neo12242/RykerConnect/Hardware/REV05C-12V/PRD.md

# 12V cost reduction

User authorization: "keep trying to get closer to $100 without losing any function."

1. Problem: five REV05-12V carriers quote at $126.65 before shipping/tax; feeder fees dominate.
2. Success: move toward $100, preferably below, preserving all user-facing functions and protection.
3. Scope: qualify equivalent lower-fee components; calculate savings against the actual order; prepare a clearly identified quote/review BOM.
4. Out of scope: removing RTC, battery backup, sensors, sockets, protection, or factory assembly; orders/payments.
5. Constraints: keep original manufacturing package intact; do not present an unvalidated alternate as production-ready.
6. Approach: Basic passive replacements first; Basic crystal subject to manufacturer footprint/keepout; protection substitutions only after electrical checks.
7. Implementation: compare primary datasheets/catalog; record quantities/prices/fee classes; produce candidate BOM and cost breakdown. Native design changes and manufacturing release require completed electrical/layout validation.
8. Risks: Basic/Preferred classification can change; quote attrition and loading exemptions affect savings; price estimates are not checkout quotes.
9. Open questions: final cart total and shipping/tax remain unknown. No function removal is authorized.

Implemented: six Basic substitutions and validated crystal copper clearance. Estimated five-board total $105.30 before shipping/tax.
