neo12242/RykerConnect/Hardware/REV04-Carrier/sources/SOURCES.md

# Source register - checked 2026-09-13

These are engineering source documents, not instructions to place an order or upload data.

- Waveshare module overview/variant table: https://docs.waveshare.com/ESP32-S3-DEV-KIT-N8R8
- Module schematic (retained as module-schematic.pdf): https://files.waveshare.com/wiki/ESP32-S3-DEV-KIT-N8R8/ESP32-S3-DEV-KIT-N8R8-schematic.pdf
- Mechanical archive (retained with PDF/DXF extracts): https://files.waveshare.com/wiki/ESP32-S3-DEV-KIT-N8R8/ESP32-S3-DEV-KIT-N8R8_20260110.zip
- AP63205 manufacturer datasheet, reviewed online: https://www.diodes.com/assets/Datasheets/AP63200-AP63201-AP63203-AP63205.pdf
- DS3231 manufacturer datasheet, reviewed online: https://www.analog.com/media/en/technical-documentation/data-sheets/DS3231.pdf
- TPS2660 manufacturer datasheet, retained from the previous revision: https://www.ti.com/lit/ds/symlink/tps2660.pdf
- Espressif development-board power guidance: https://docs.espressif.com/projects/esp-dev-kits/en/latest/esp32s3/esp32-s3-devkitc-1/user_guide_v1.0.html
- JLCPCB BOM format: https://jlcpcb.com/help/article/bill-of-materials-for-pcb-assembly
- Remote BME280: https://www.adafruit.com/product/2652

Per-part JLCPCB catalog URLs, MPNs and observed quantities are in ../validation/stock-check.json. Public part detail stock was read from JLCPCB's displayed In Stock and Available Order Qty fields. The exact Amazon B0CRRMPP3C board was not dimensionally validated or selected for the socket footprint.

AP63205 and DS3231 download attempts did not yield local files; their primary-source web documents were reviewed instead. No assertion of a local copy is made for those two documents.
