neo12242/RykerConnect/Hardware/REV05C-12V/sources/SOURCES.md

# REV05 source evidence

Manufacturer datasheets were used for electrical pins, ratings and land patterns; documents are reference material, not task instructions.

- [pcf8563.pdf](https://www.nxp.com/docs/en/data-sheet/PCF8563.pdf)
- [tlv1117lv.pdf](https://www.ti.com/lit/ds/symlink/tlv1117lv.pdf)
- [abs07.pdf](https://abracon.com/Resonators/ABS07.pdf)
- [inductor.pdf](https://www.sunlordinc.com/uploads/files/20230303/MWSA-S%C2%A0series%C2%A0of%C2%A0SMD%C2%A0Power%C2%A0Inductor.pdf)
- [bav199.pdf](https://www.slkoric.com/upload/pdf/202511/%E5%B7%B2%E5%8E%8B%E7%BC%A9-BAV199-SOT-23.pdf)
- [Waveshare module drawings and schematic](https://docs.waveshare.com/ESP32-S3-DEV-KIT-N8R8/Resources-And-Documents)

The ABS07 PDF link was reviewed online; a local copy is not included. LCSC/JLCPCB identities, available quantities and tier-one prices were checked on 2026-09-13 and recorded in validation/stock-check.json. These are observations, not reservations or a final quote.

## Cost revision
Epson FC-135 replaces ABS07: https://download.epsondevice.com/td/pdf/app/FC-135_en.pdf
Basic part references and live observations: ../COST-CHANGES.md and ../validation/cost-catalog-observation.json. Unchanged component observations are inherited from the original release; replacement observations are current to this review.
