neo12242/RykerConnect/Hardware/REV02-Corrected/sources/molex.png

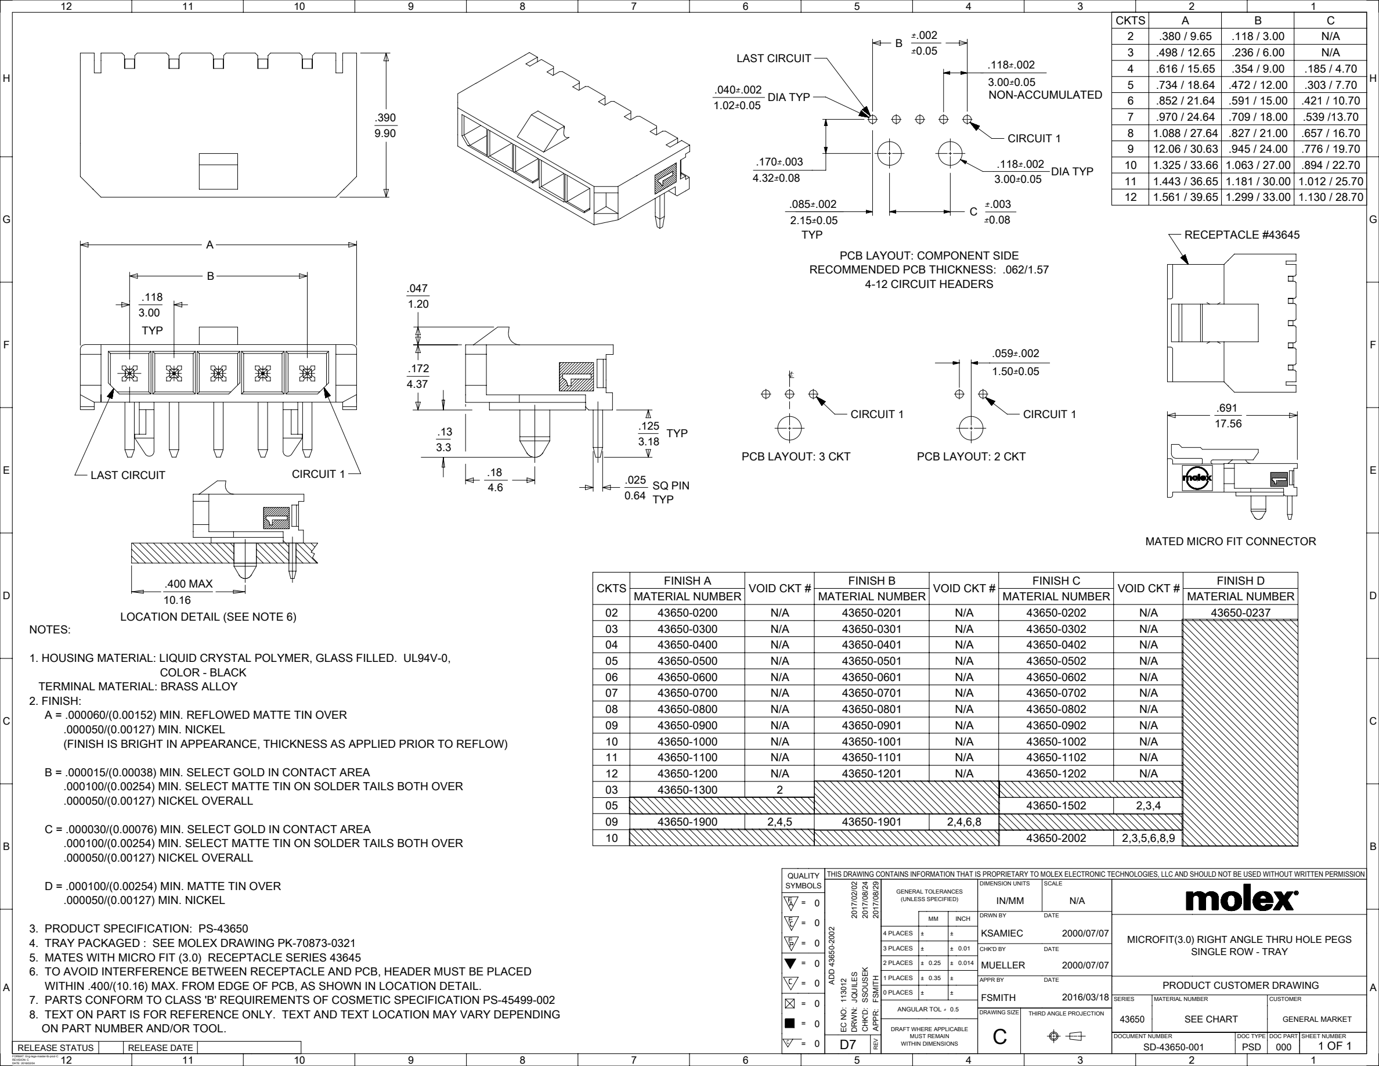
Hardware/REV02-Corrected/sources/molex.png
