neo12242/RykerConnect/Hardware/REV03-Protected/sources/lm7480-reference.png

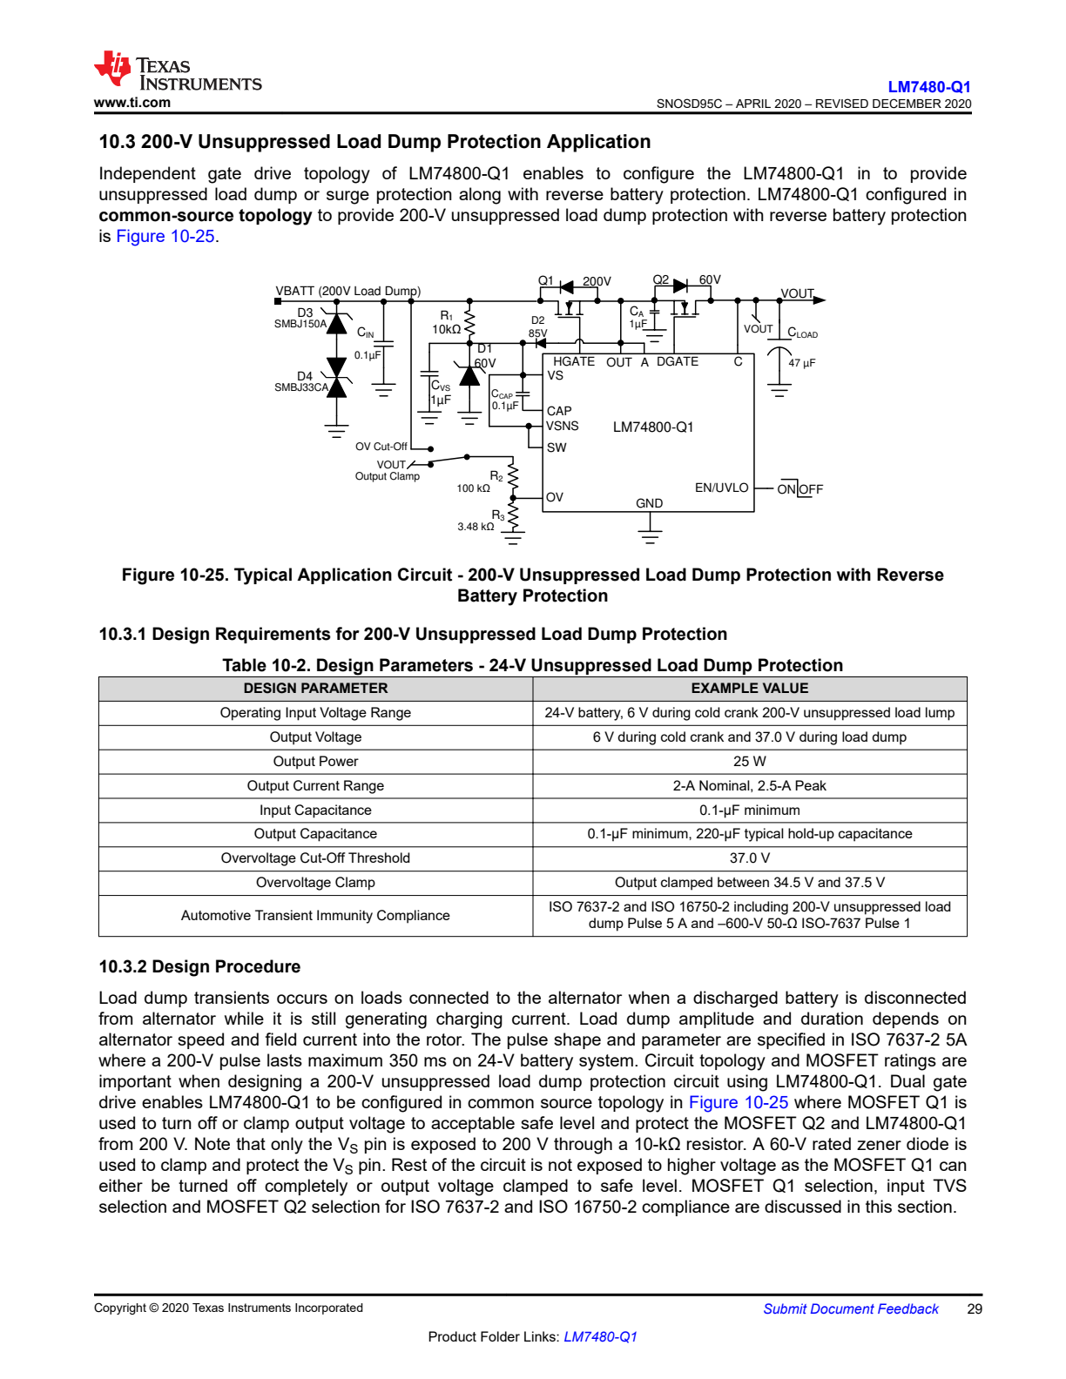
Hardware/REV03-Protected/sources/lm7480-reference.png
