neo12242/RykerConnect/Hardware/REV03-Protected/sources/tps-4.png

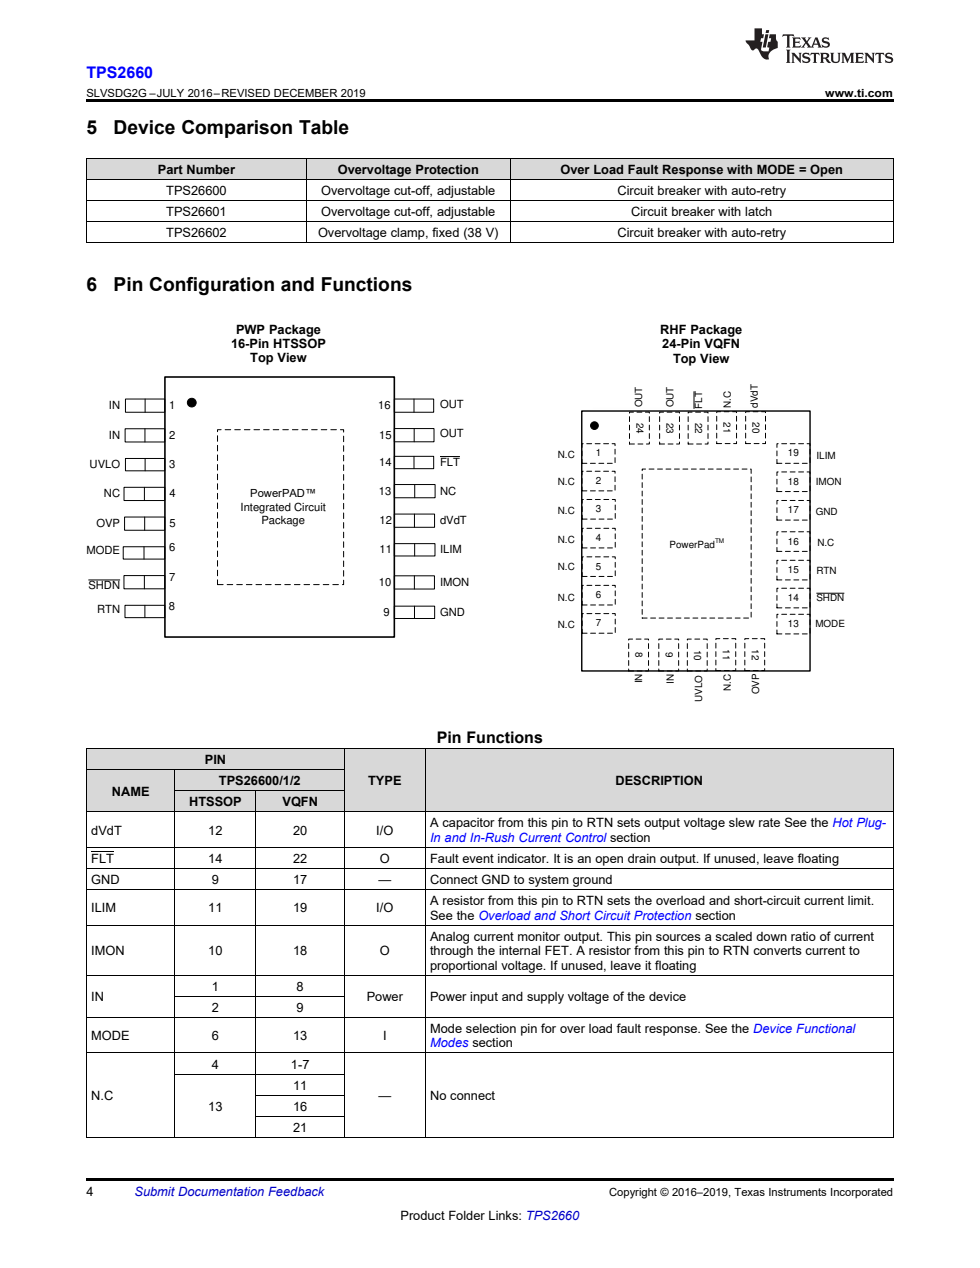
Hardware/REV03-Protected/sources/tps-4.png
