neo12242/RykerConnect/Hardware/REV03-Protected/sources/tps-28.png

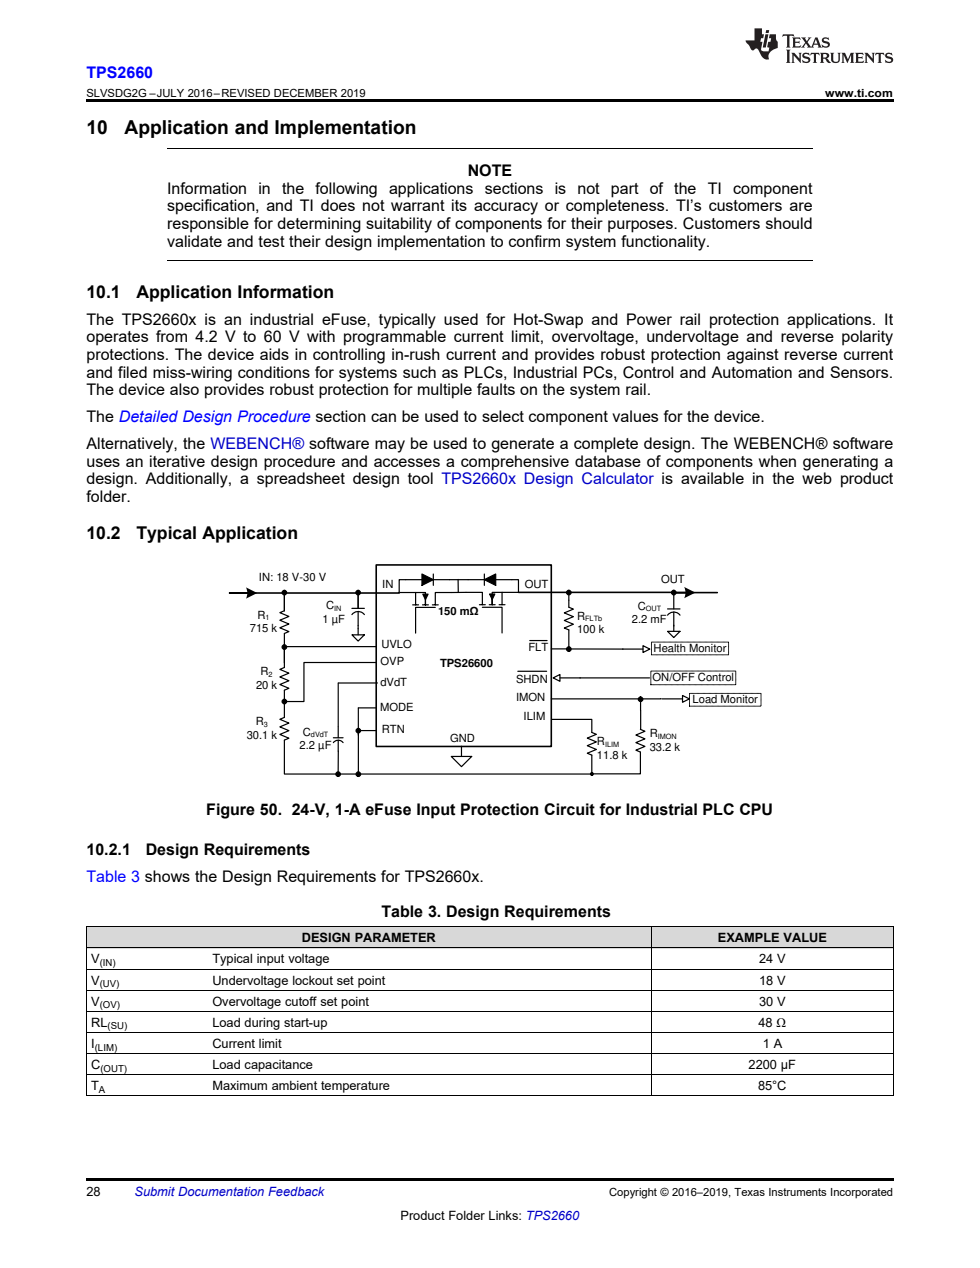
Hardware/REV03-Protected/sources/tps-28.png
