neo12242/RykerConnect/Hardware/REV03-Protected/sources/tps-40.png

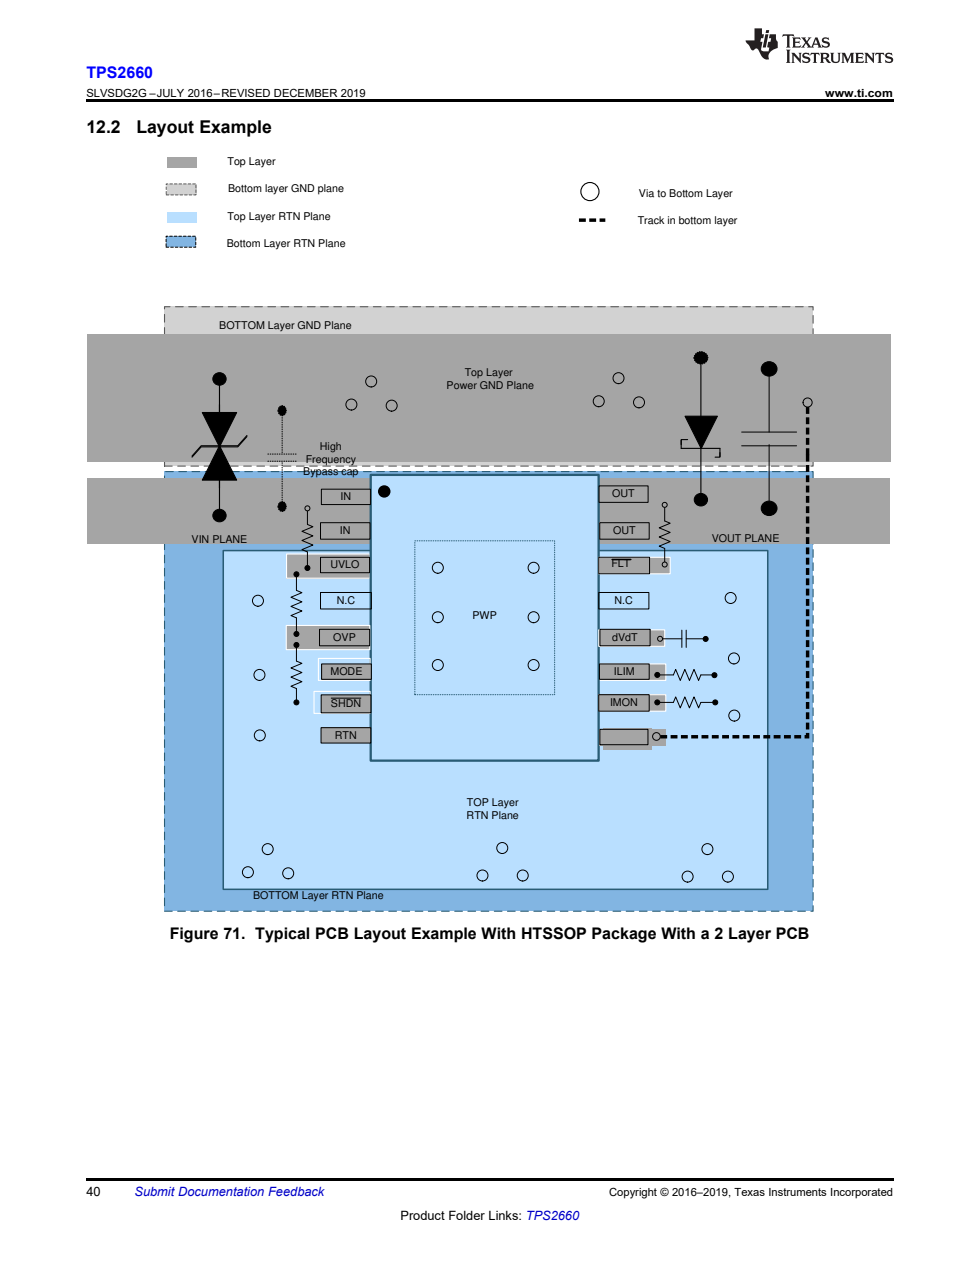
Hardware/REV03-Protected/sources/tps-40.png
