neo12242/RykerConnect/Hardware/REV03-Protected/sources/tps-49.png

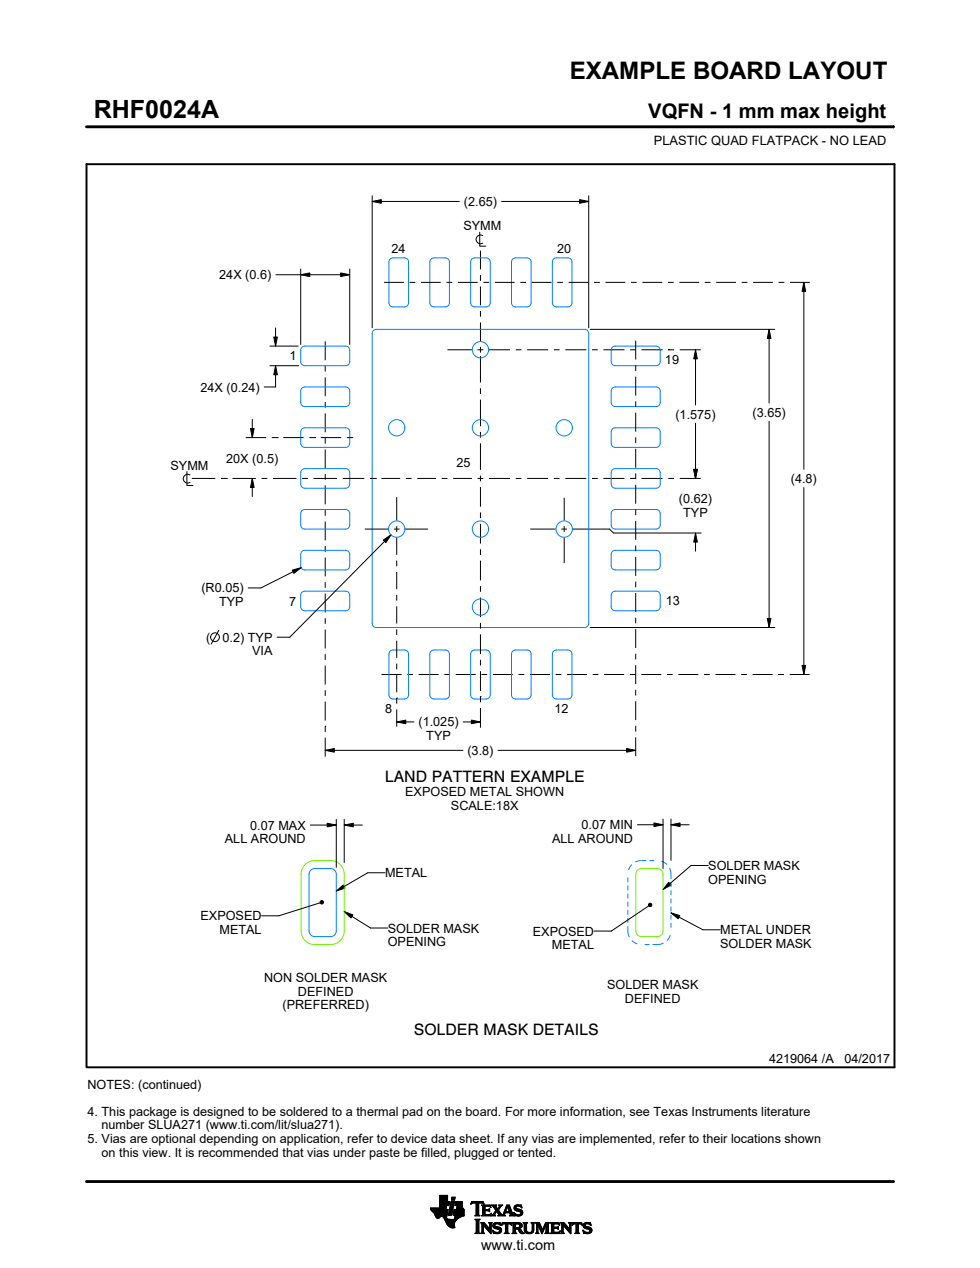
Hardware/REV03-Protected/sources/tps-49.png
