neo12242/RykerConnect/Hardware/REV03-Protected/sources/tps-pwp-land.png

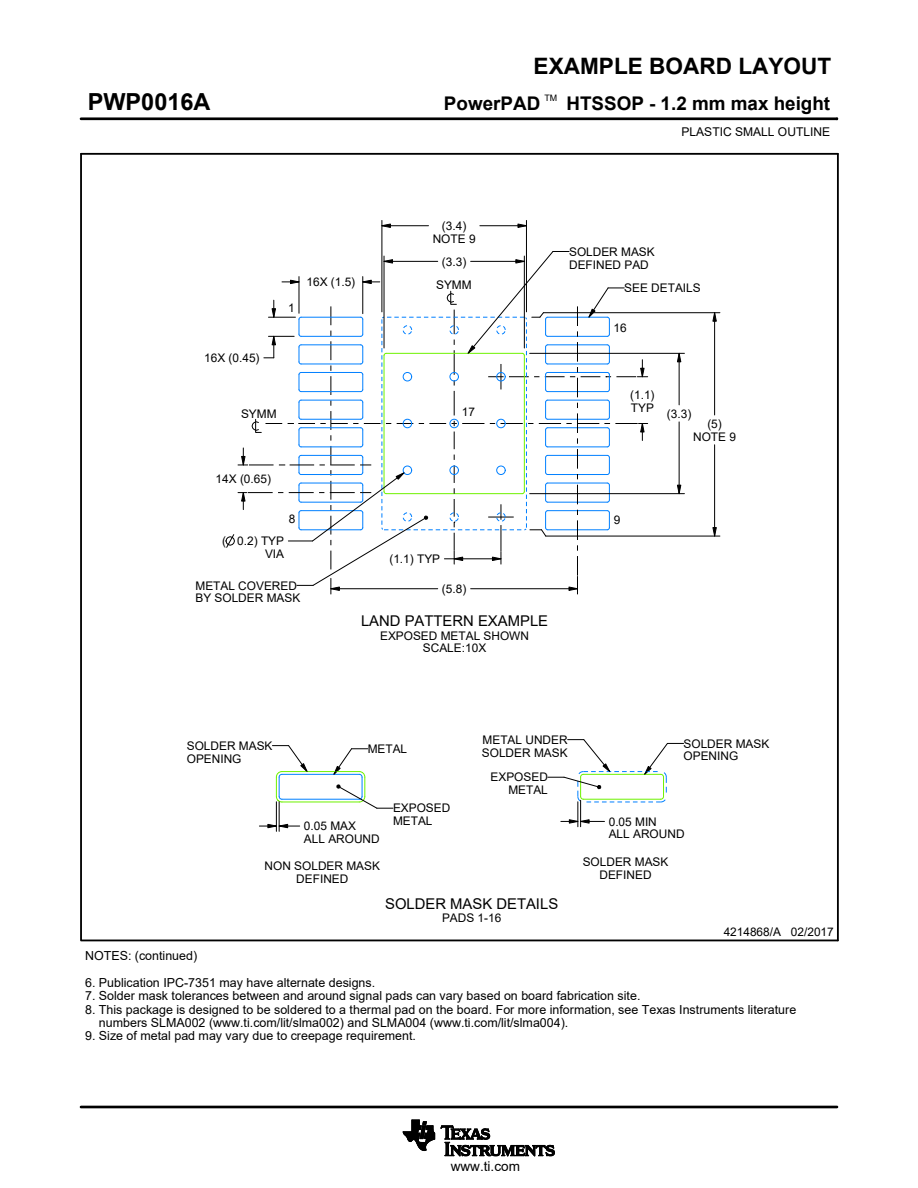
Hardware/REV03-Protected/sources/tps-pwp-land.png
