neo12242/RykerConnect/Hardware/REV03-Protected/validation/protection-schematic.png

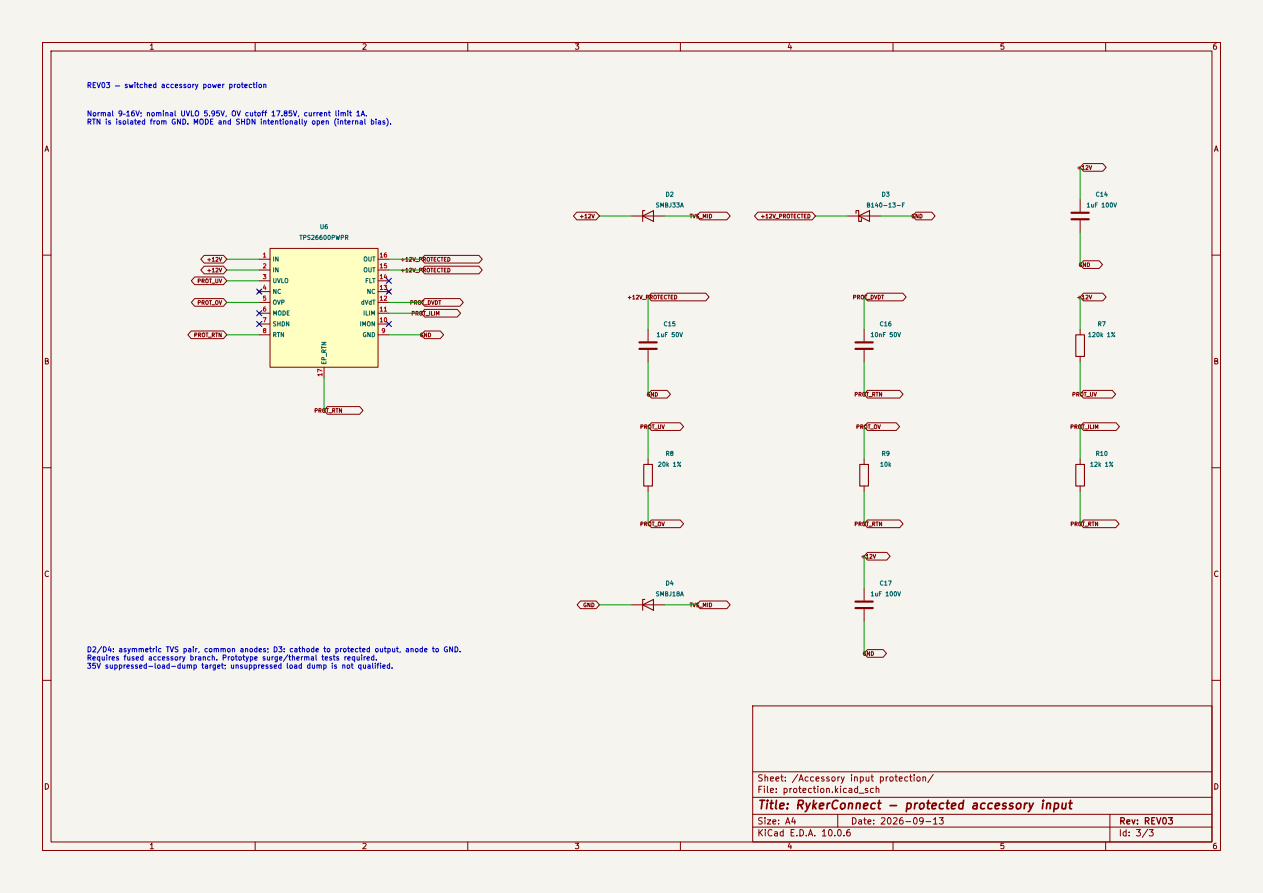
Hardware/REV03-Protected/validation/protection-schematic.png
