neo12242/RykerConnect/Hardware/REV04-Carrier/sources/module-mechanical.png

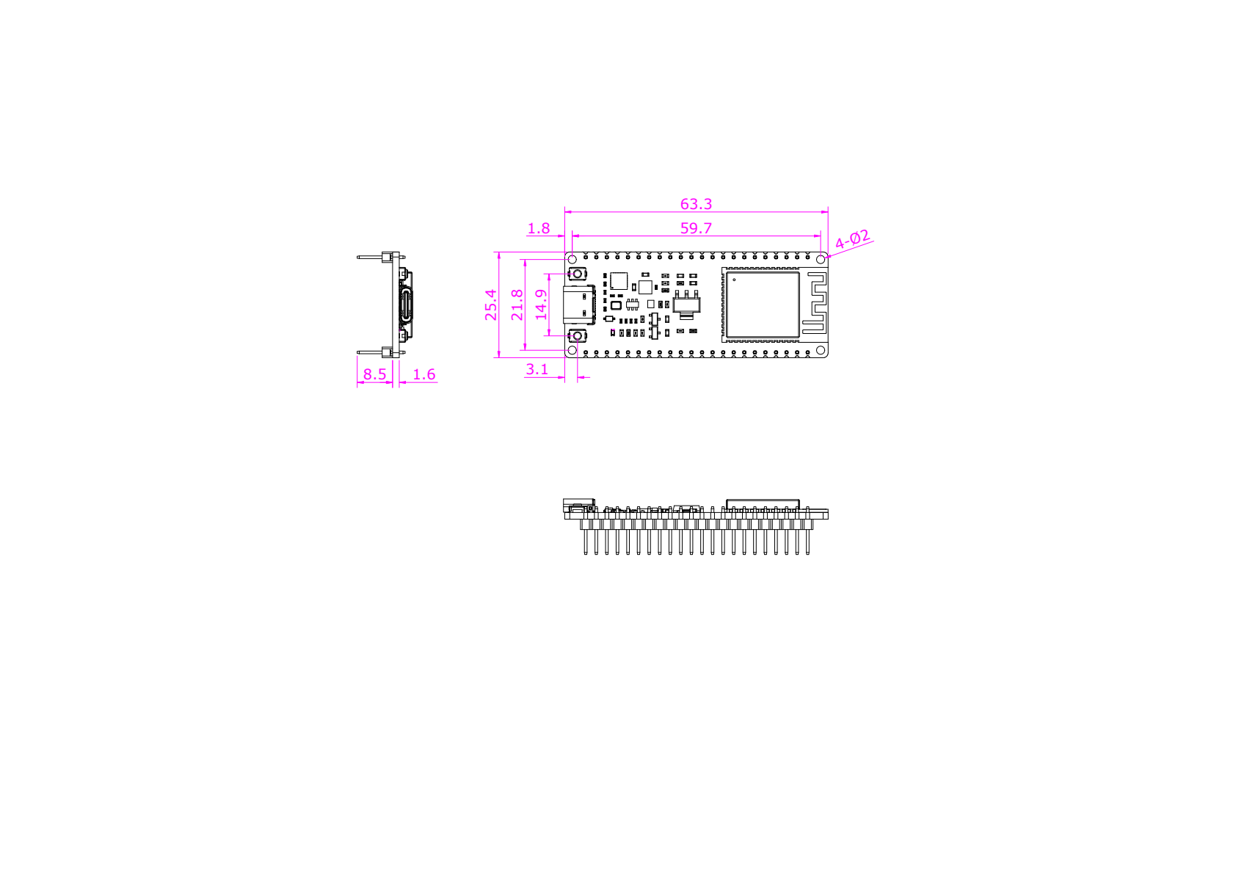
Hardware/REV04-Carrier/sources/module-mechanical.png
