neo12242/RykerConnect/Hardware/REV04-Carrier/sources/module-schematic.png

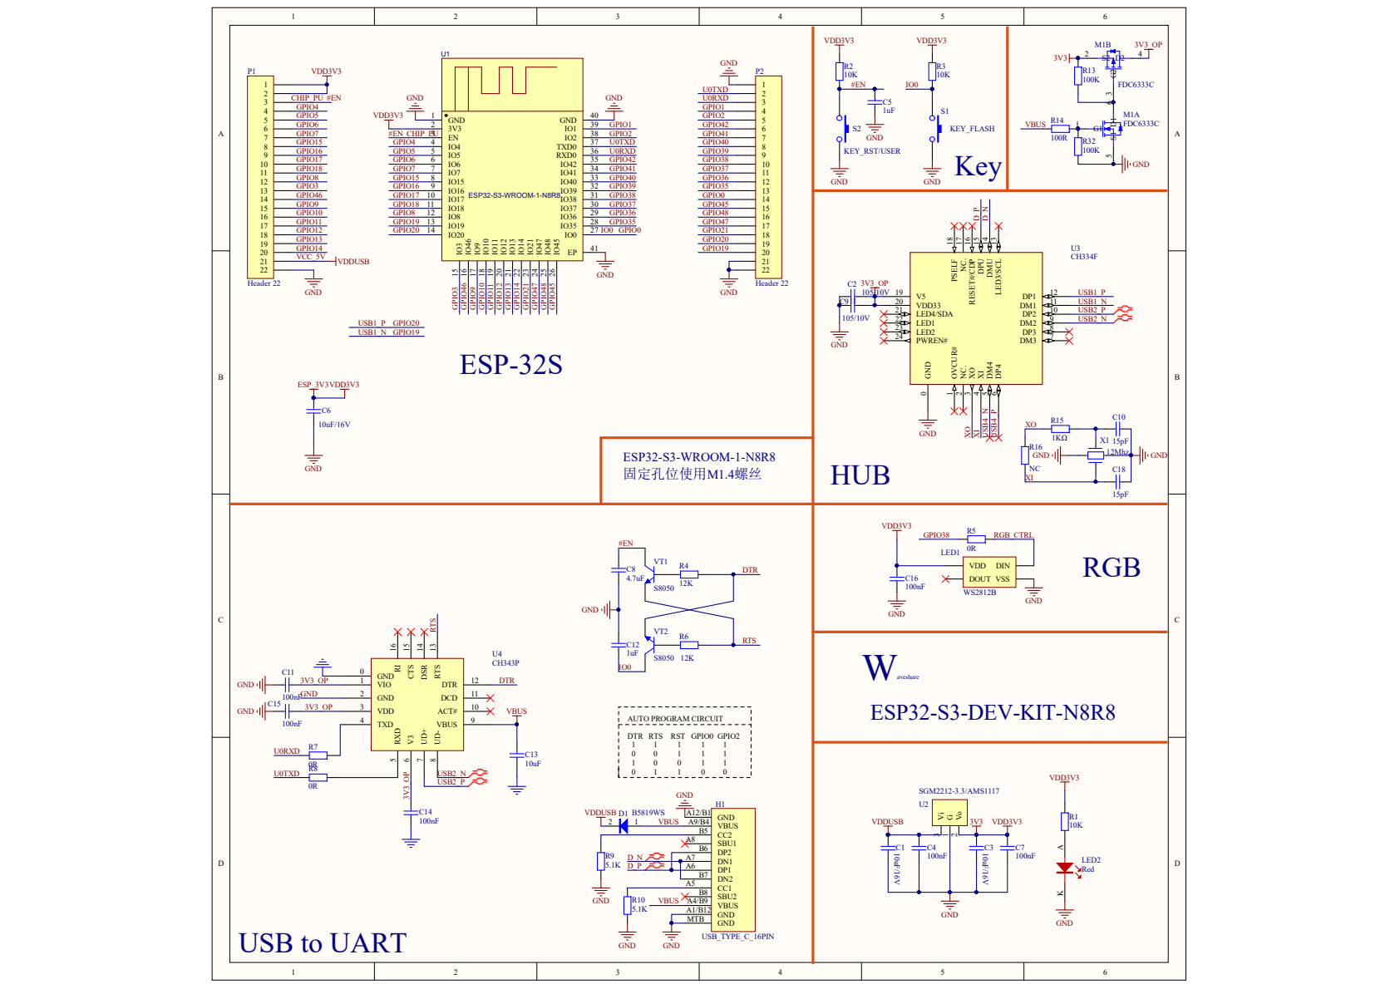
Hardware/REV04-Carrier/sources/module-schematic.png
