neo12242/RykerConnect/Hardware/REV04-Carrier/validation/schematic-1.png

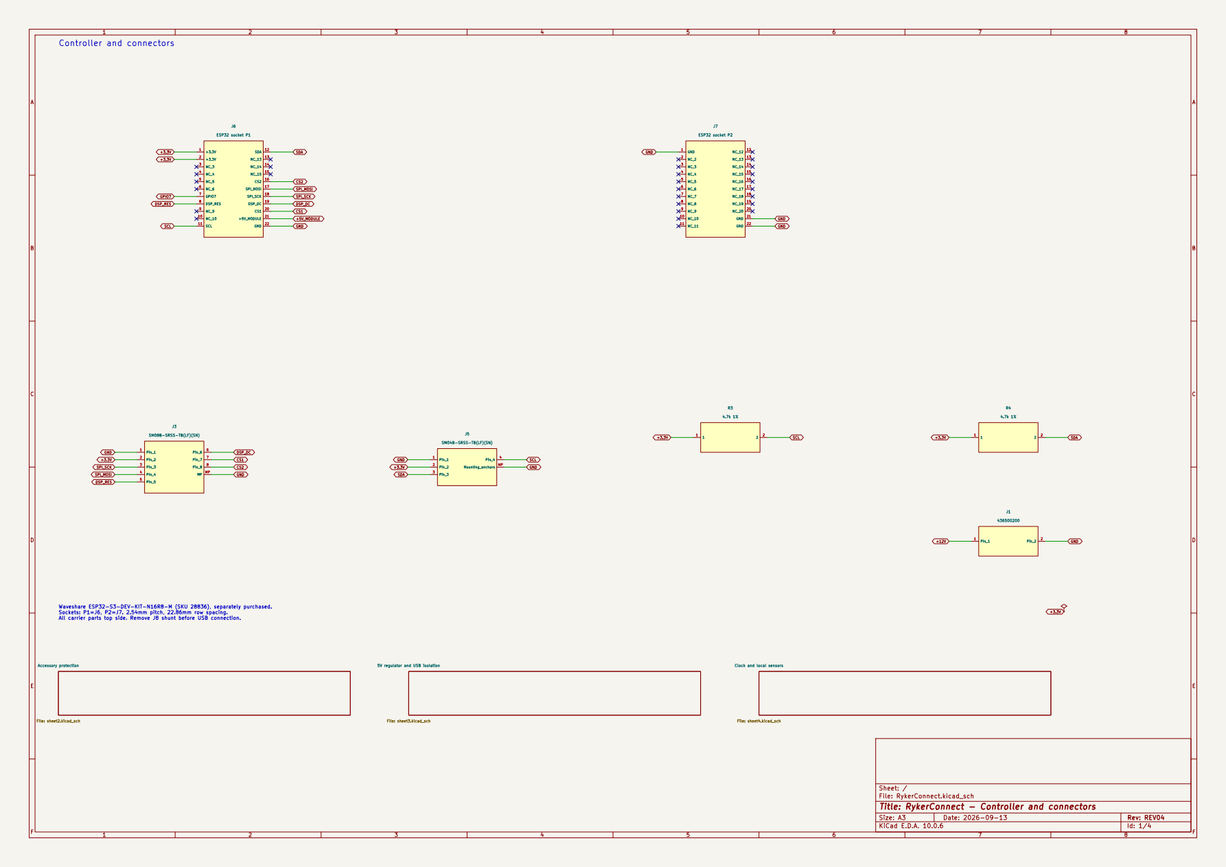
Hardware/REV04-Carrier/validation/schematic-1.png
