neo12242/RykerConnect/Hardware/REV04-Carrier/validation/schematic-2.png

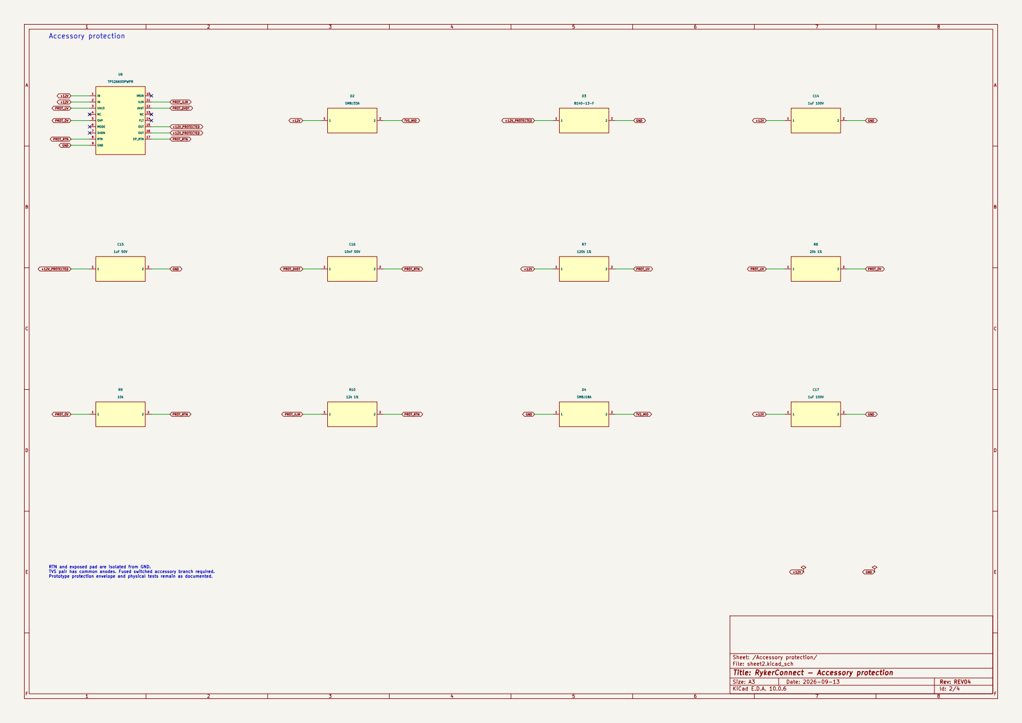
Hardware/REV04-Carrier/validation/schematic-2.png
