neo12242/RykerConnect/Hardware/REV04-Carrier/validation/schematic-3.png

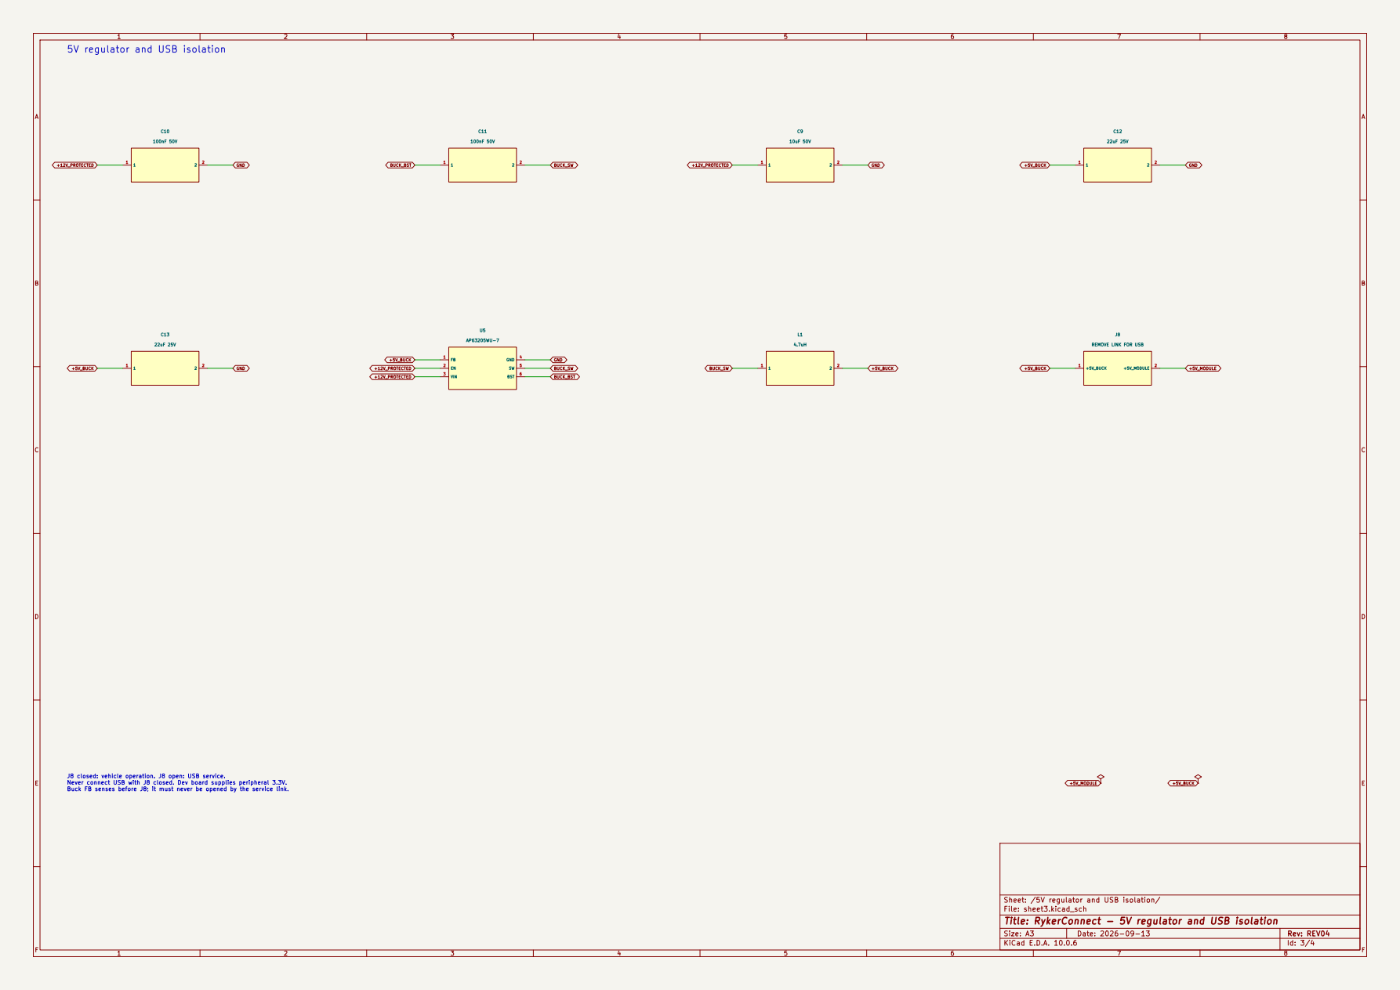
Hardware/REV04-Carrier/validation/schematic-3.png
