neo12242/RykerConnect/Hardware/REV04-Carrier/validation/schematic-4.png

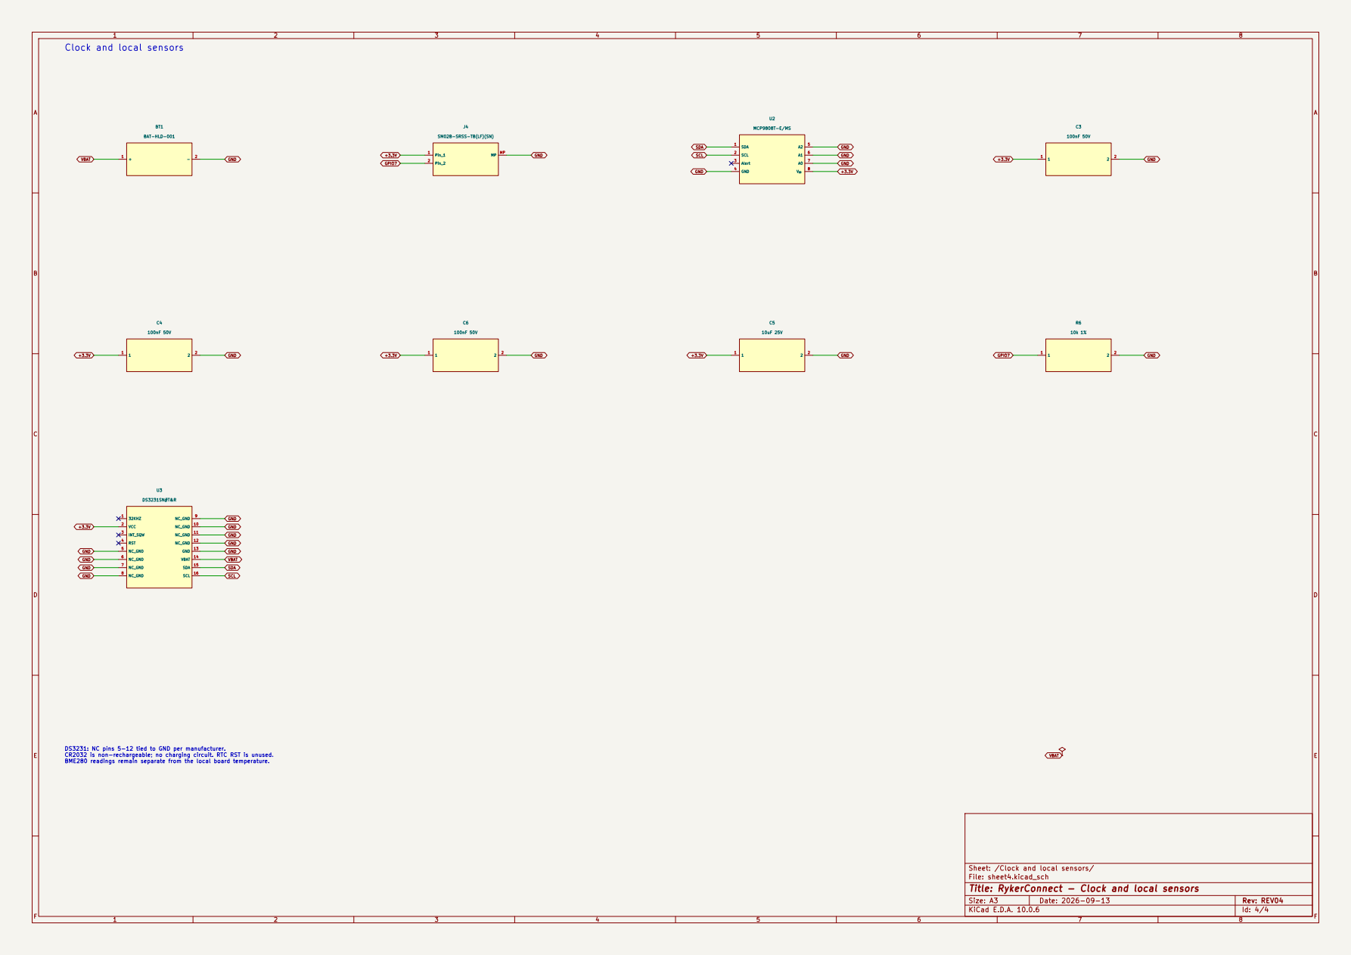
Hardware/REV04-Carrier/validation/schematic-4.png
