neo12242/RykerConnect/Hardware/REV05-12V/sources/bav199.png

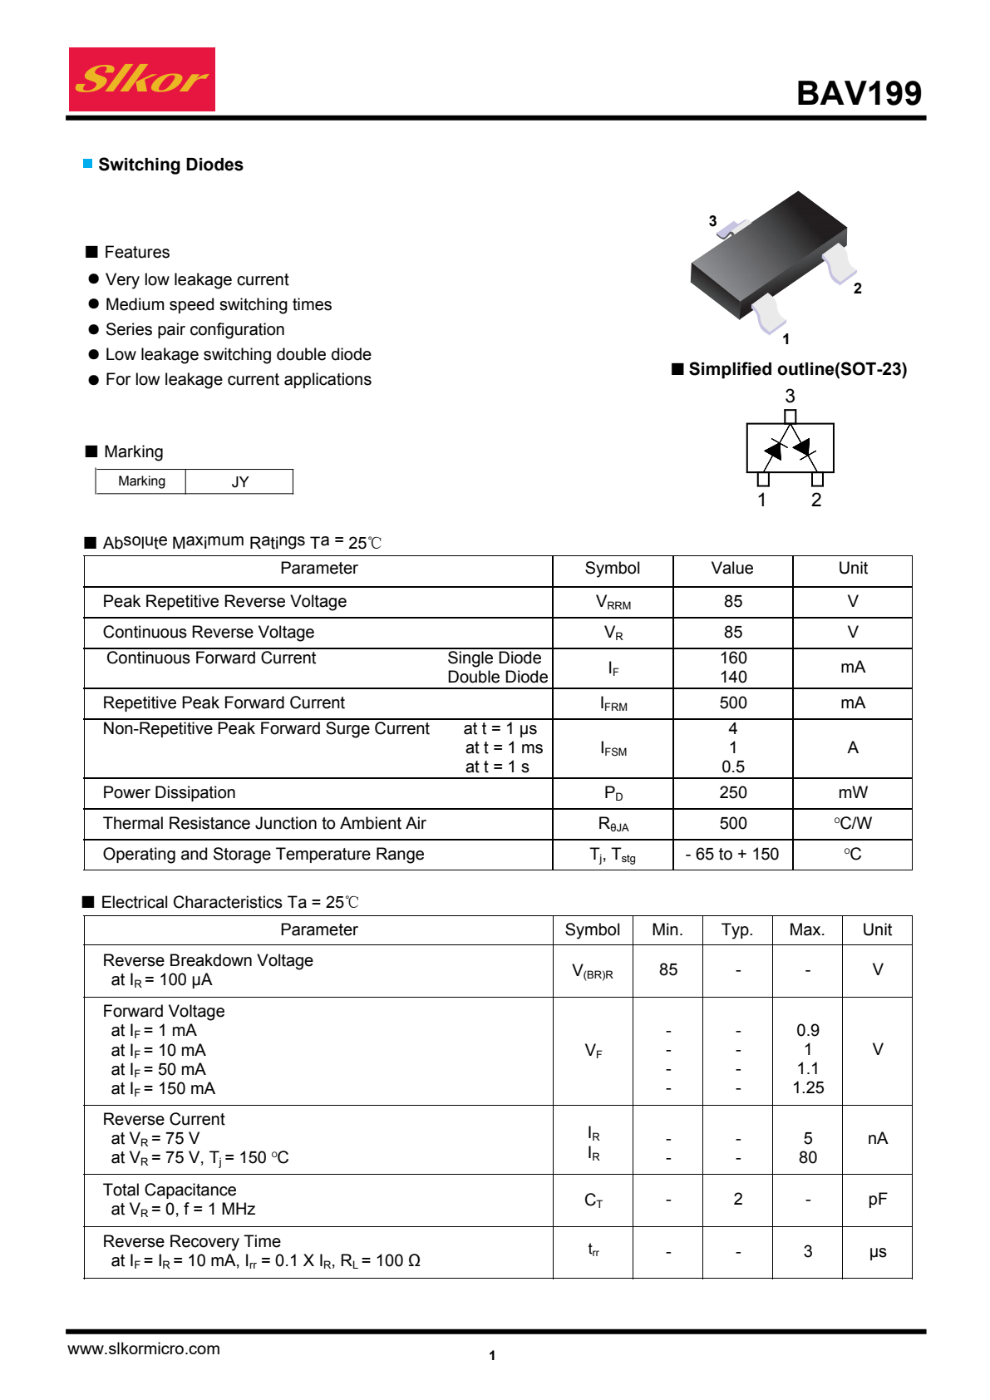
Hardware/REV05-12V/sources/bav199.png
