neo12242/RykerConnect/Hardware/REV05-12V/sources/inductor-land.png

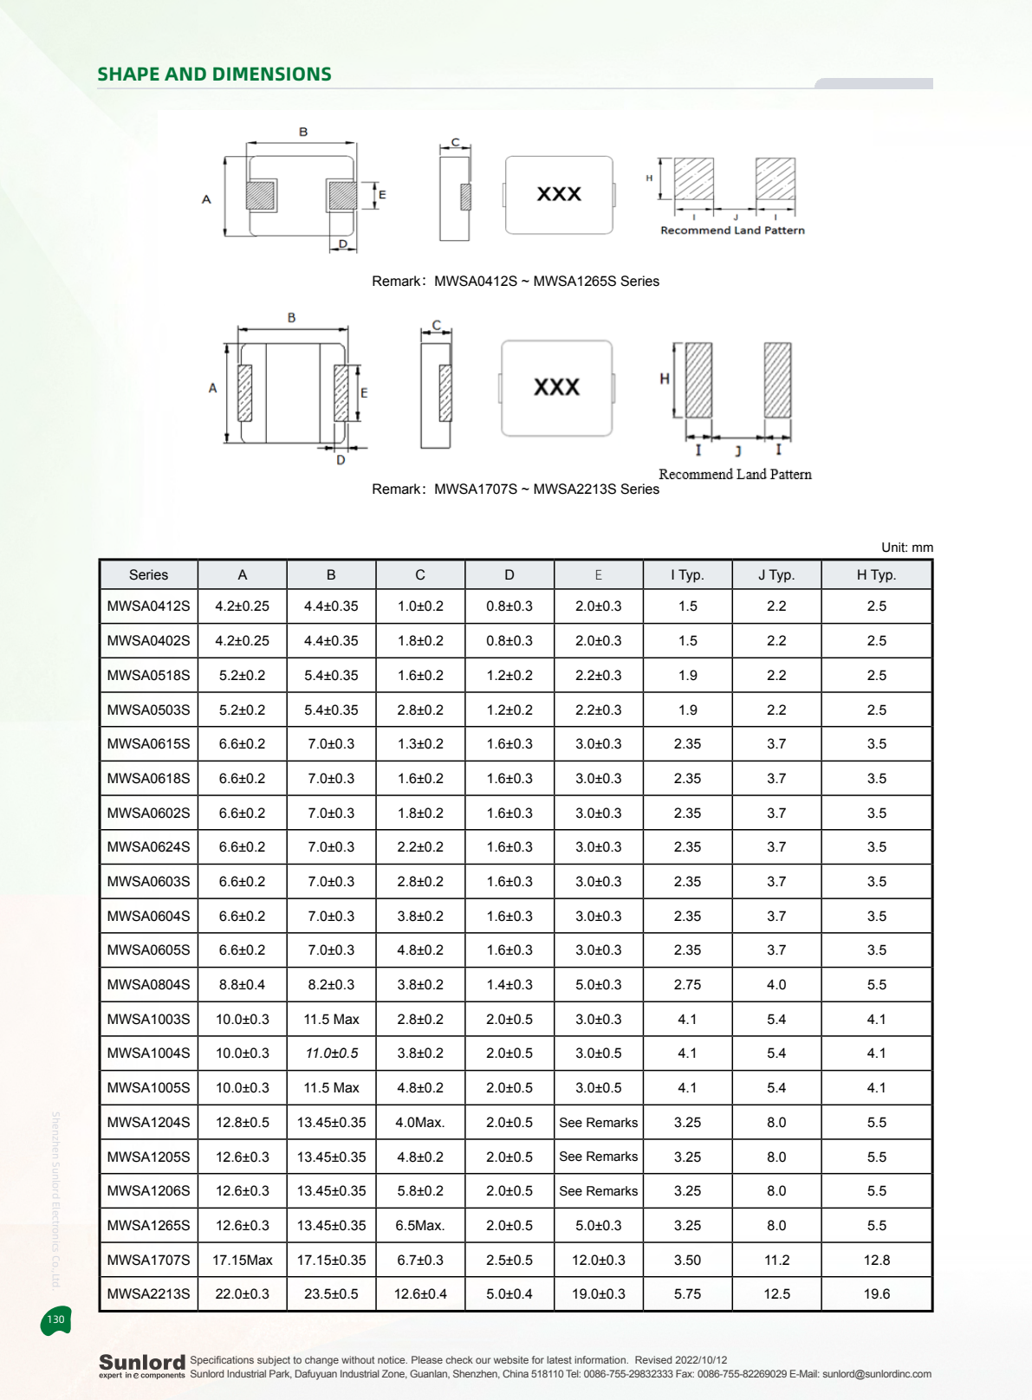
Hardware/REV05-12V/sources/inductor-land.png
