neo12242/RykerConnect/Hardware/REV05-12V/validation/schematic-4.png

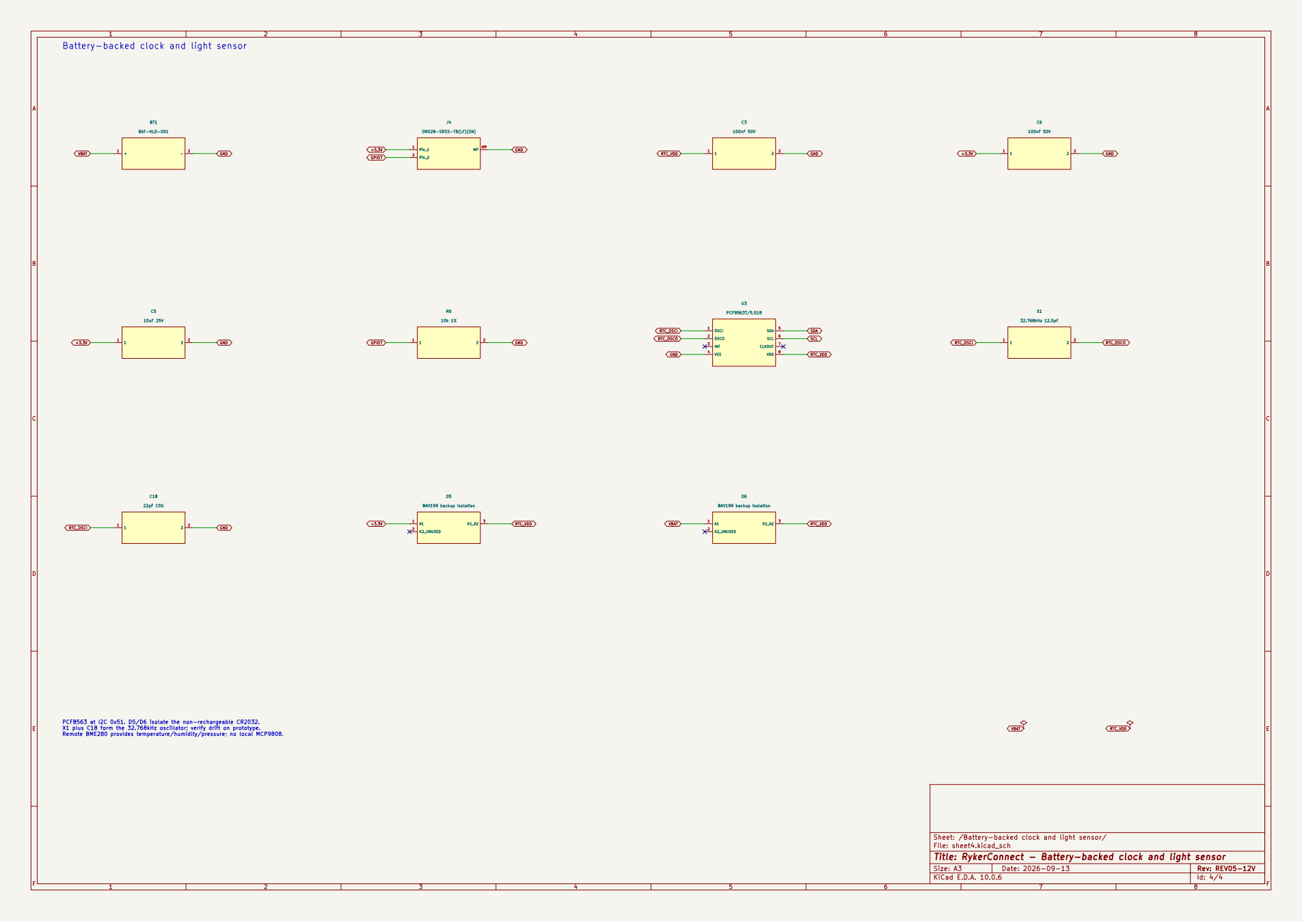
Hardware/REV05-12V/validation/schematic-4.png
