neo12242/RykerConnect/Hardware/REV05-USB/validation/schematic-2.png

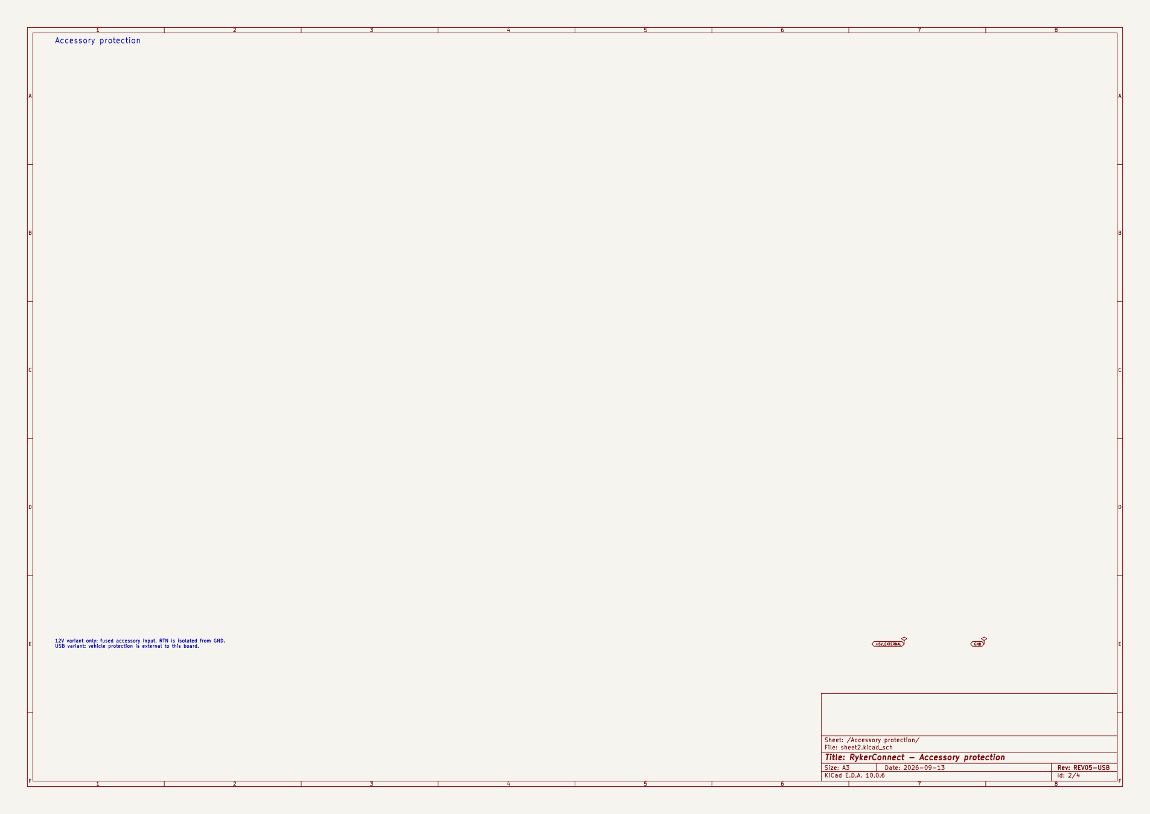
Hardware/REV05-USB/validation/schematic-2.png
