neo12242/RykerConnect/Hardware/REV05-USB/validation/schematic-3.png

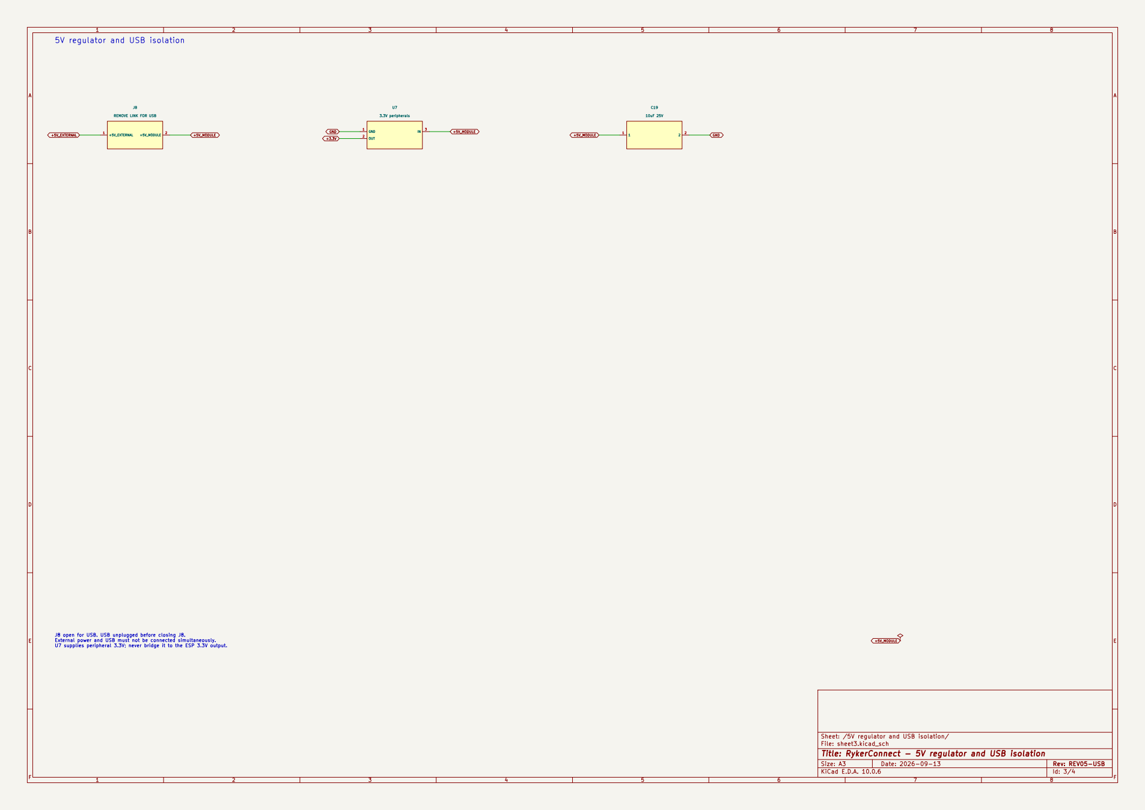
Hardware/REV05-USB/validation/schematic-3.png
