neo12242/RykerConnect/Hardware/REV05C-12V/validation/schematic-2.png

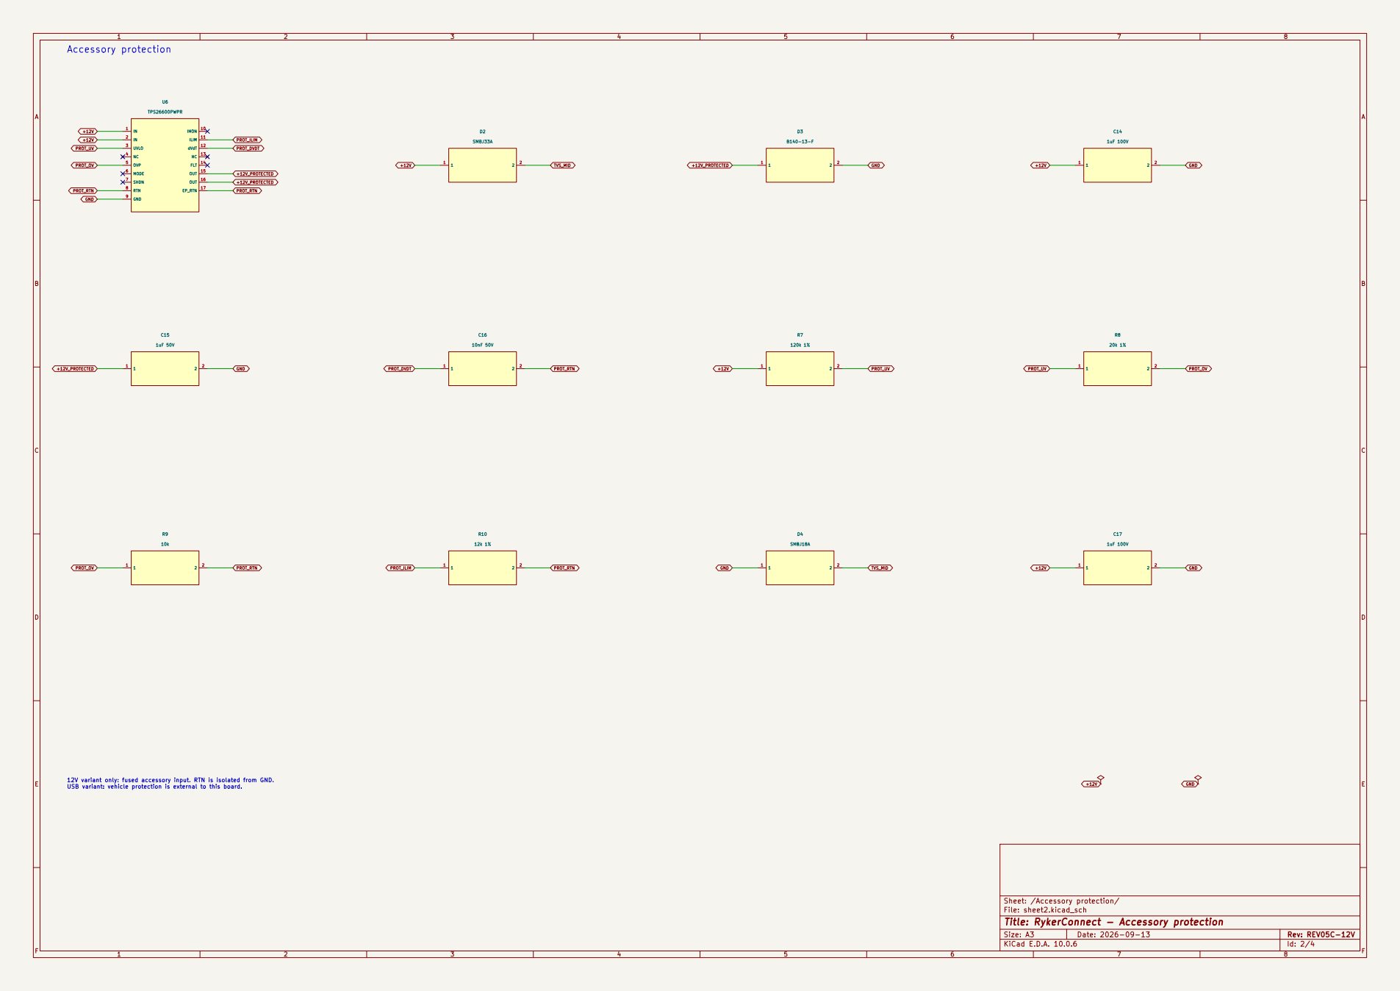
Hardware/REV05C-12V/validation/schematic-2.png
