neo12242/RykerConnect/Hardware/REV04-Carrier/sources/module.dxf

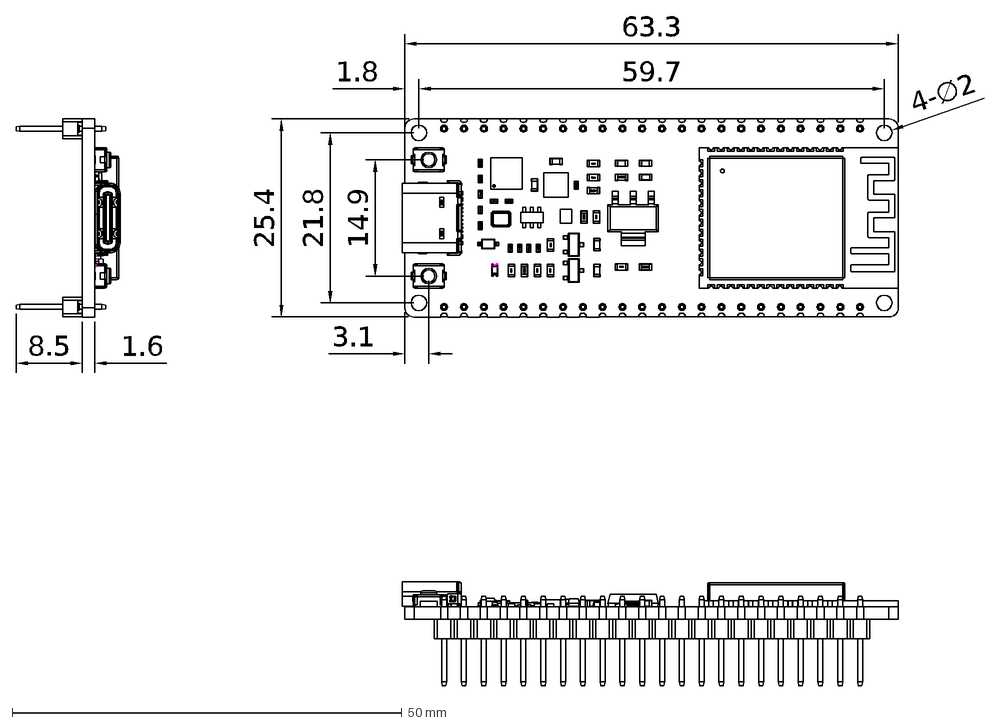
[picture p27: CAD file, 2026-09-16]
Hardware/REV04-Carrier/sources/module.dxf
63.3
21.8
25.4
14.9
4-∅2
59.7
1.8
1.6
8.5
3.1
