neo12242/RykerConnect/Hardware/REV03-Protected/validation/assembly-B.png

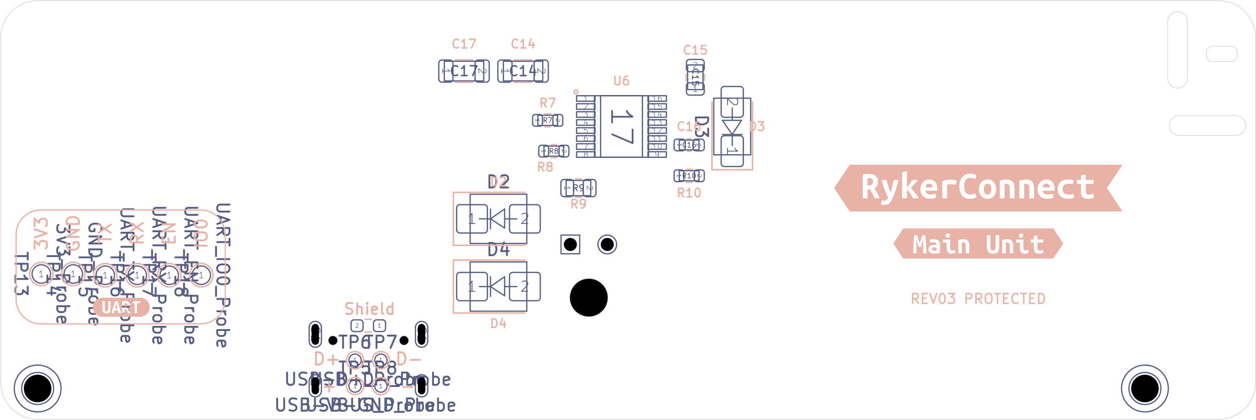
Hardware/REV03-Protected/validation/assembly-B.png
