neo12242/RykerConnect/Hardware/REV04-Carrier/validation/assembly-F.png

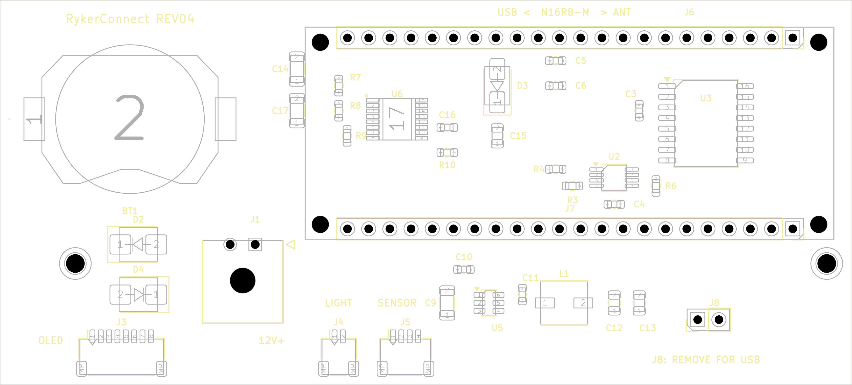
Hardware/REV04-Carrier/validation/assembly-F.png
