neo12242/RykerConnect/Hardware/REV05-12V/validation/assembly-F.png

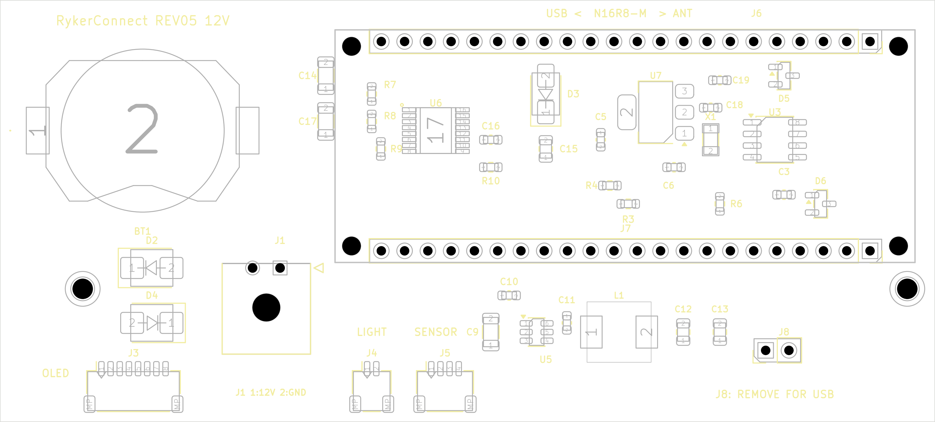
Hardware/REV05-12V/validation/assembly-F.png
