neo12242/RykerConnect/Hardware/REV05-USB/validation/assembly-F.png

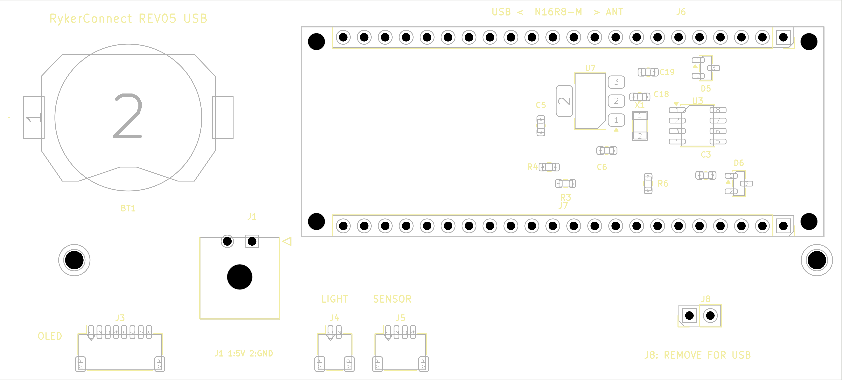
Hardware/REV05-USB/validation/assembly-F.png
