neo12242/RykerConnect/Hardware/REV02-Corrected/validation/before.png

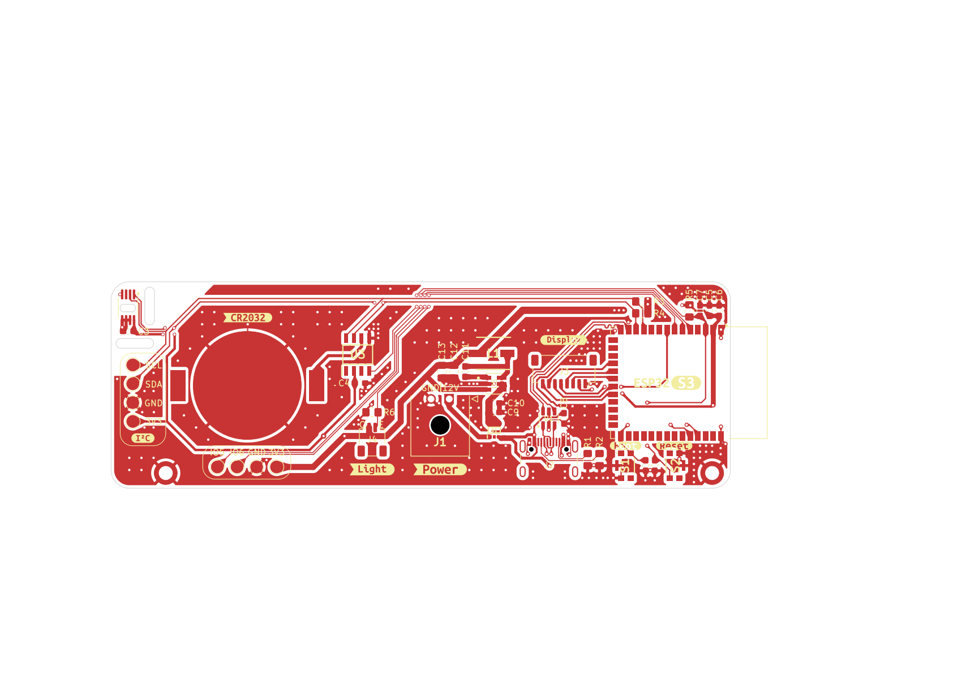
Hardware/REV02-Corrected/validation/before.png
