neo12242/RykerConnect/Hardware/REV03-Protected/validation/board-B.png

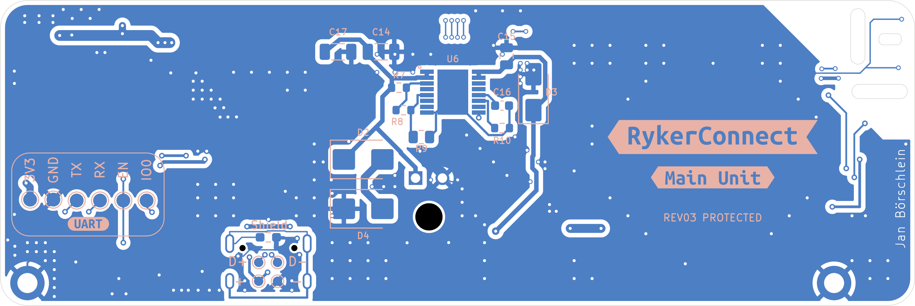
Hardware/REV03-Protected/validation/board-B.png
