neo12242/RykerConnect/Hardware/REV04-Carrier/validation/board-B.png

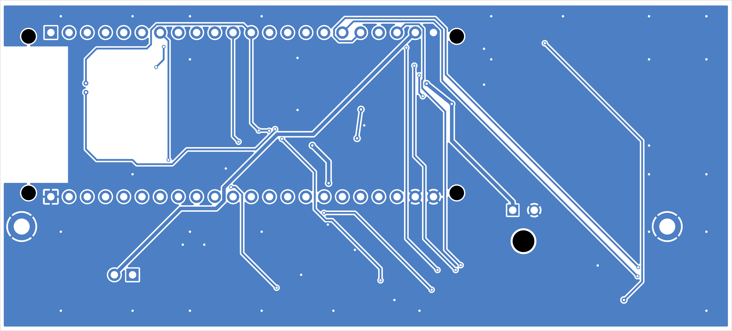
Hardware/REV04-Carrier/validation/board-B.png
