neo12242/RykerConnect/Hardware/REV04-Carrier/validation/board-F.png

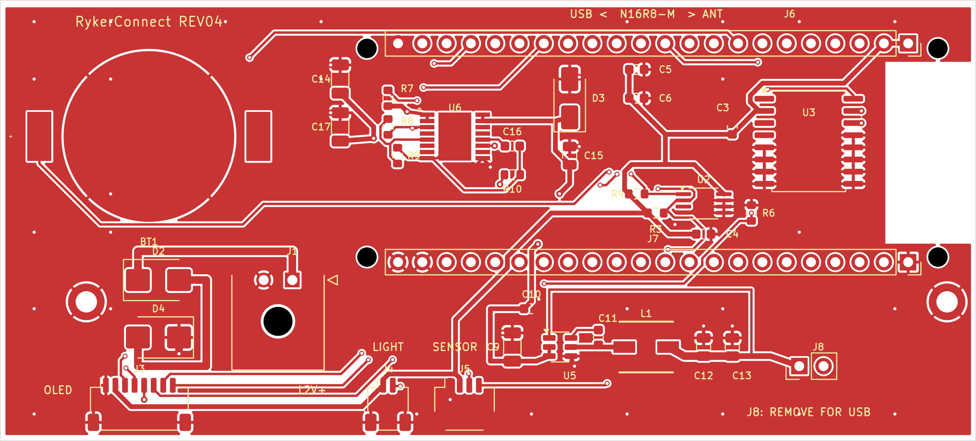
Hardware/REV04-Carrier/validation/board-F.png
