neo12242/RykerConnect/Hardware/REV02-Corrected/validation/schematics.pdf

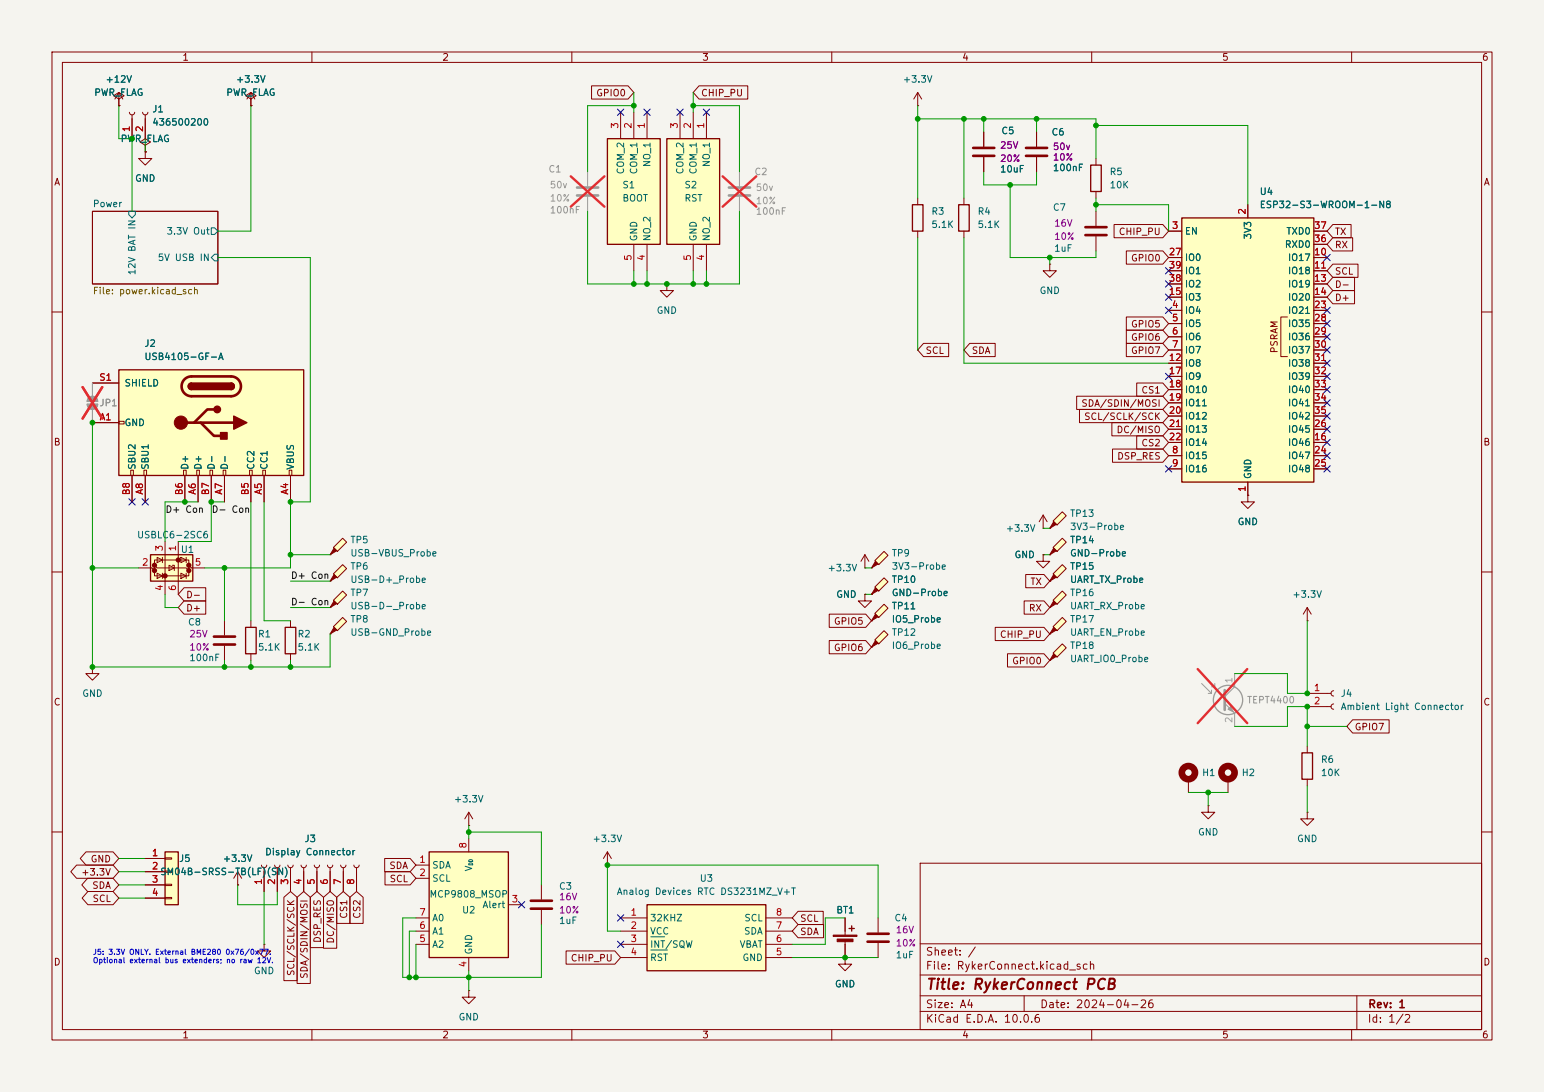
[picture p36: page 1]

1 COM_1
Ambient Light Connector +3.3V +3.3V GND NO_1

SCL SDA SCL/SCLK/SCK SDA/SDIN/MOSI

Analog Devices RTC DS3231MZ_V+T GND

J5: 3.3V ONLY. External BME280 0x76/0x77. Optional external bus extenders; no raw 12V.

Size: A4 | Rev: 1
KiCad E.D.A. 10.0.6 | Id: 1/2

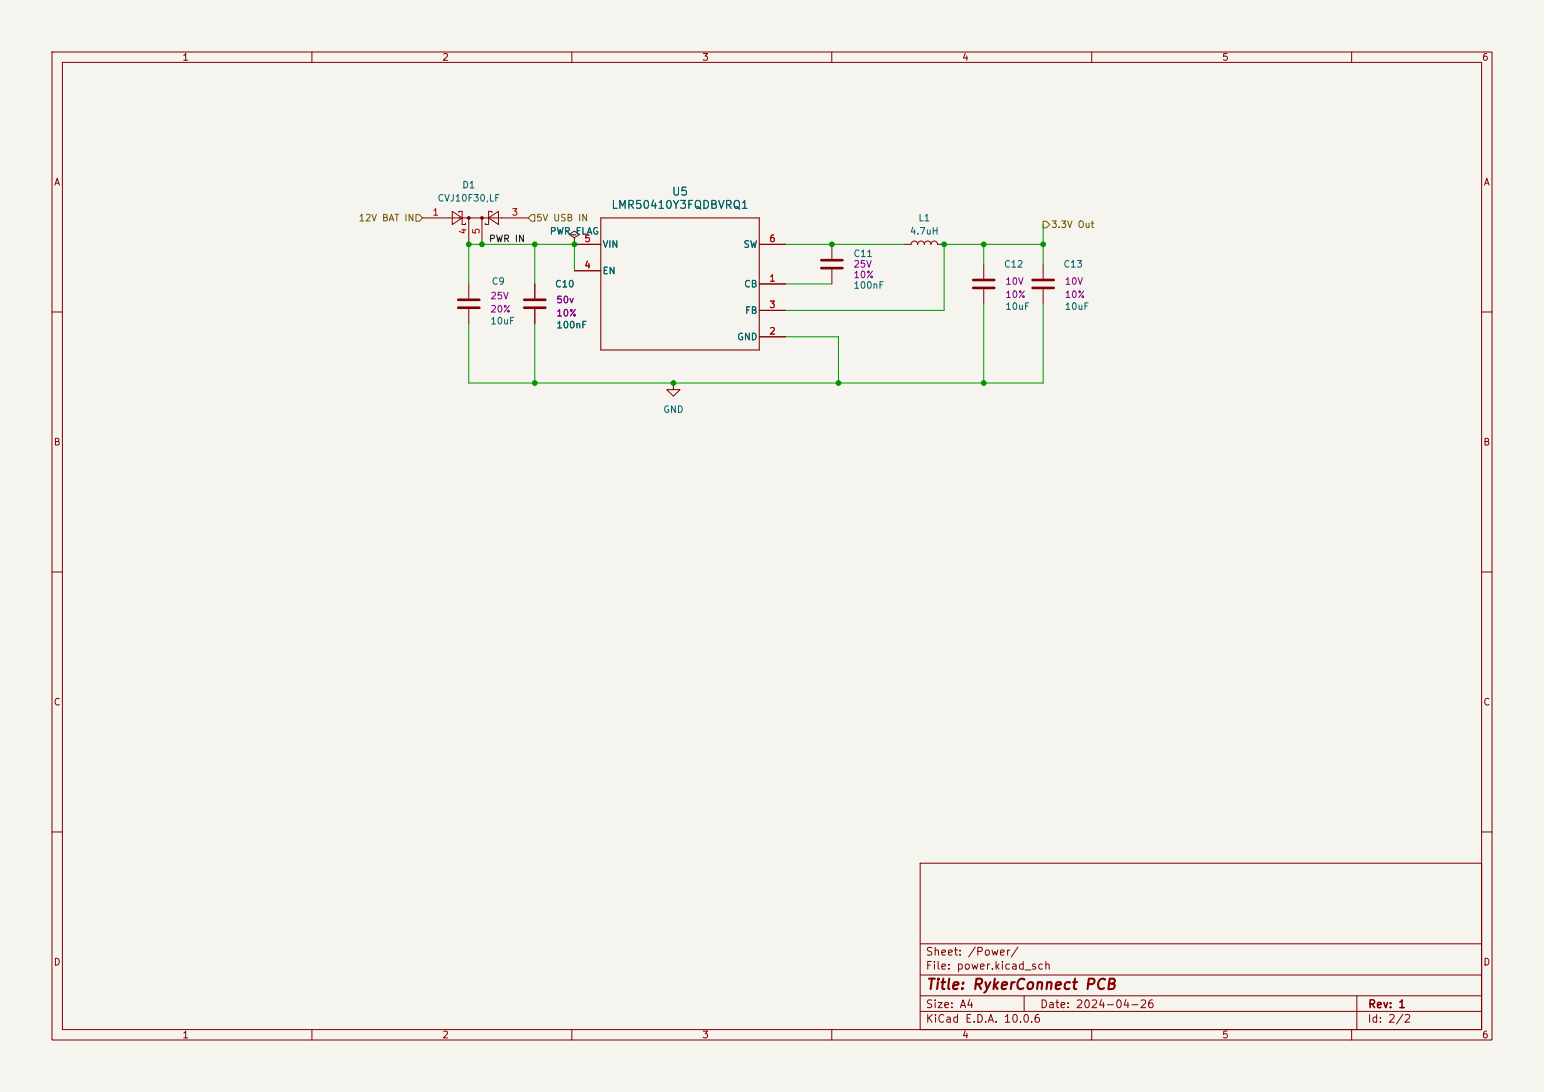
[picture p37: page 2]

4 D1 CVJ10F30,LF 3.3V Out 12V BAT IN 5V USB IN

Size: A4 | Rev: 1
KiCad E.D.A. 10.0.6 | Id: 2/2
