neo12242/RykerConnect/Hardware/REV03-Protected/validation/schematics.pdf

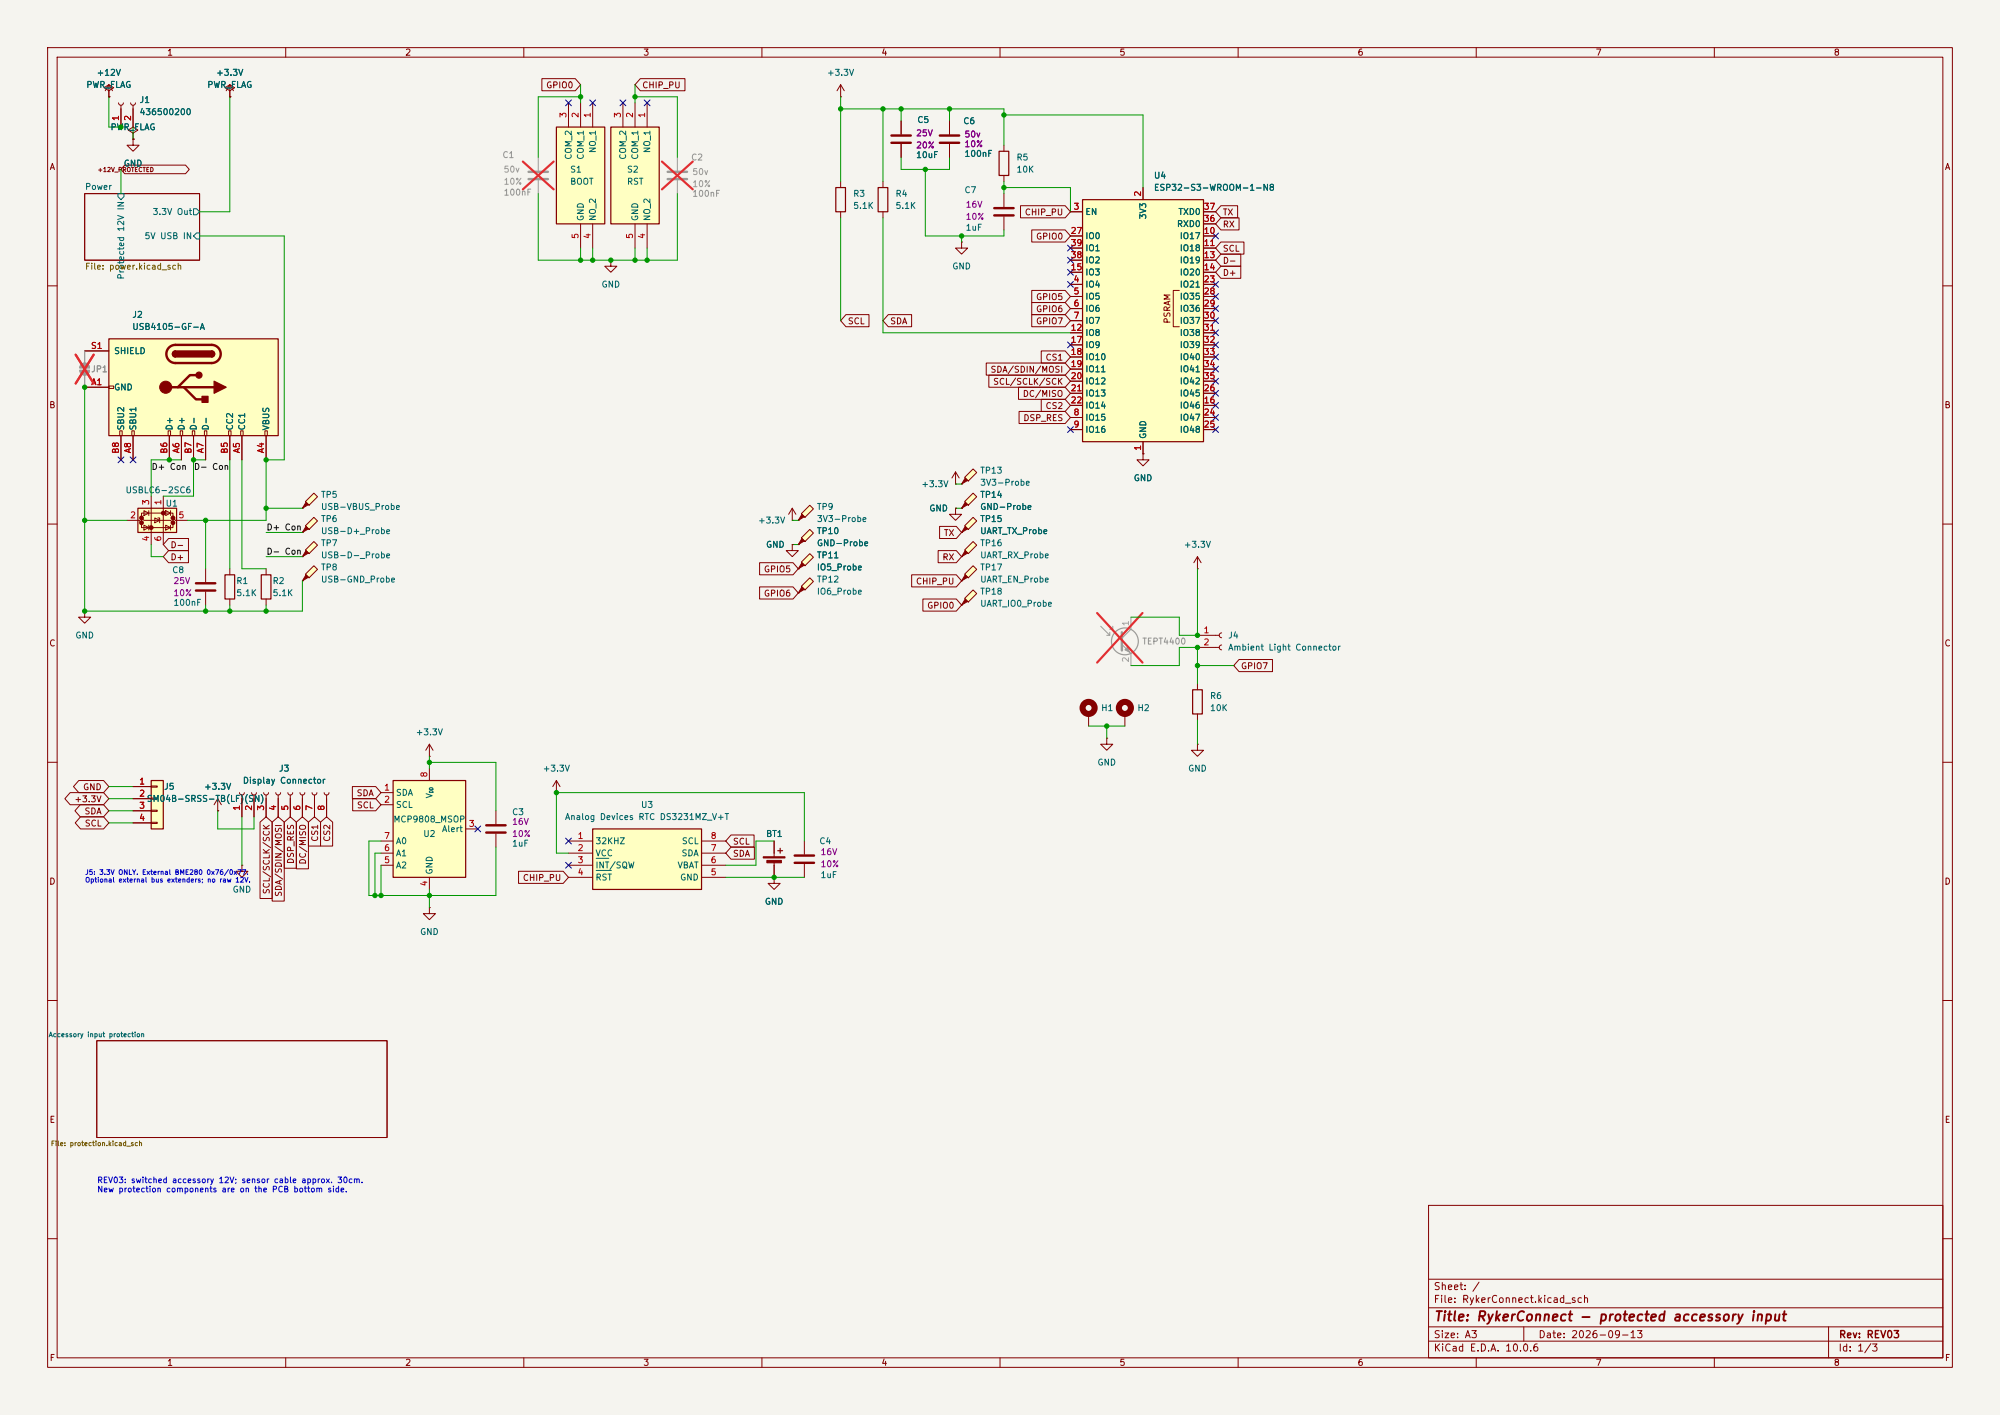
[picture p38: page 1]

SCL SDA CS1 DC/MISO

J5: 3.3V ONLY. External BME280 0x76/0x77. Optional external bus extenders; no raw 12V.

REV03: switched accessory 12V; sensor cable approx. 30cm. New protection components are on the PCB bottom side.

Sheet: /
File: RykerConnect.kicad_sch
Title: RykerConnect - protected accessory input

Size: A3 | Rev: REV03 | F Date: 2026-09-13
KiCad E.D.A. 10.0.6 | Id: 1/3

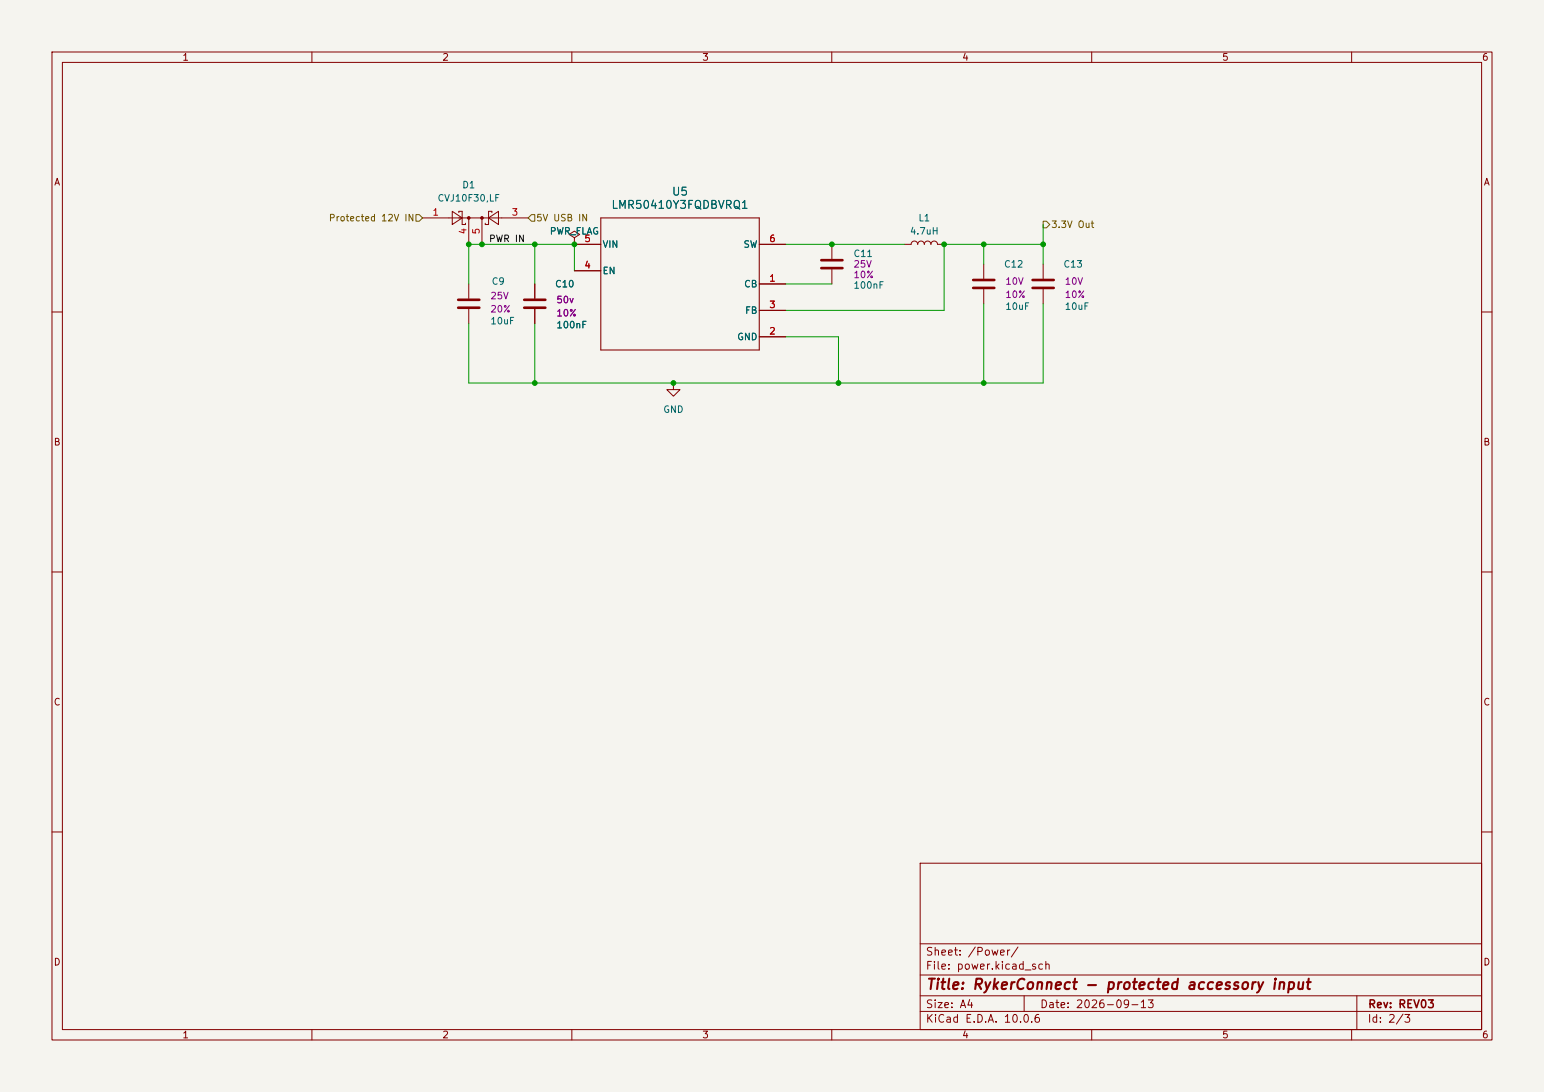
[picture p39: page 2]

4 D1 CVJ10F30,LF 3.3V Out Protected 12V IN 5V USB IN

Sheet: /Power/
File: power.kicad_sch
Title: RykerConnect - protected accessory input

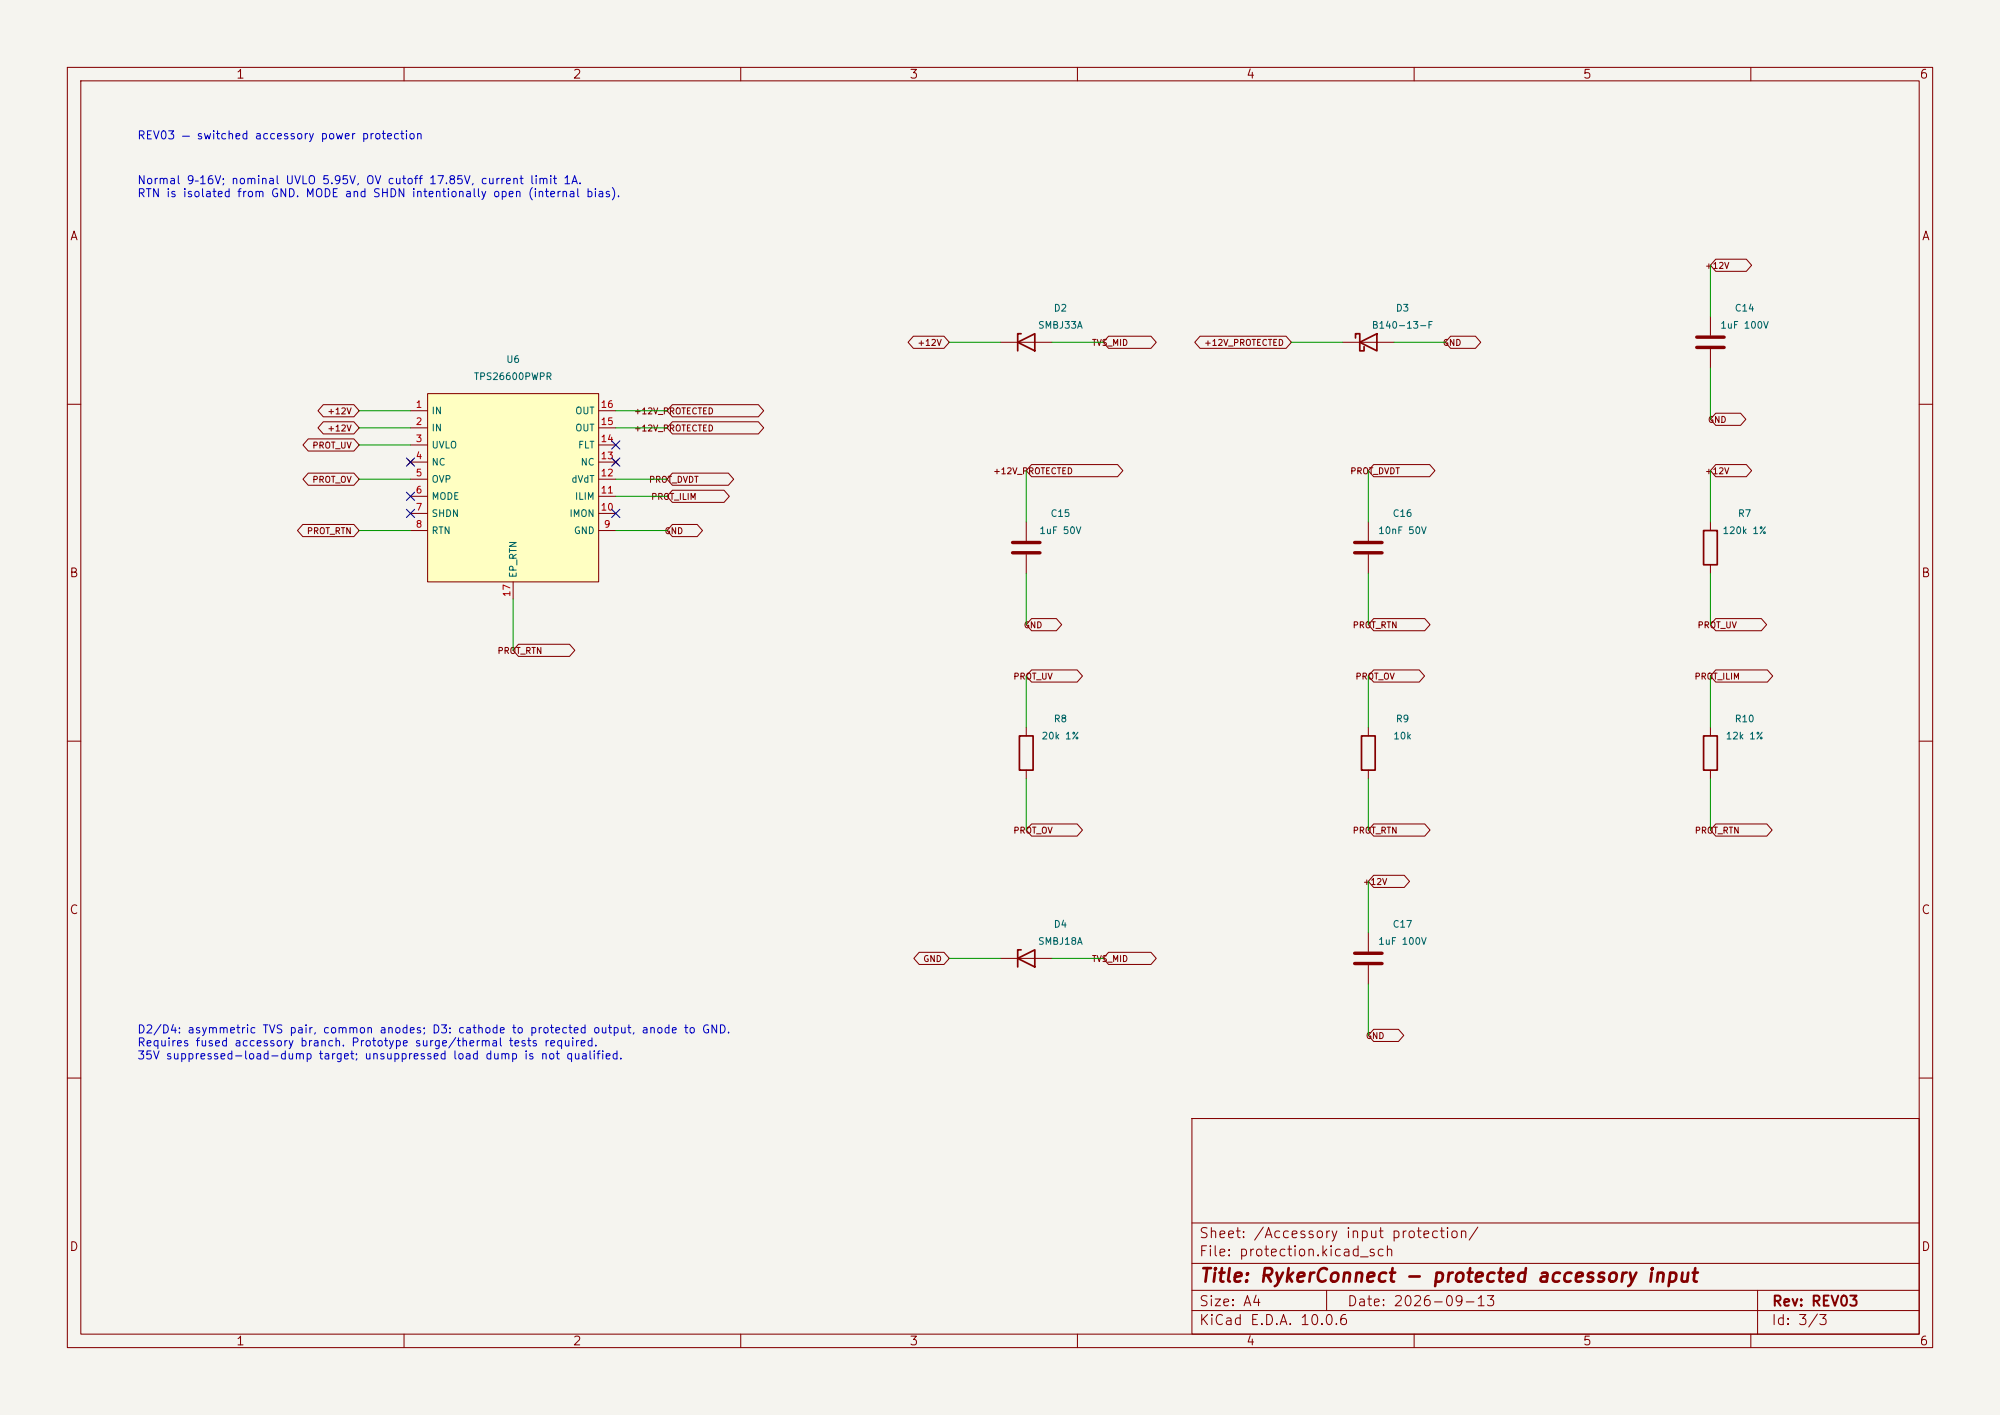
[picture p40: page 3]

Normal 9–16V; nominal UVLO 5.95V, OV cutoff 17.85V, current limit 1A. RTN is isolated from GND. MODE and SHDN intentionally open (internal bias). REV03 — switched accessory power protection

PROT_OV D2/D4: asymmetric TVS pair, common anodes; D3: cathode to protected output, anode to GND. Requires fused accessory branch. Prototype surge/thermal tests required. 35V suppressed-load-dump target; unsuppressed load dump is not qualified.

Sheet: /Accessory input protection/
File: protection.kicad_sch
Title: RykerConnect - protected accessory input
