neo12242/RykerConnect/Hardware/REV04-Carrier/validation/schematics.pdf

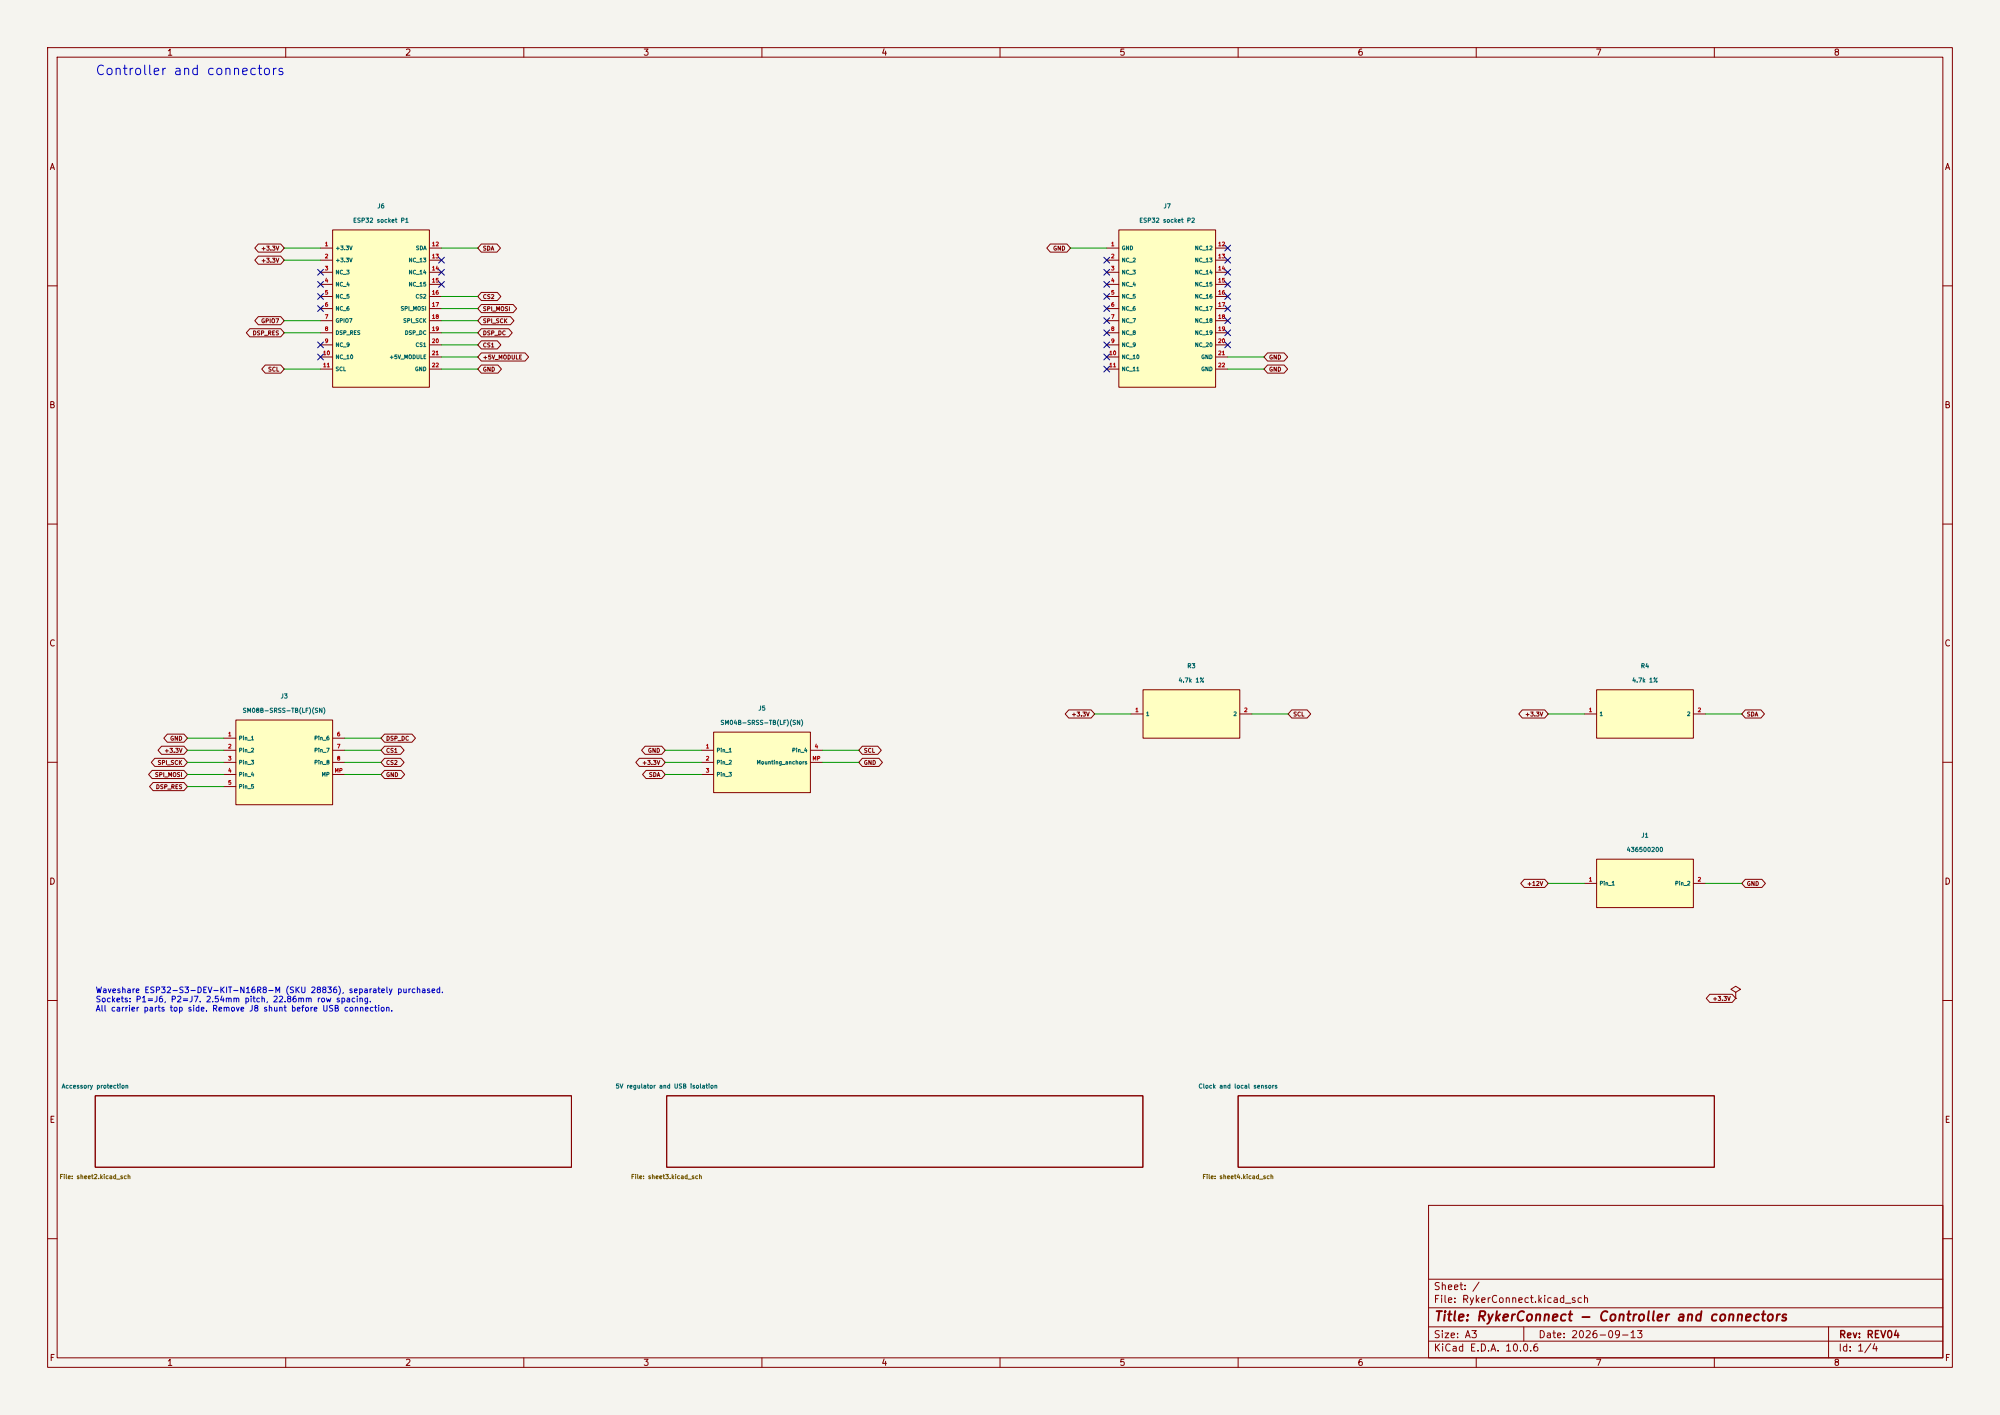
[picture p41: page 1]

SM04B-SRSS-TB(LF)(SN)

Waveshare ESP32-S3-DEV-KIT-N16R8-M (SKU 28836), separately purchased. Sockets: P1=J6, P2=J7. 2.54mm pitch, 22.86mm row spacing. All carrier parts top side. Remove J8 shunt before USB connection.

Clock and local sensors File: sheet4.kicad_sch 5V regulator and USB isolation

Sheet: /
File: RykerConnect.kicad_sch
Title: RykerConnect - Controller and connectors

Size: A3 | Rev: REV04 | F Date: 2026-09-13
KiCad E.D.A. 10.0.6 | Id: 1/4

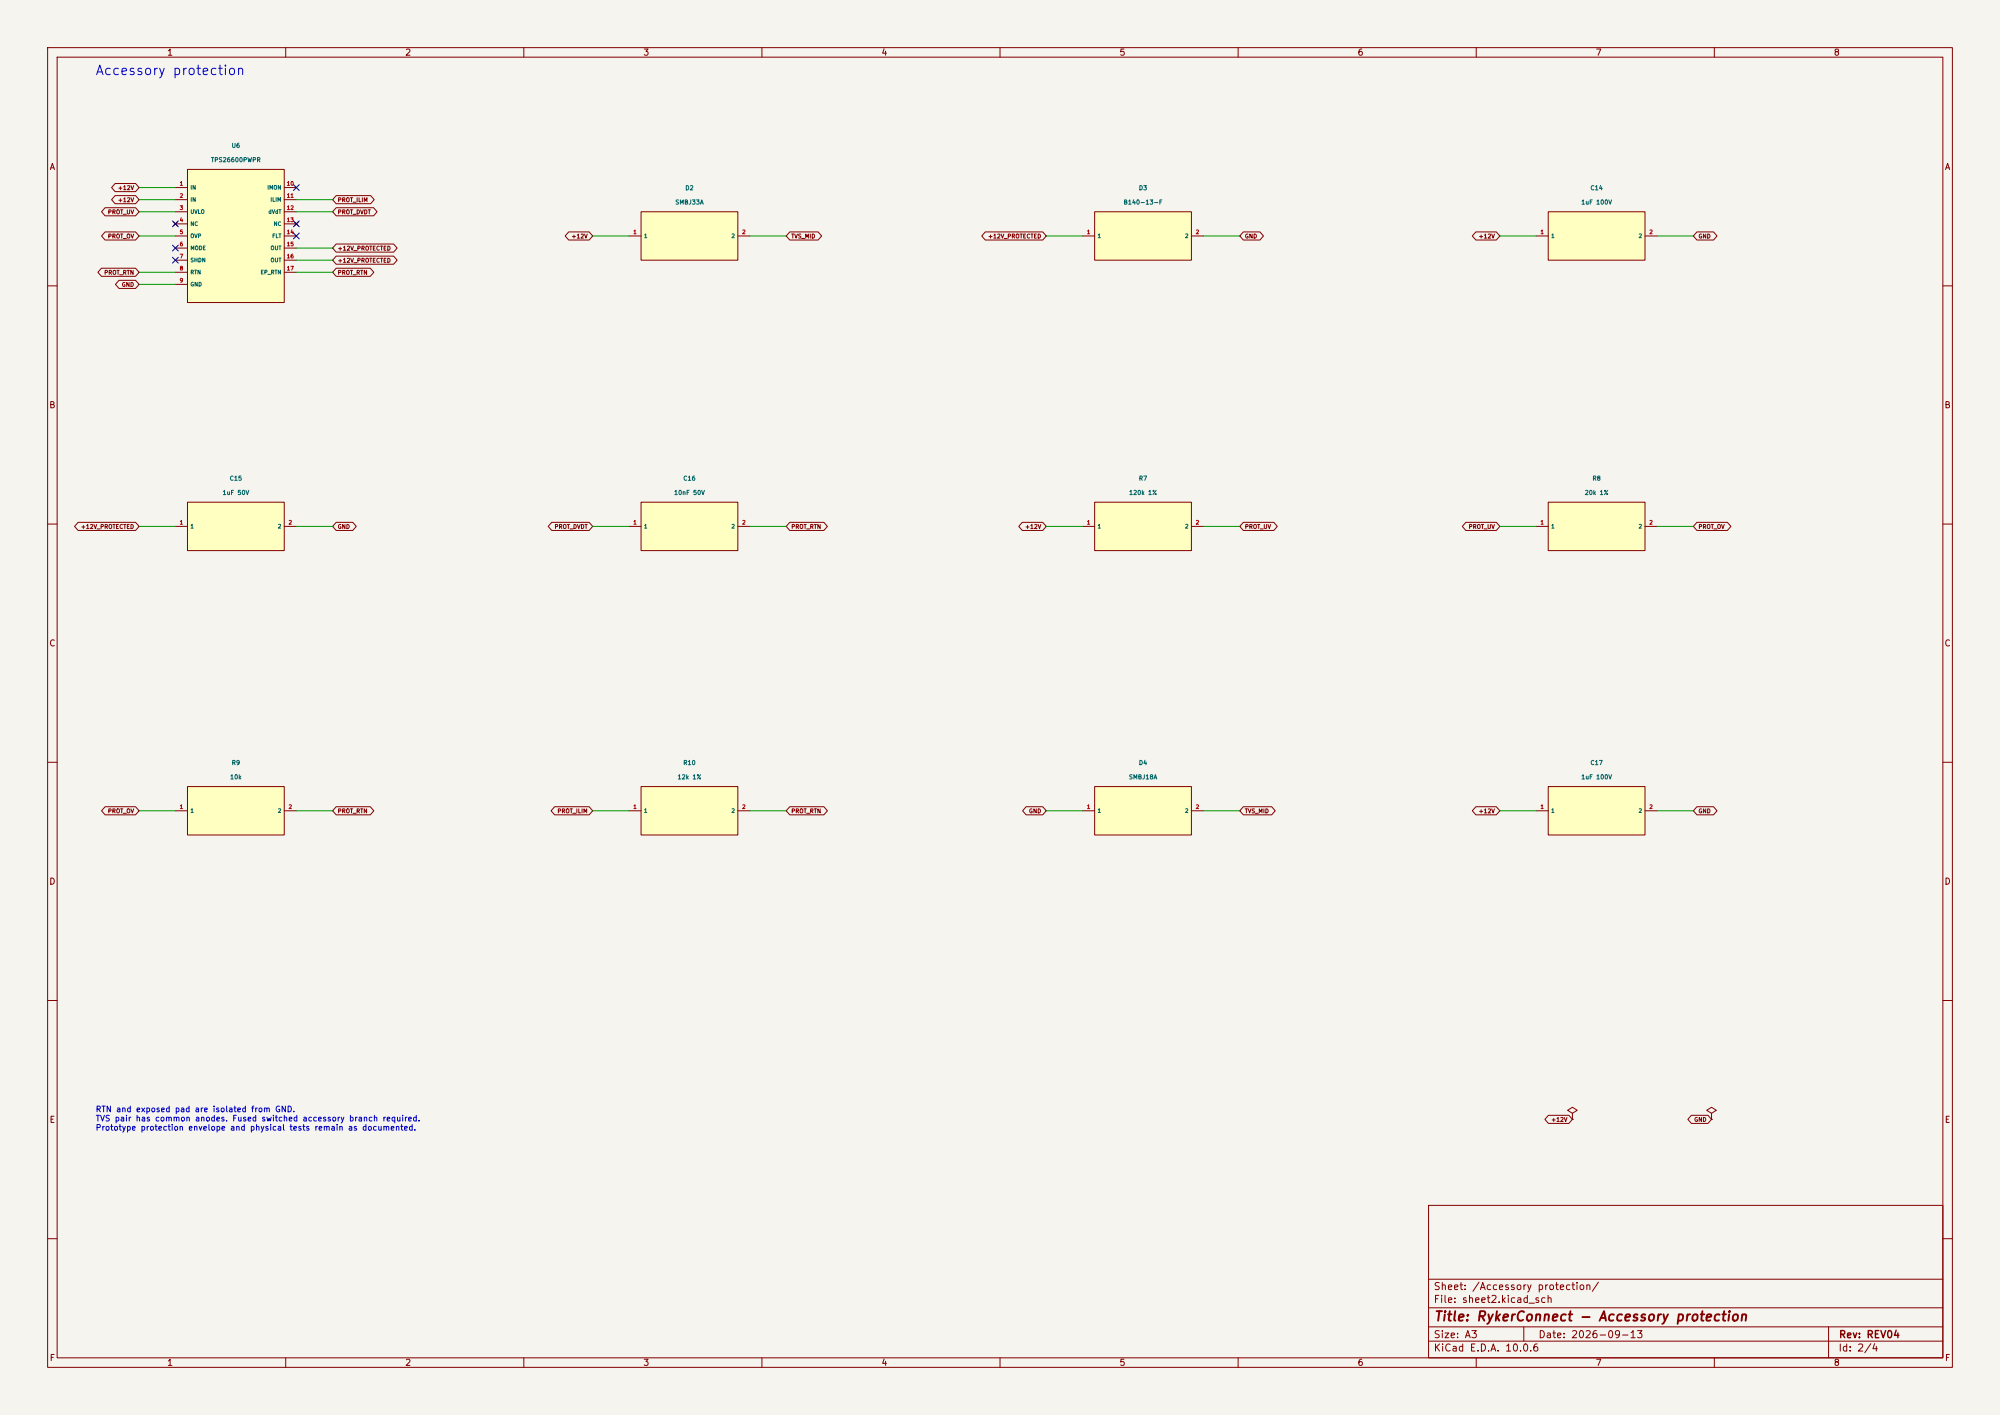
[picture p42: page 2]

RTN and exposed pad are isolated from GND. TVS pair has common anodes. Fused switched accessory branch required.

Prototype protection envelope and physical tests remain as documented.

Sheet: /Accessory protection/
File: sheet2.kicad_sch
Title: RykerConnect - Accessory protection

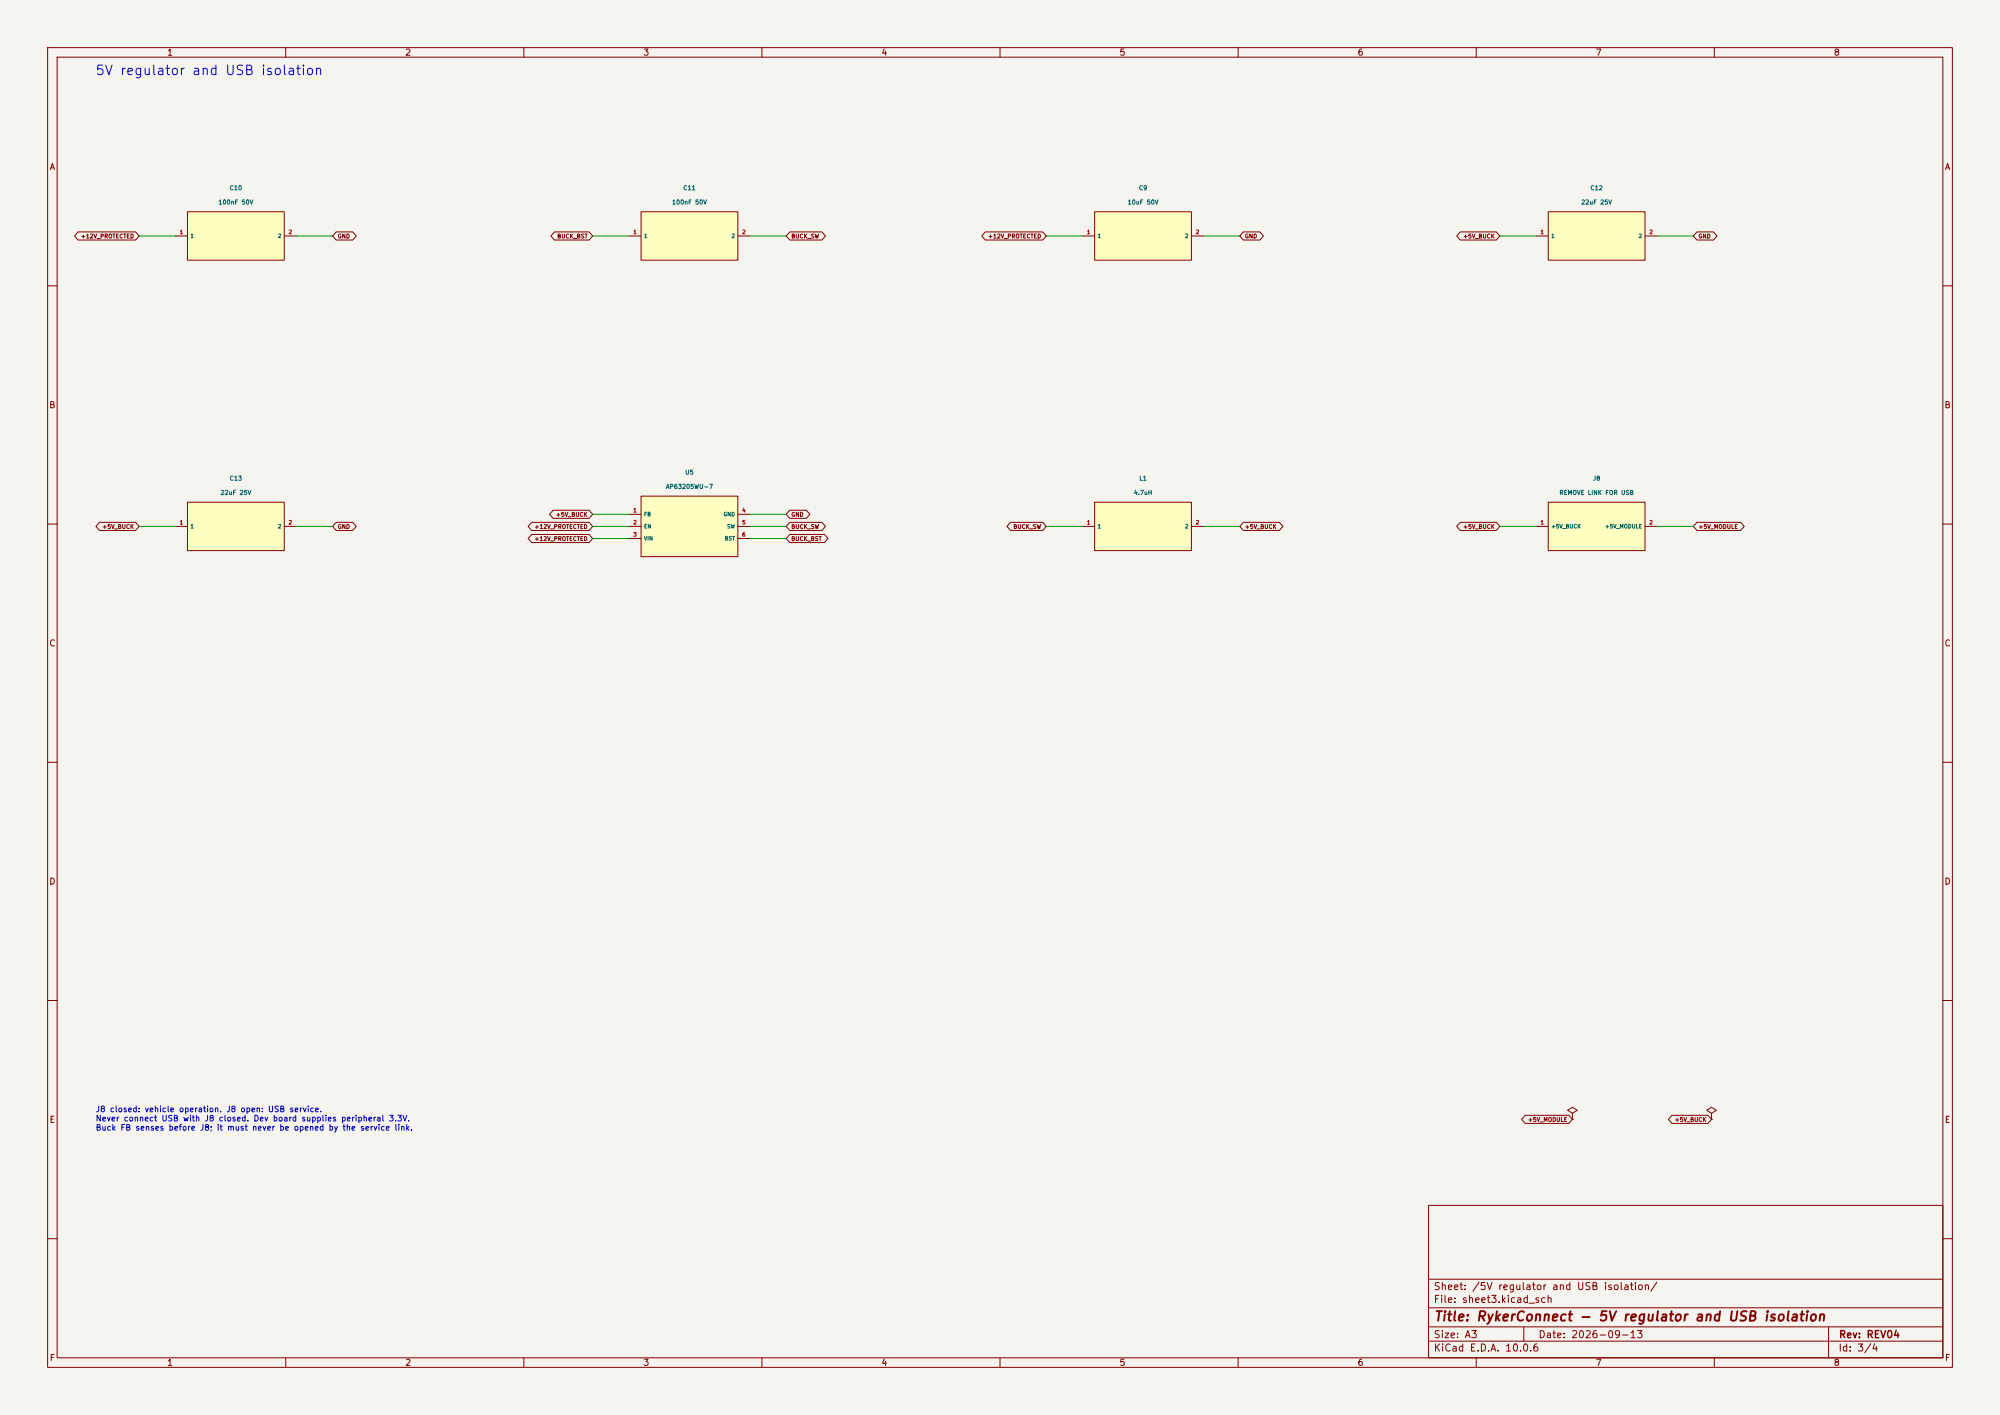
[picture p43: page 3]

J8 REMOVE LINK FOR USB

J8 closed: vehicle operation. J8 open: USB service. Never connect USB with J8 closed. Dev board supplies peripheral 3.3V. Buck FB senses before J8; it must never be opened by the service link.

Sheet: /5V regulator and USB isolation/
File: sheet3.kicad_sch
Title: RykerConnect - 5V regulator and USB isolation

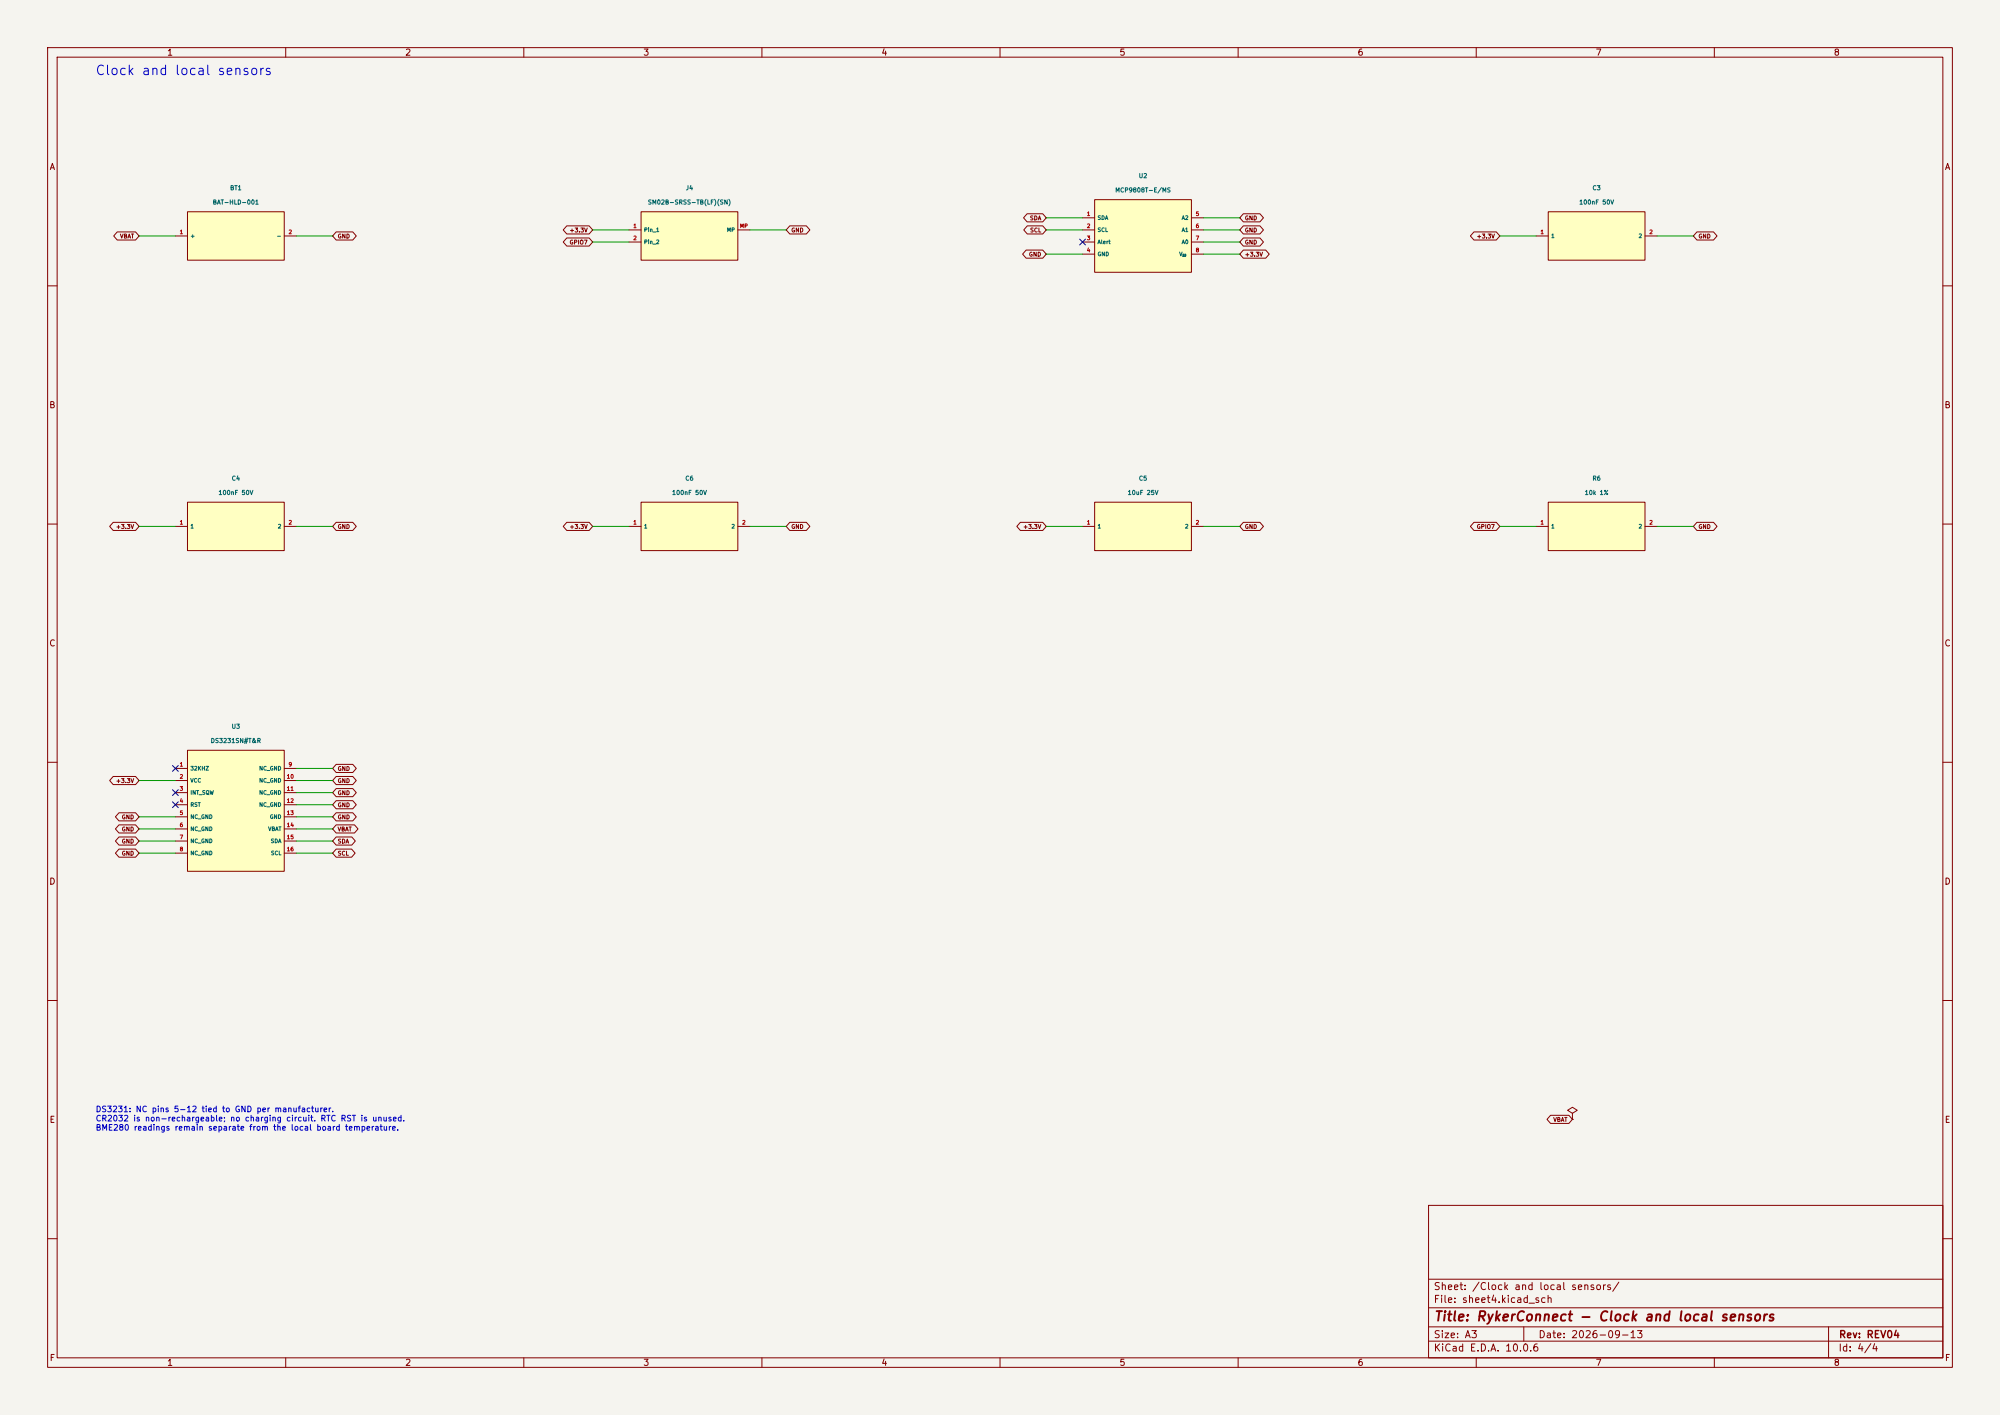
[picture p44: page 4]

Clock and local sensors

DS3231: NC pins 5-12 tied to GND per manufacturer. CR2032 is non-rechargeable; no charging circuit. RTC RST is unused. BME280 readings remain separate from the local board temperature.

Sheet: /Clock and local sensors/
File: sheet4.kicad_sch
Title: RykerConnect - Clock and local sensors
