neo12242/RykerConnect/Hardware/REV05-12V/validation/schematics.pdf

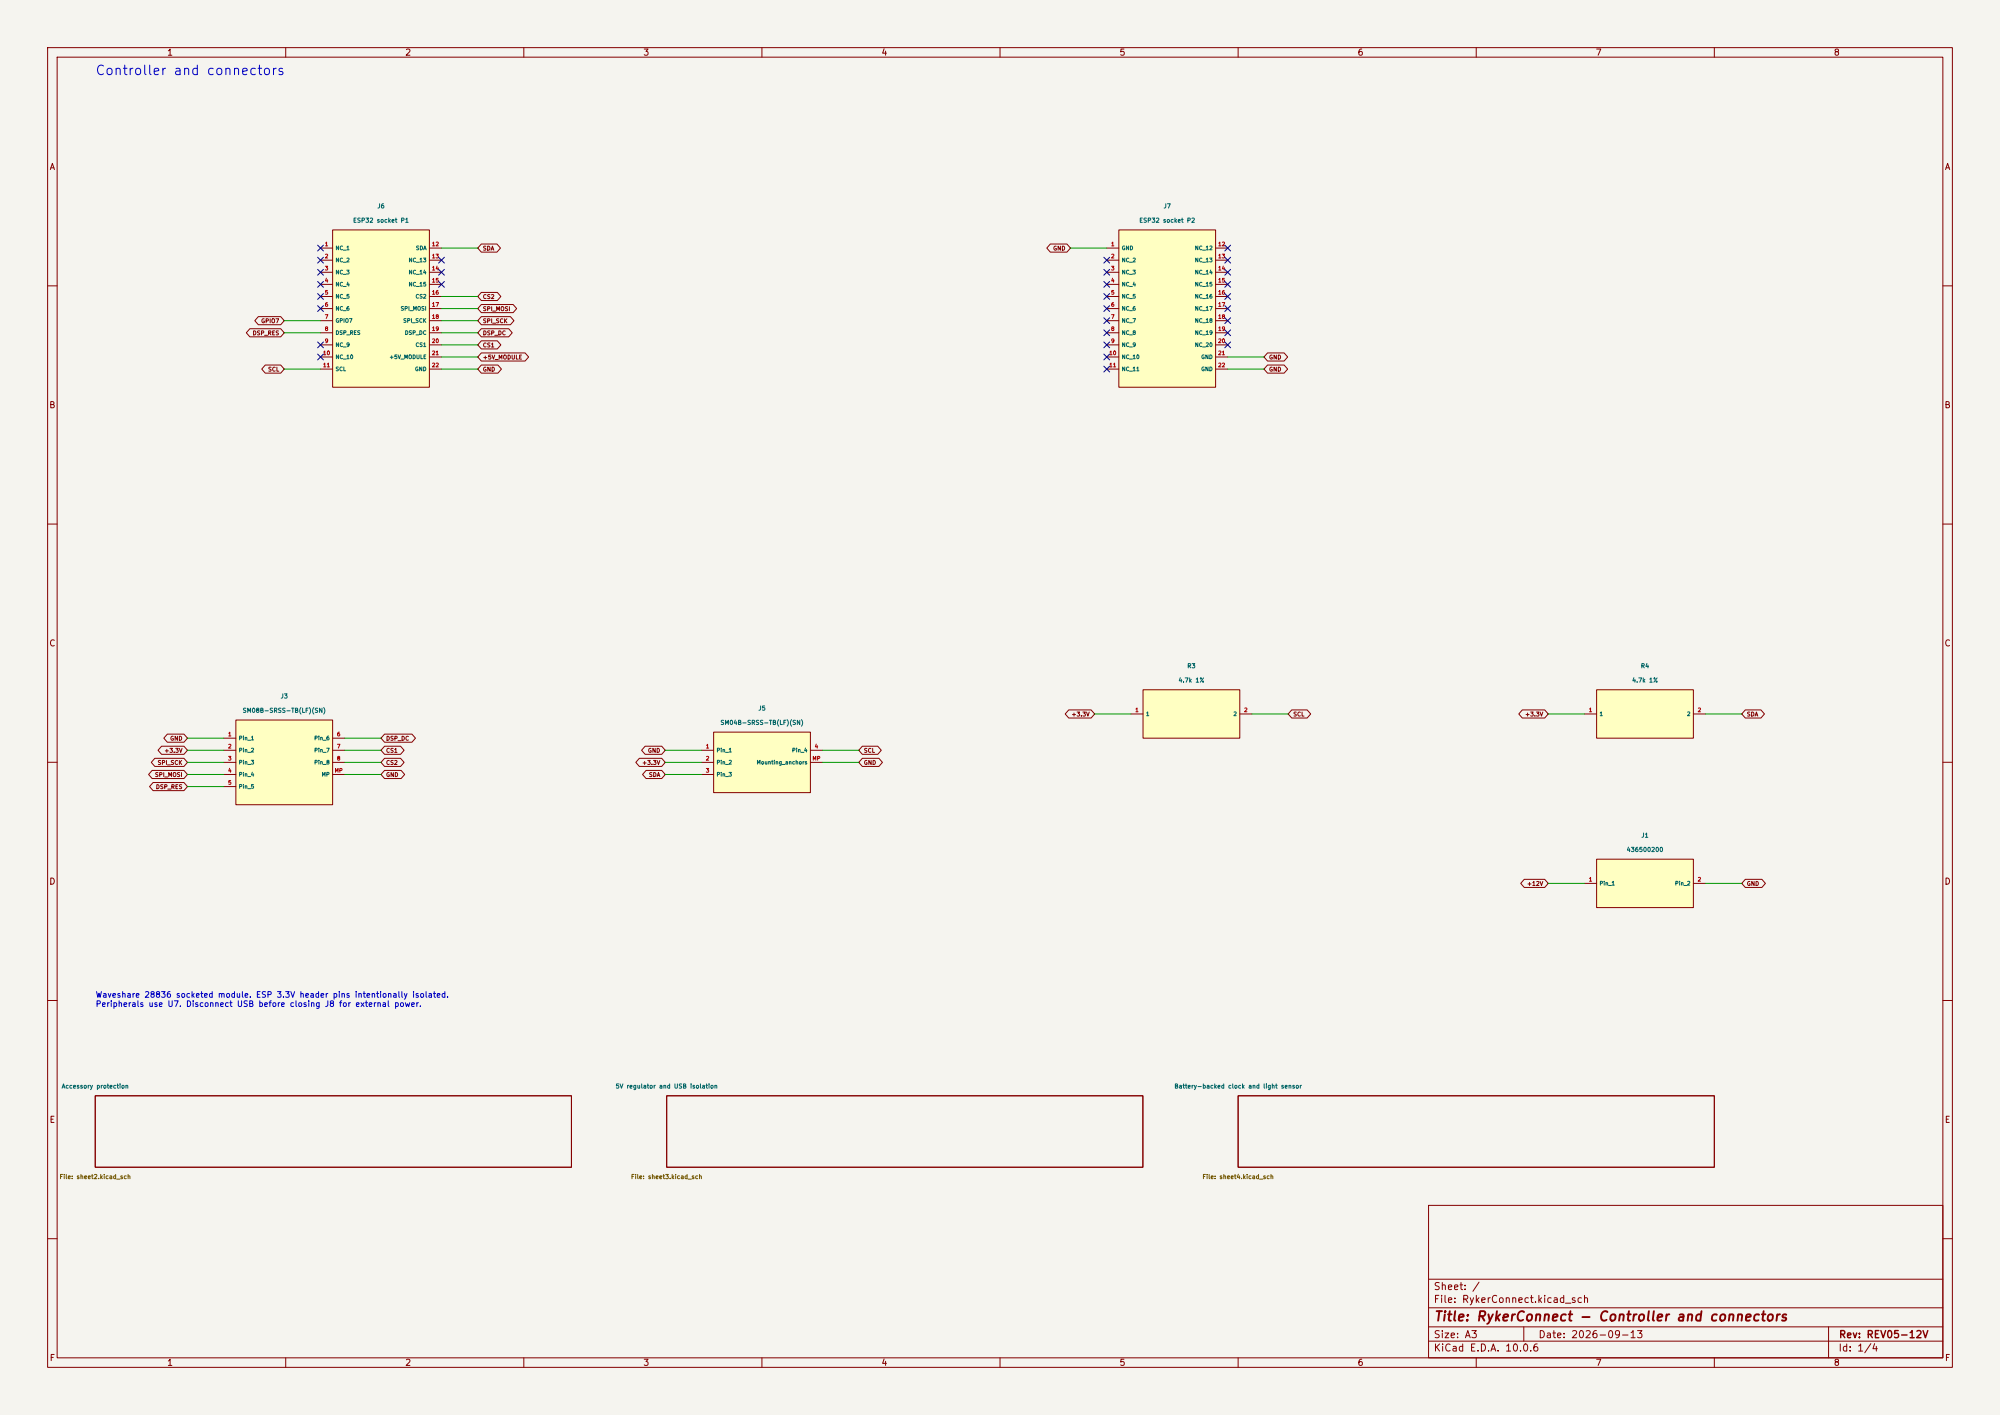
[picture p45: page 1]

+5V_MODULE GND Controller and connectors

SM04B-SRSS-TB(LF)(SN)

Waveshare 28836 socketed module. ESP 3.3V header pins intentionally isolated. Peripherals use U7. Disconnect USB before closing J8 for external power.

Battery-backed clock and light sensor File: sheet4.kicad_sch 5V regulator and USB isolation

Sheet: /
File: RykerConnect.kicad_sch
Title: RykerConnect - Controller and connectors

Size: A3 | Rev: REV05-12V | F Date: 2026-09-13
KiCad E.D.A. 10.0.6 | Id: 1/4

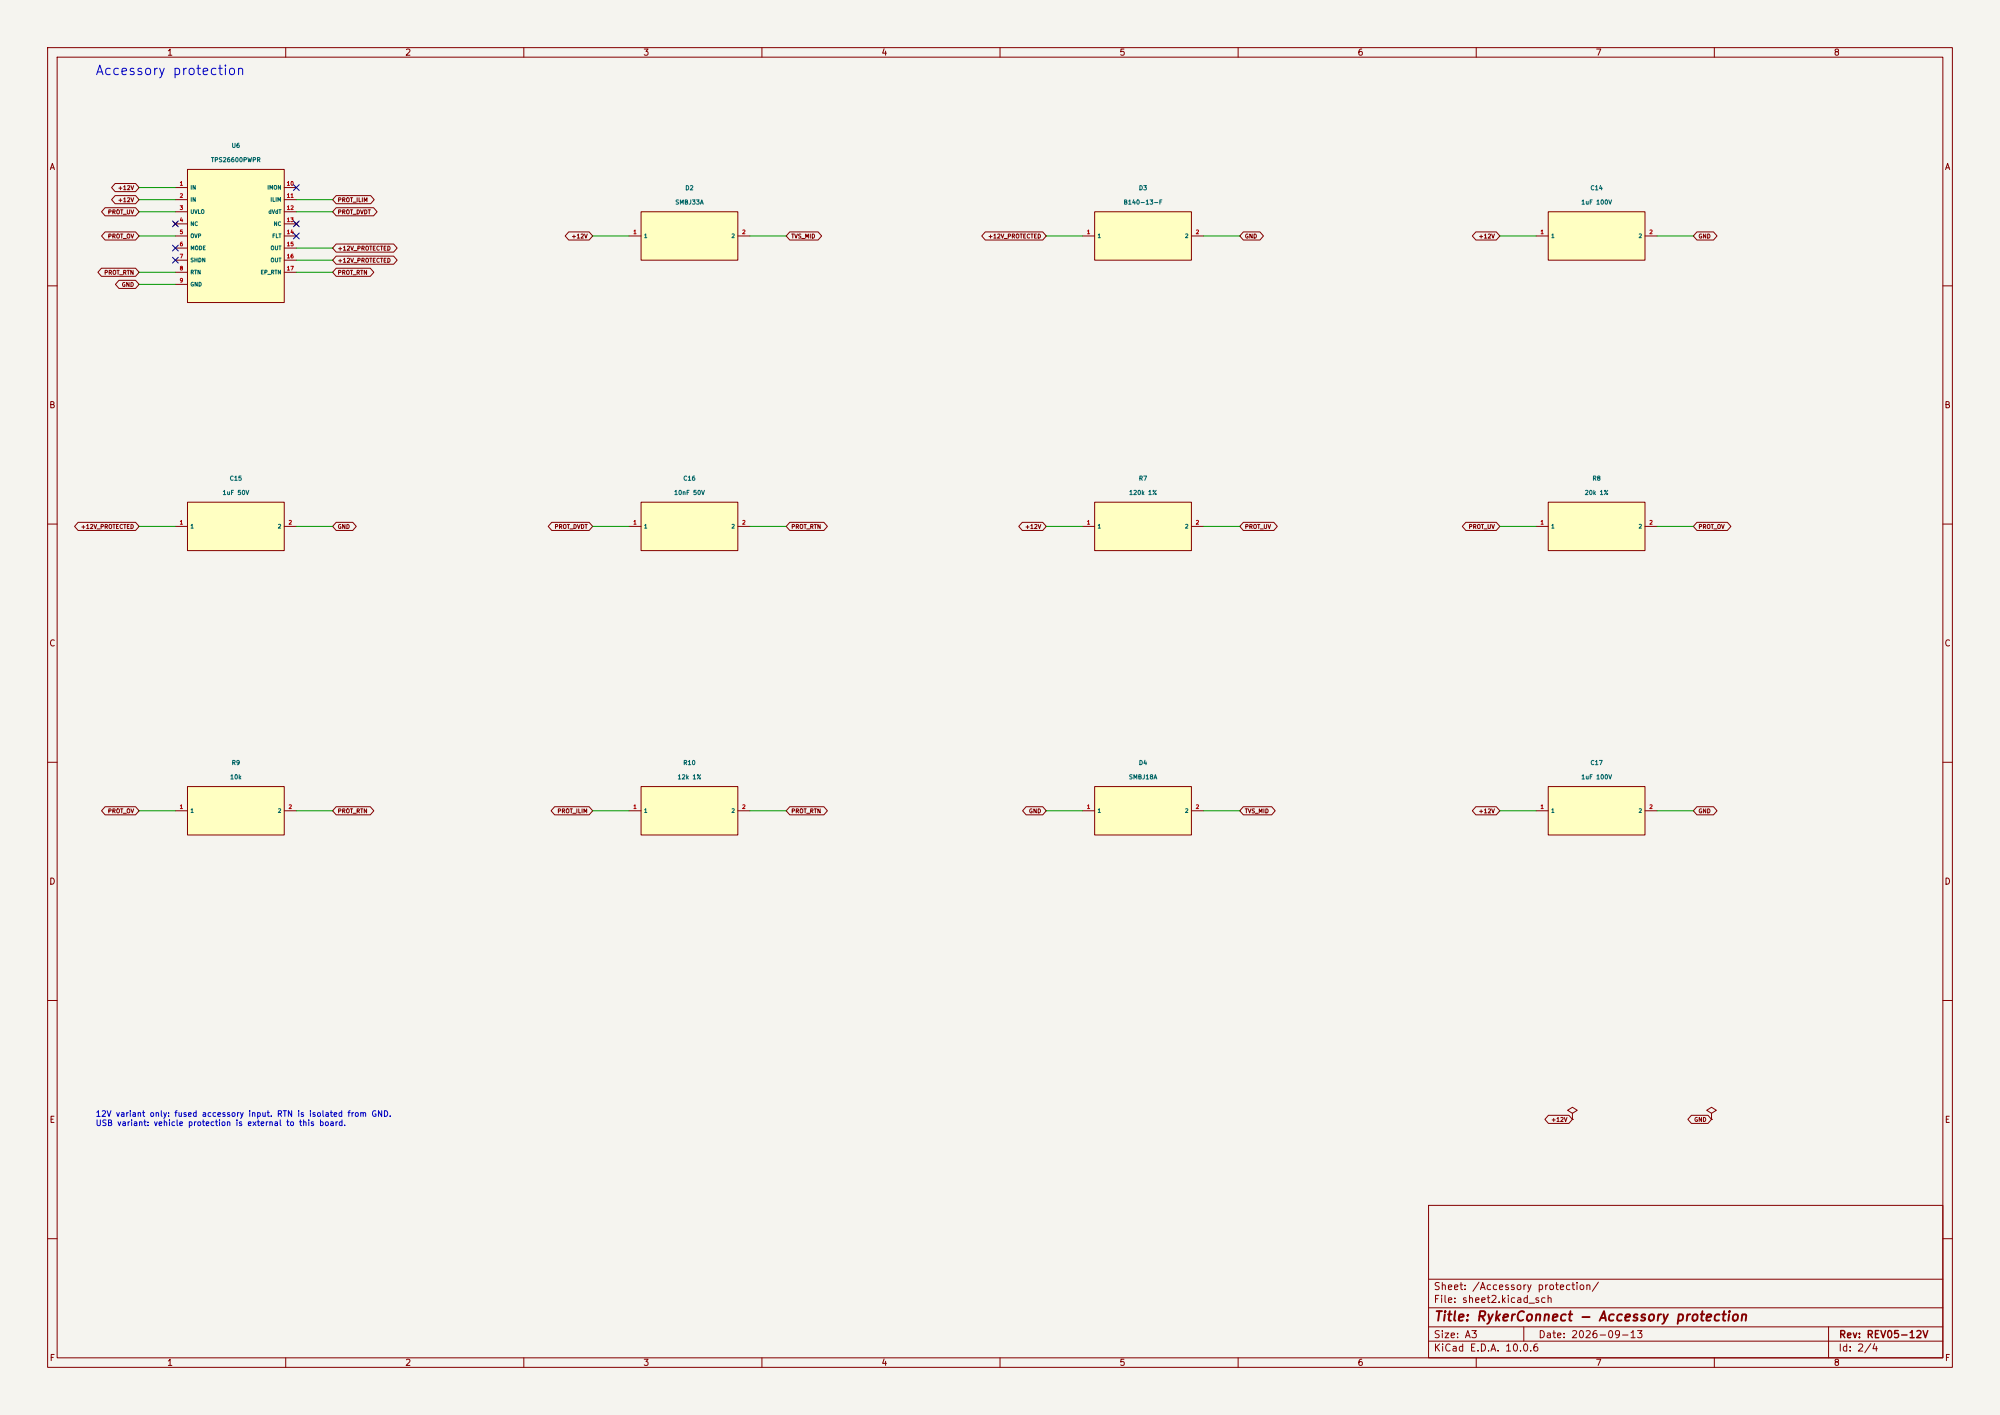
[picture p46: page 2]

12V variant only: fused accessory input. RTN is isolated from GND. USB variant: vehicle protection is external to this board.

Sheet: /Accessory protection/
File: sheet2.kicad_sch
Title: RykerConnect - Accessory protection

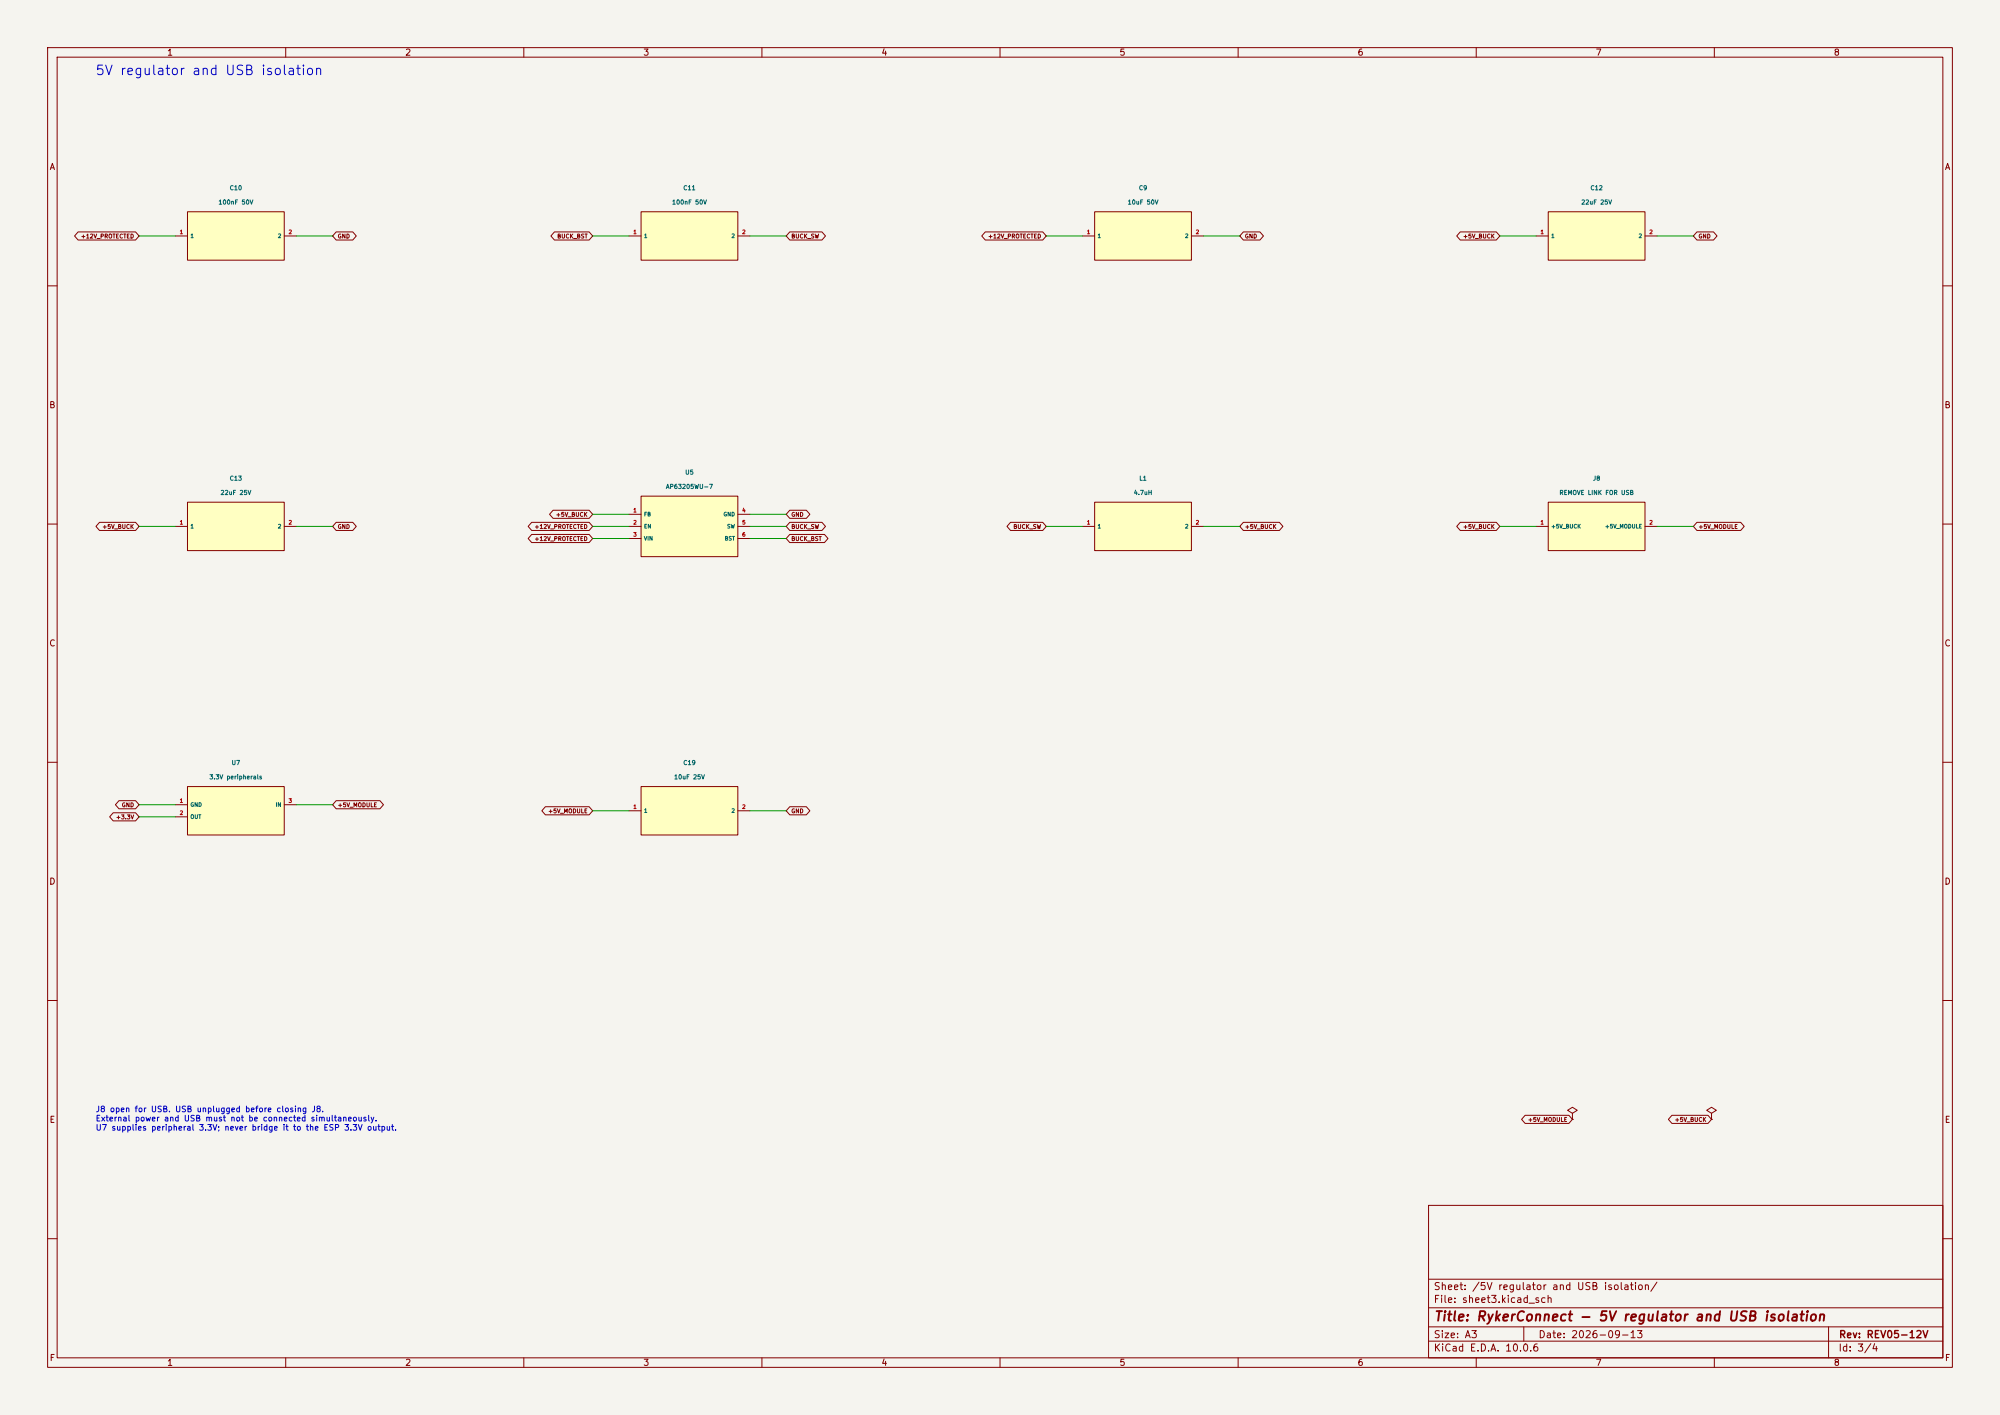
[picture p47: page 3]

5V regulator and USB isolation

J8 REMOVE LINK FOR USB

Sheet: /5V regulator and USB isolation/
File: sheet3.kicad_sch
Title: RykerConnect - 5V regulator and USB isolation

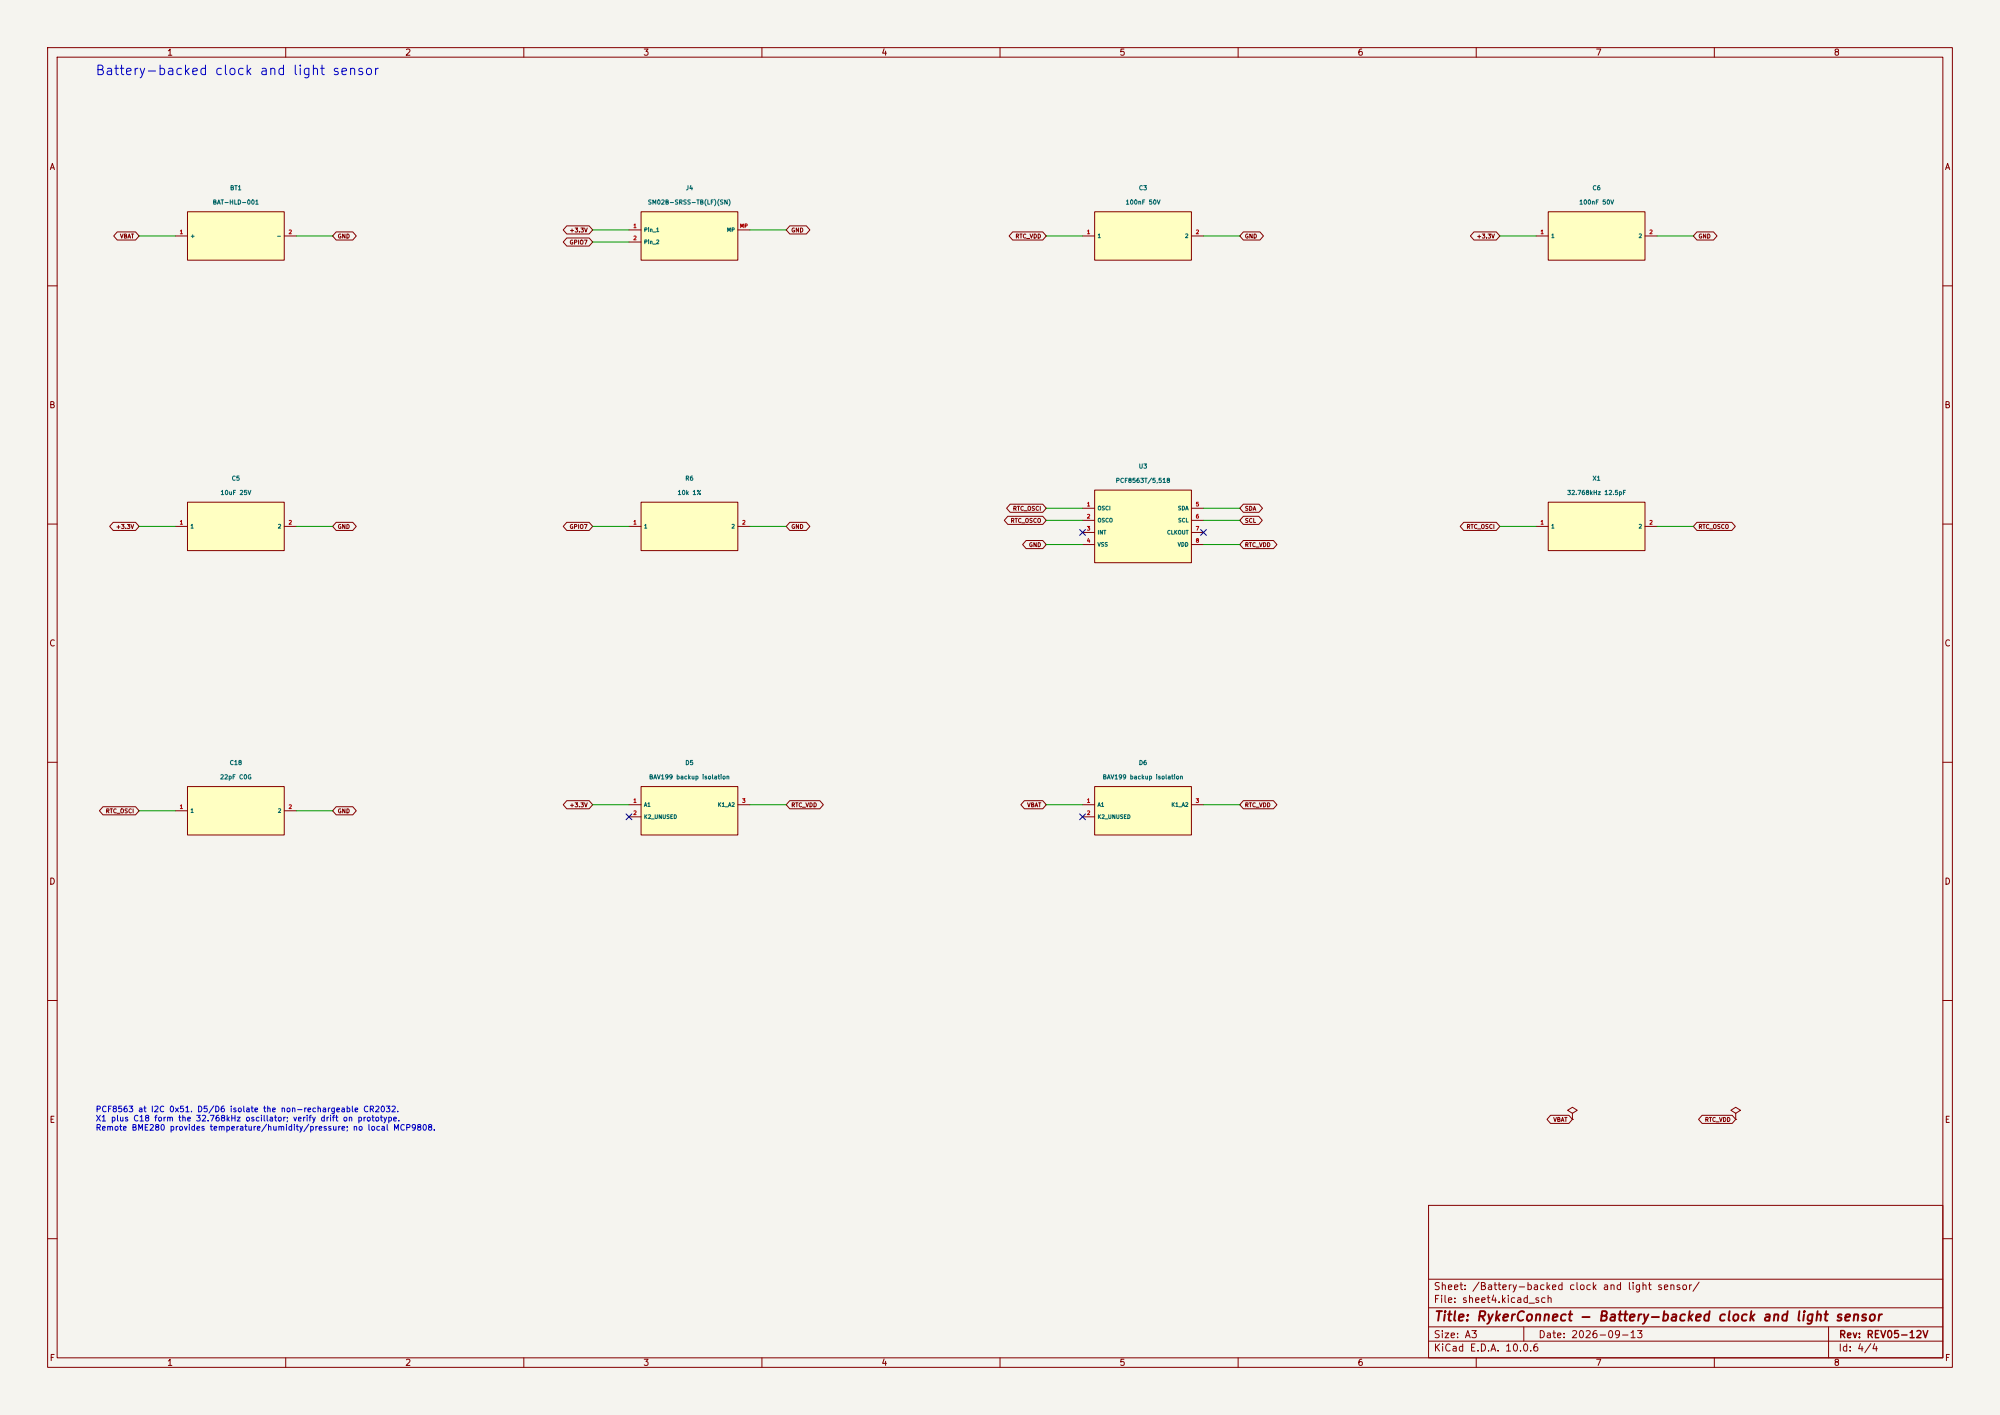
[picture p48: page 4]

PCF8563 at I2C 0x51. D5/D6 isolate the non-rechargeable CR2032. X1 plus C18 form the 32.768kHz oscillator; verify drift on prototype. Remote BME280 provides temperature/humidity/pressure; no local MCP9808.

Sheet: /Battery-backed clock and light sensor/
File: sheet4.kicad_sch
Title: RykerConnect - Battery-backed clock and light sensor
