neo12242/RykerConnect/Hardware/REV02-Corrected/validation/before.pdf

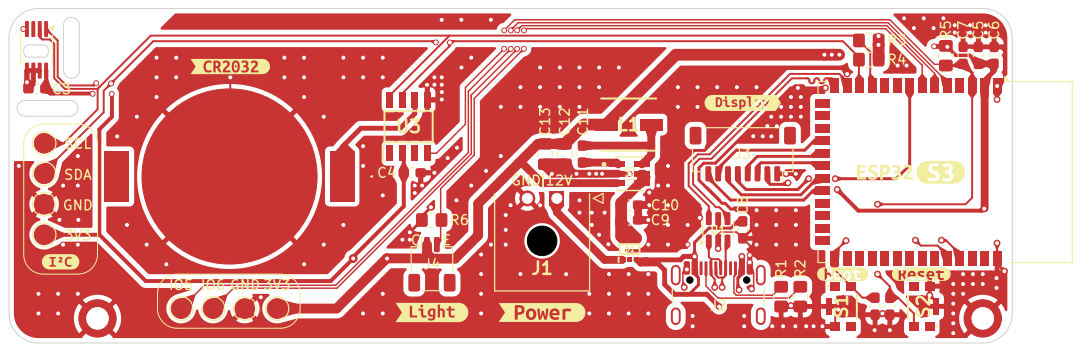
[picture p57: page 1]
