neo12242/RykerConnect/Hardware/REV02-Corrected/validation/board-bottom.pdf

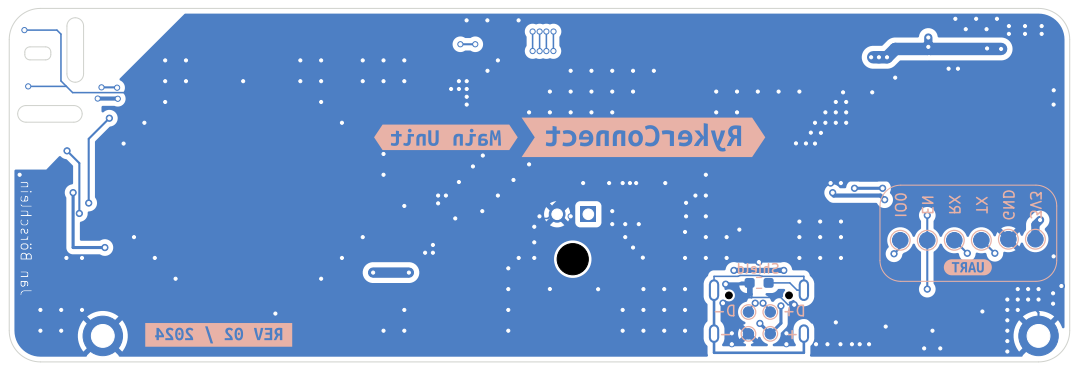
[picture p58: page 1]
