neo12242/RykerConnect/Hardware/REV02-Corrected/validation/board-top.pdf

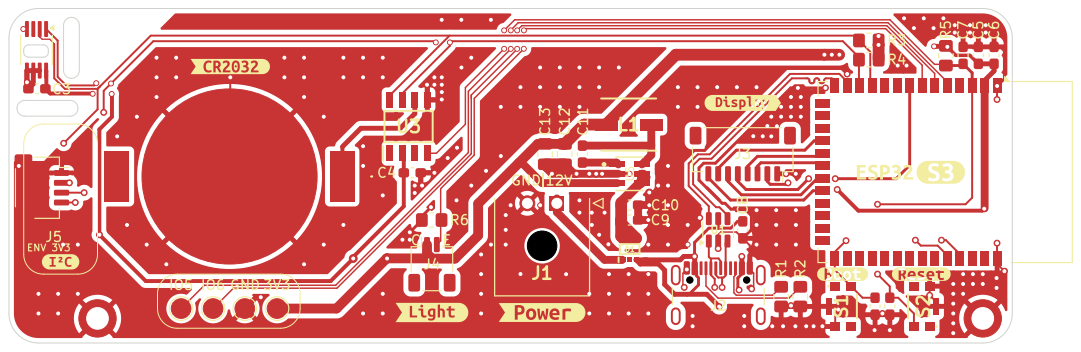
[picture p59: page 1]
