neo12242/RykerConnect/Hardware/REV03-Protected/validation/assembly-B.pdf

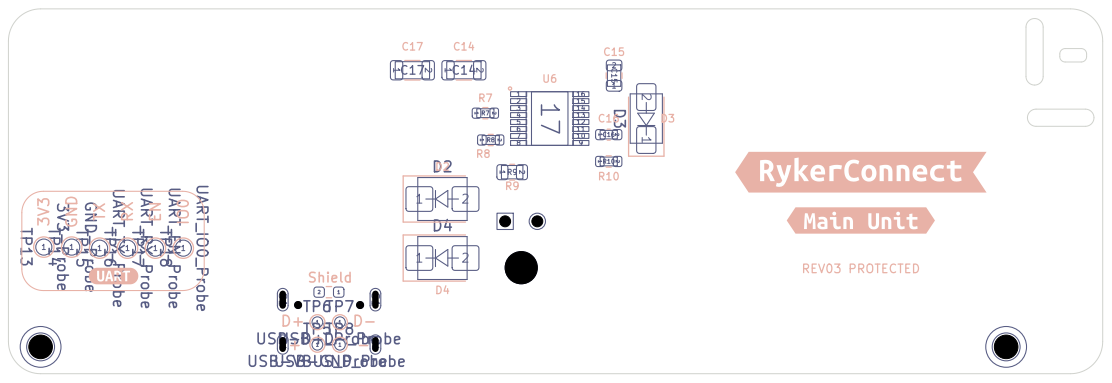
[picture p60: page 1]
