neo12242/RykerConnect/Hardware/REV03-Protected/validation/assembly-F.pdf

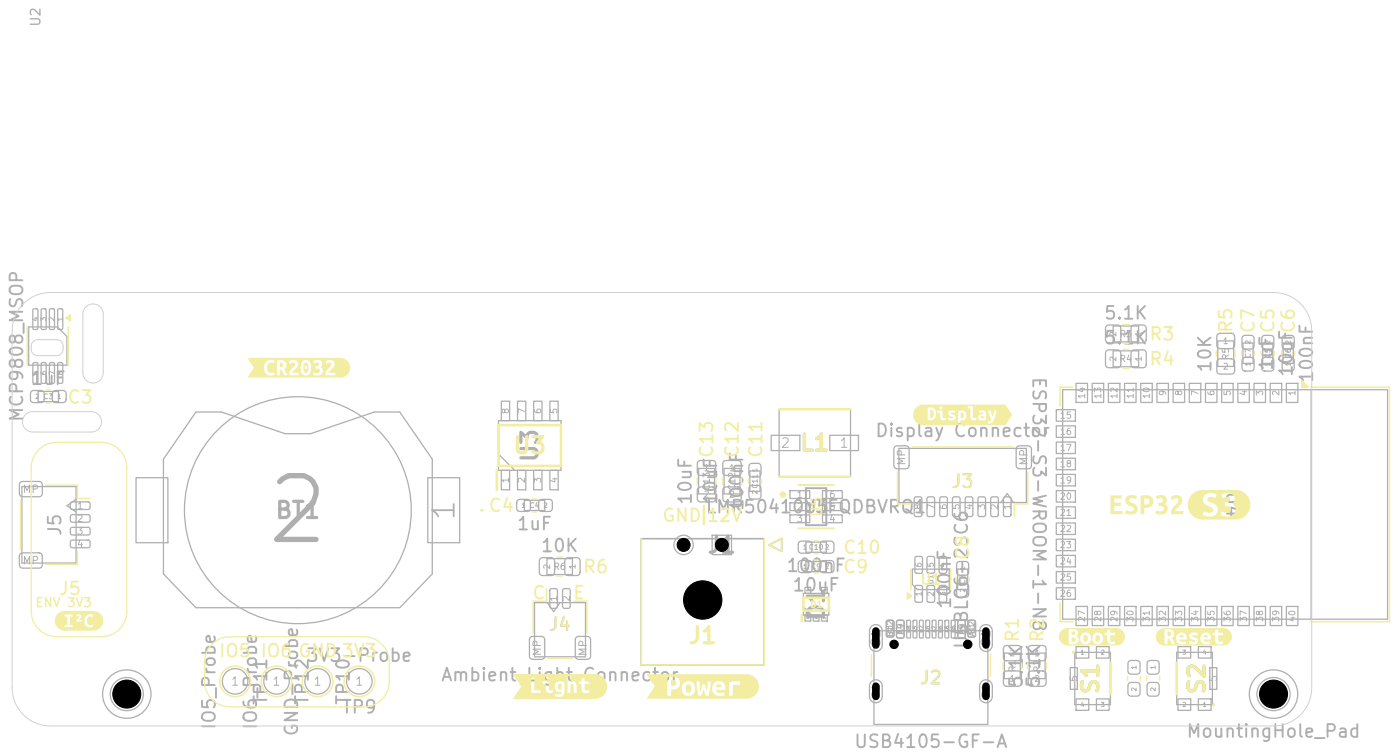
[picture p61: page 1]
