neo12242/RykerConnect/Hardware/REV03-Protected/validation/board-B.pdf

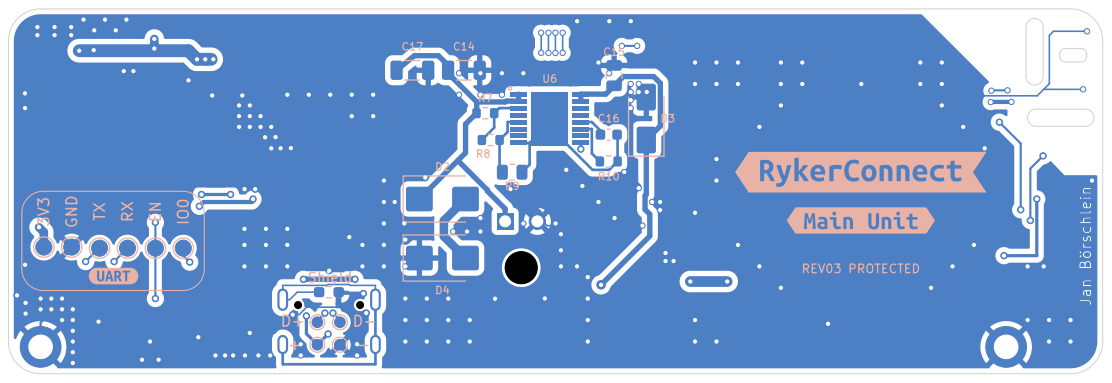
[picture p62: page 1]
