neo12242/RykerConnect/Hardware/REV03-Protected/validation/board-F.pdf

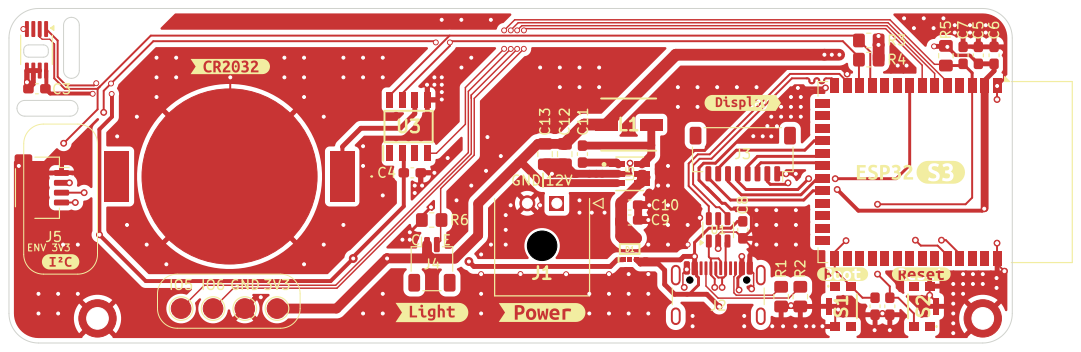
[picture p63: page 1]
