neo12242/RykerConnect/Hardware/REV04-Carrier/sources/module-mechanical.pdf

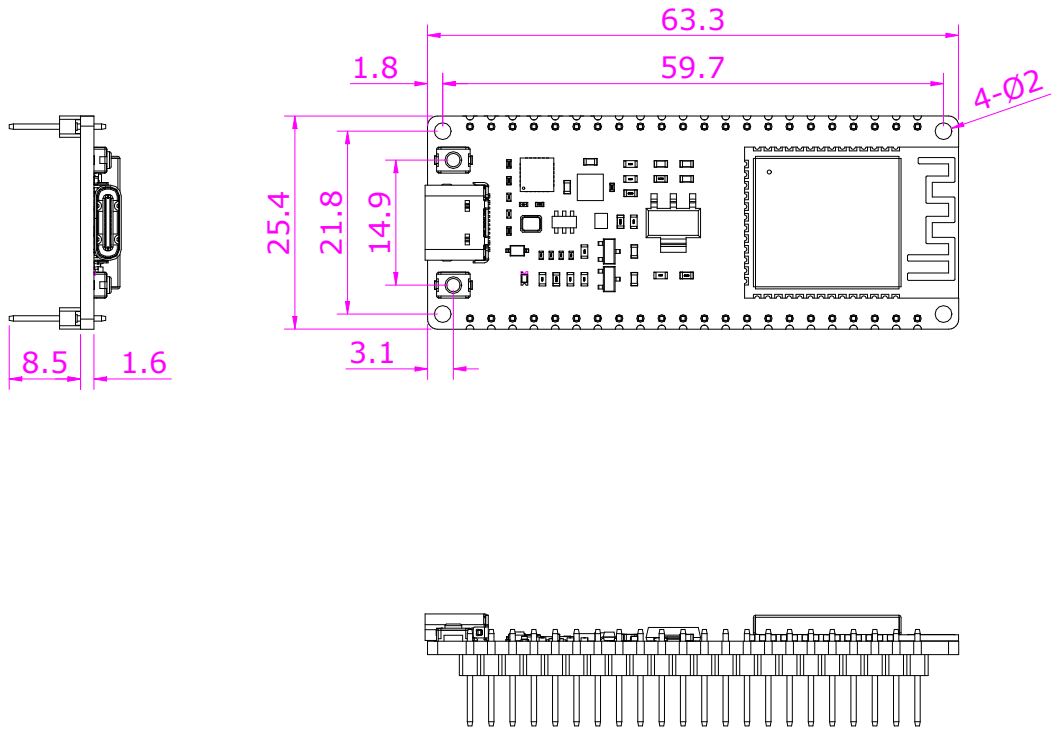
[picture p64: page 1]
