neo12242/RykerConnect/Hardware/REV04-Carrier/validation/assembly-F.pdf

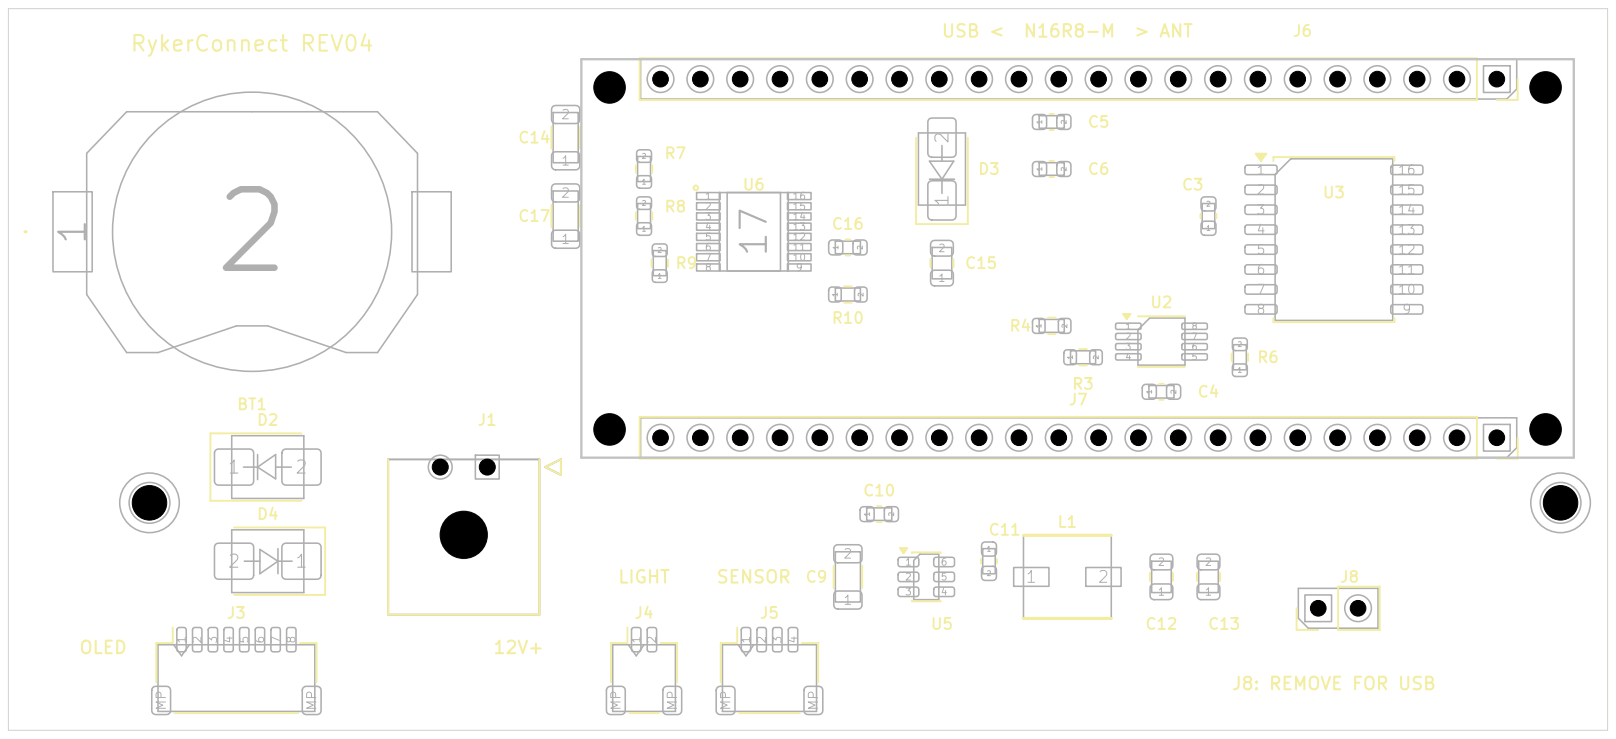
[picture p65: page 1]
