neo12242/RykerConnect/Hardware/REV04-Carrier/validation/board-B.pdf

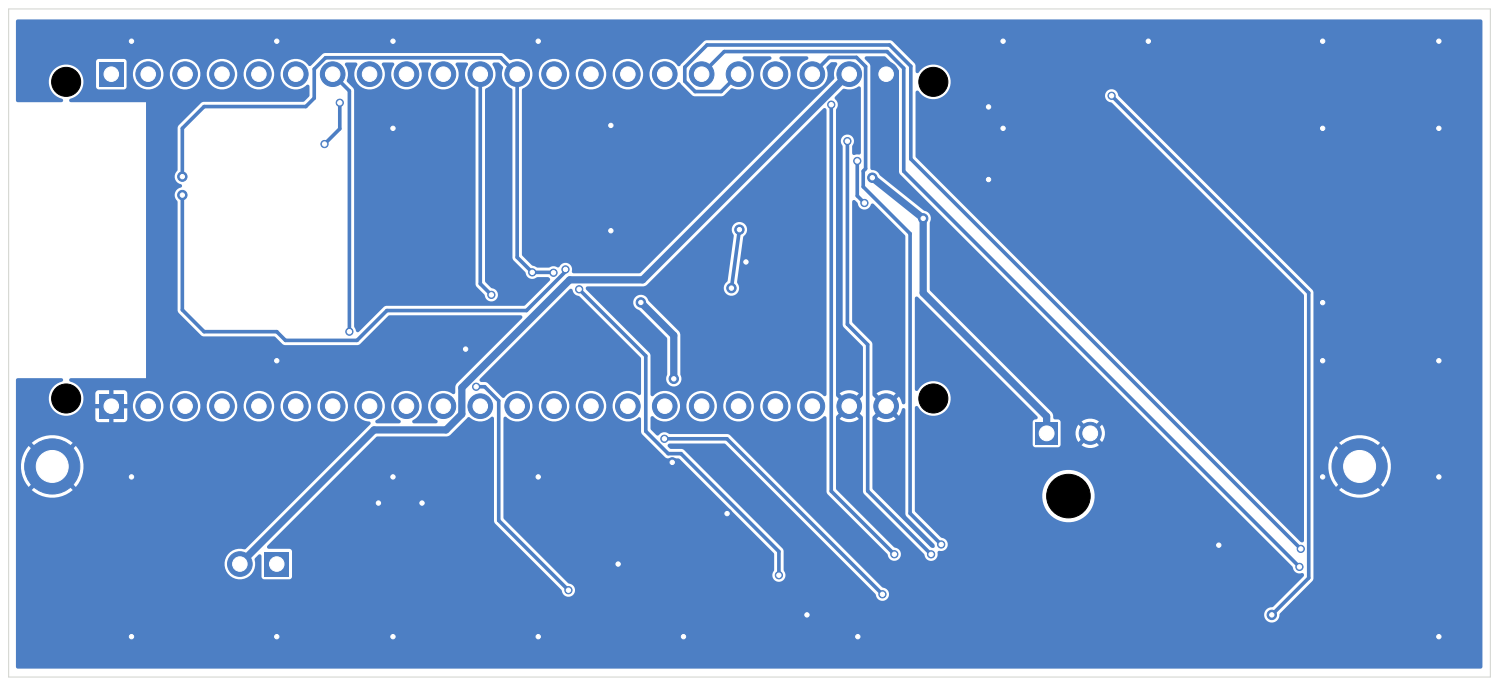
[picture p66: page 1]
