neo12242/RykerConnect/Hardware/REV04-Carrier/validation/board-F.pdf

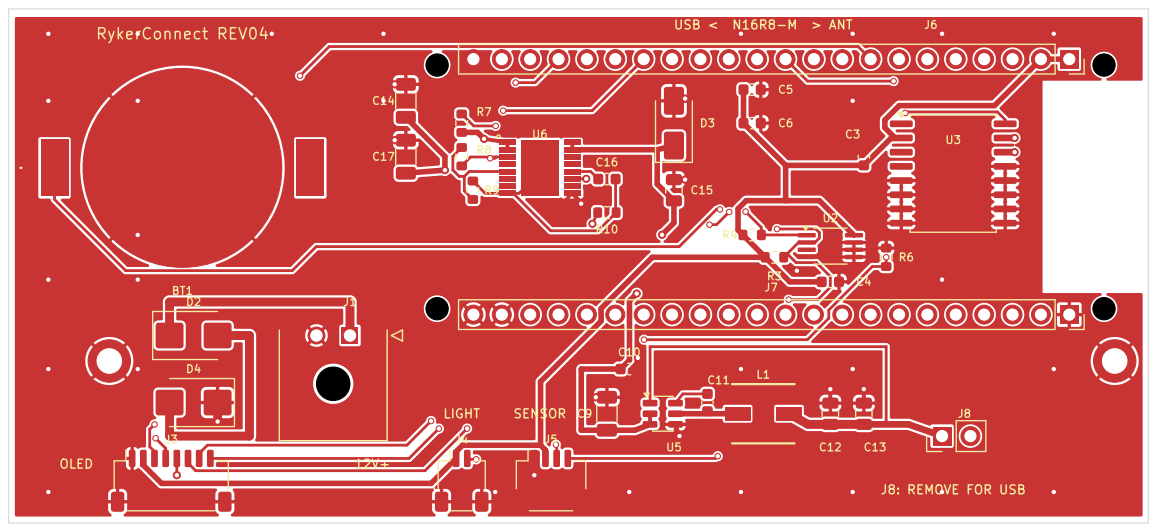
[picture p67: page 1]
