neo12242/RykerConnect/Hardware/REV05-12V/validation/assembly-F.pdf

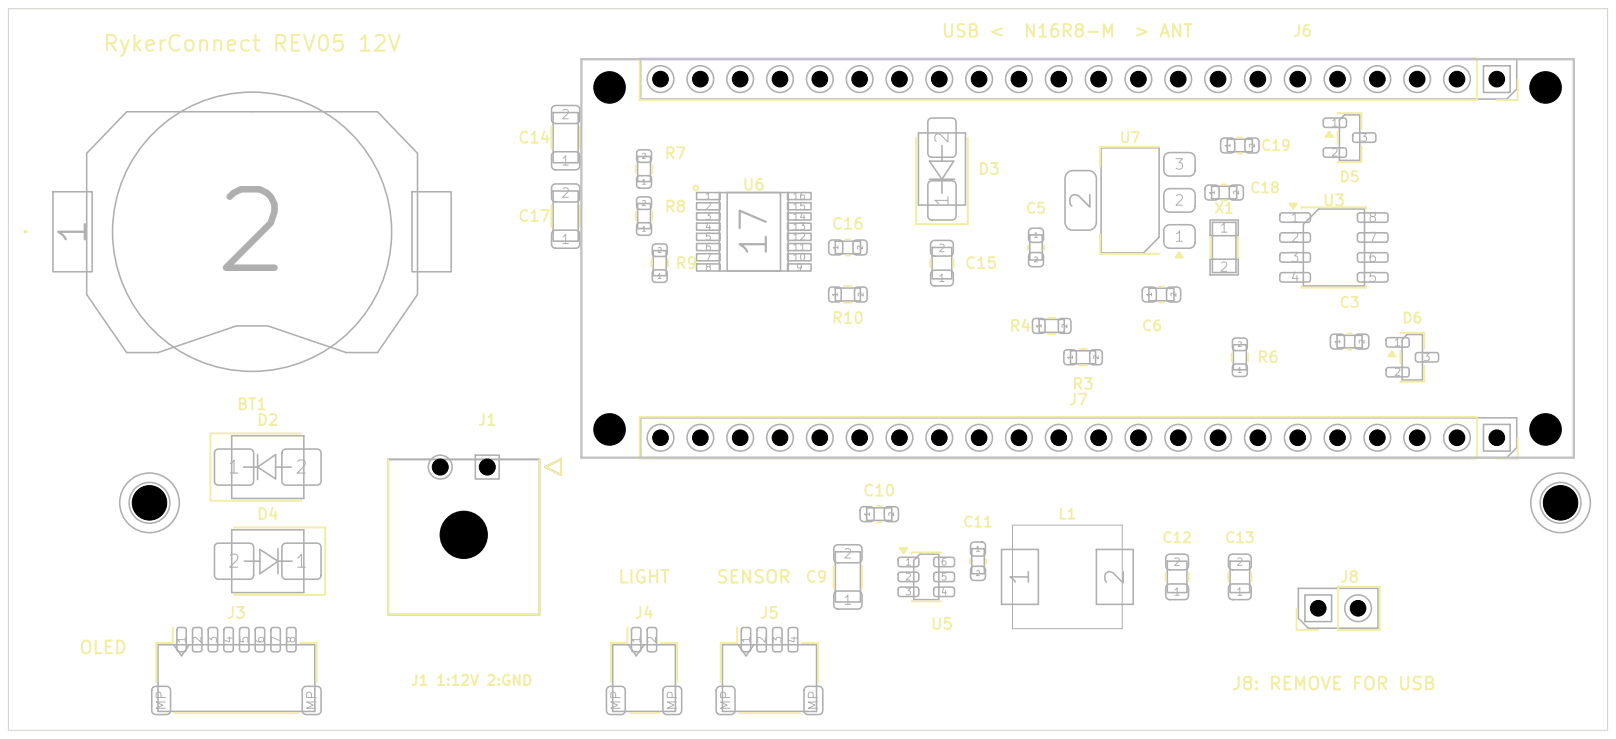
[picture p68: page 1]
