neo12242/RykerConnect/Hardware/REV05-12V/validation/board-B.pdf

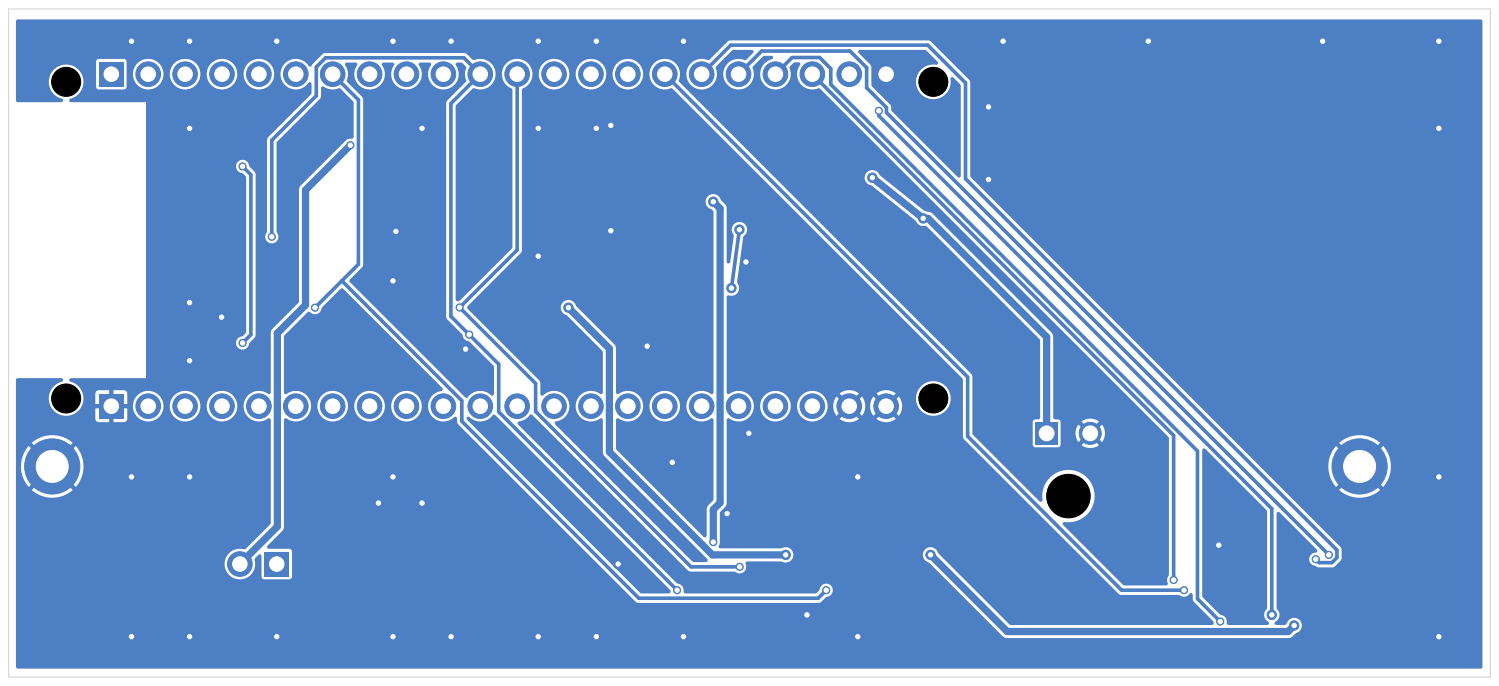
[picture p69: page 1]
