neo12242/RykerConnect/Hardware/REV05-12V/validation/board-F.pdf

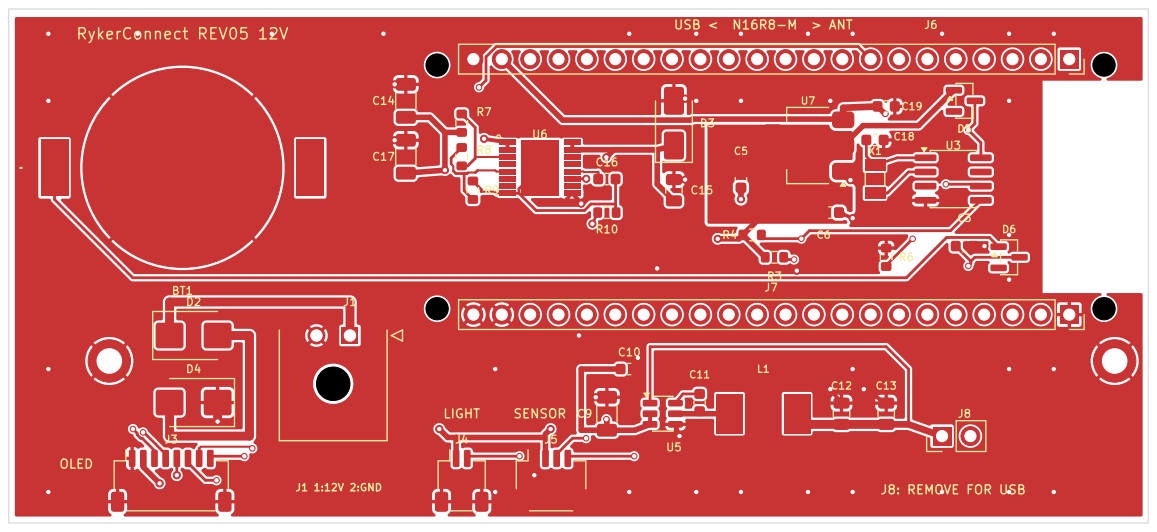
[picture p70: page 1]
