neo12242/RykerConnect/Hardware/REV05-USB/validation/assembly-F.pdf

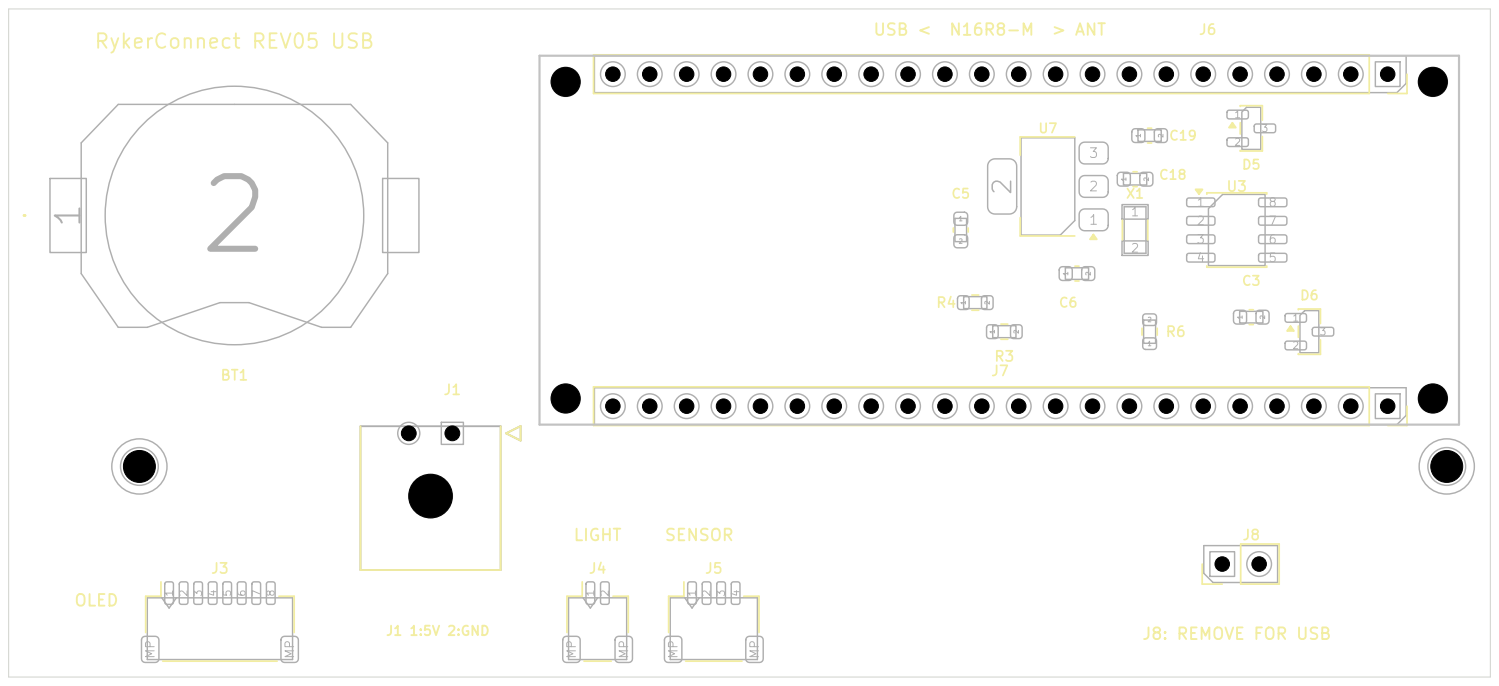
[picture p71: page 1]
