neo12242/RykerConnect/Hardware/REV05-USB/validation/board-B.pdf

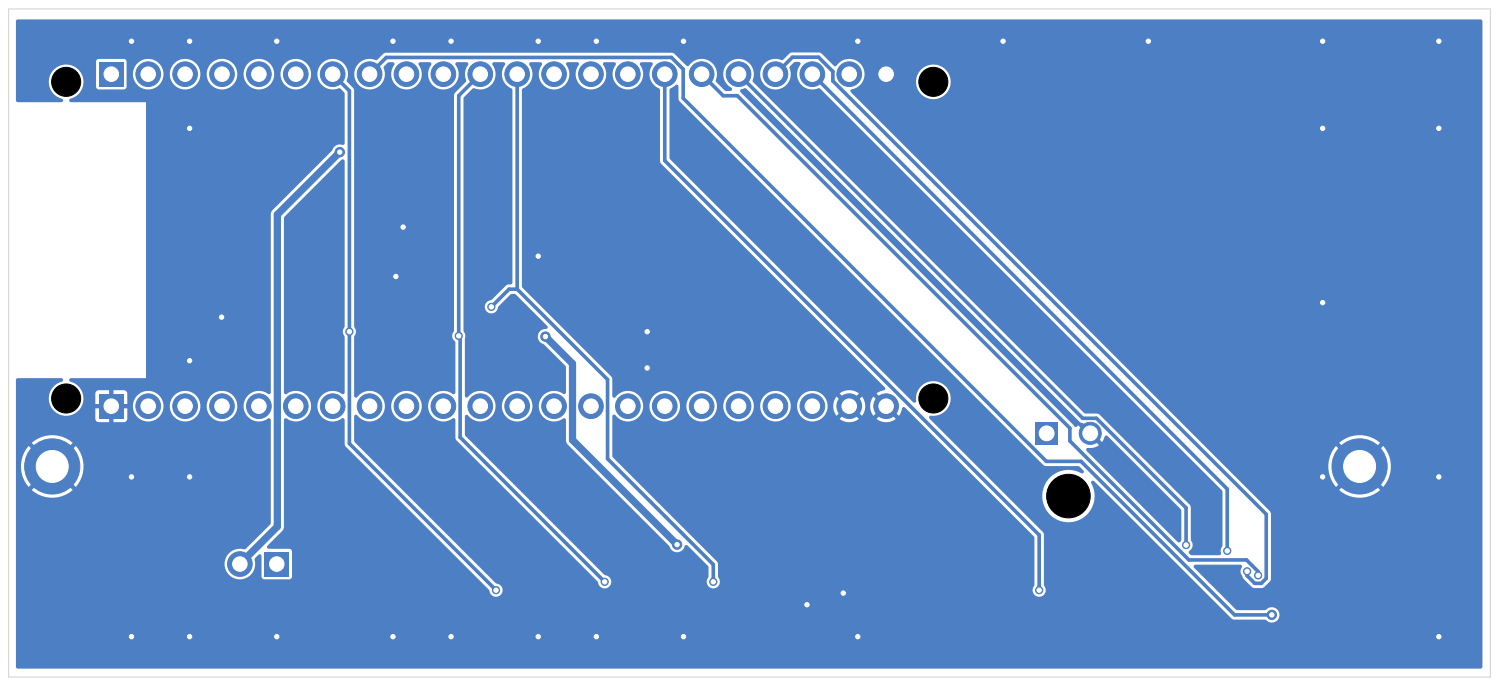
[picture p72: page 1]
