neo12242/RykerConnect/Hardware/REV05-USB/validation/board-F.pdf

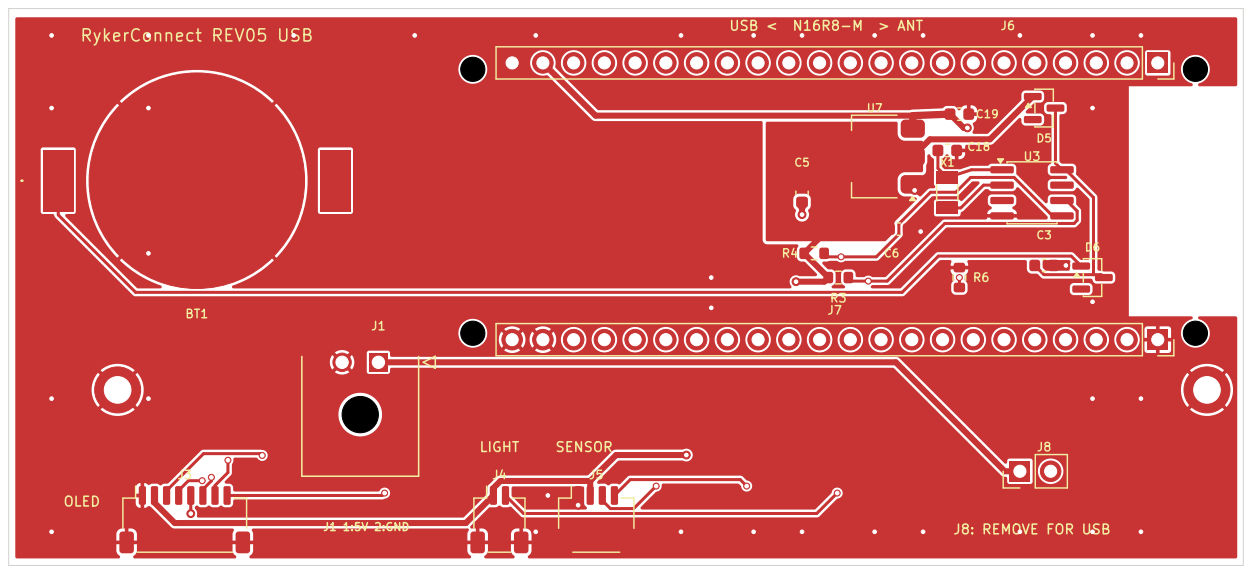
[picture p73: page 1]
