neo12242/RykerConnect/Hardware/REV05C-12V/validation/assembly-F.pdf

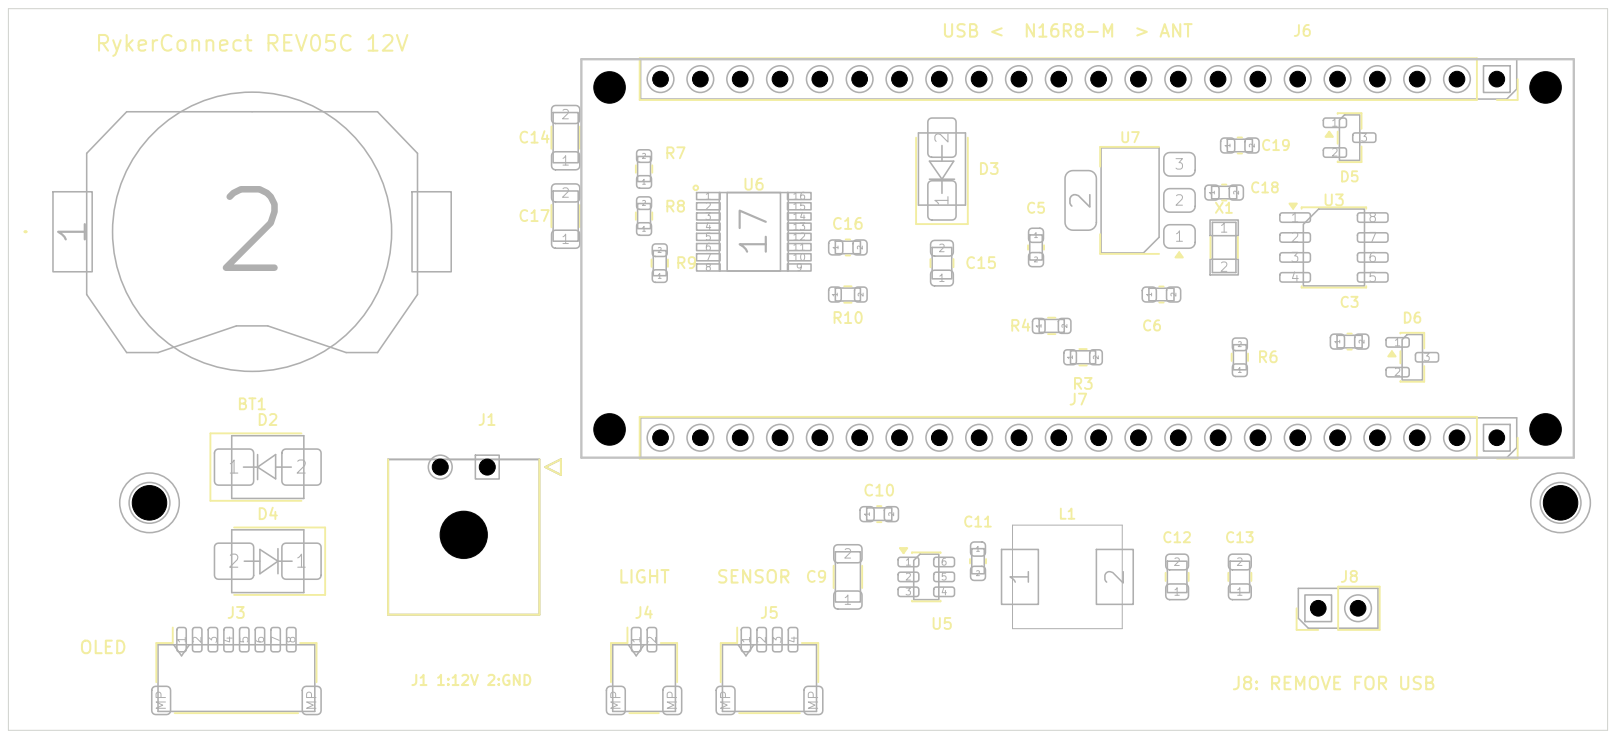
[picture p74: page 1]
