neo12242/RykerConnect/Hardware/REV05C-12V/validation/board-B.pdf

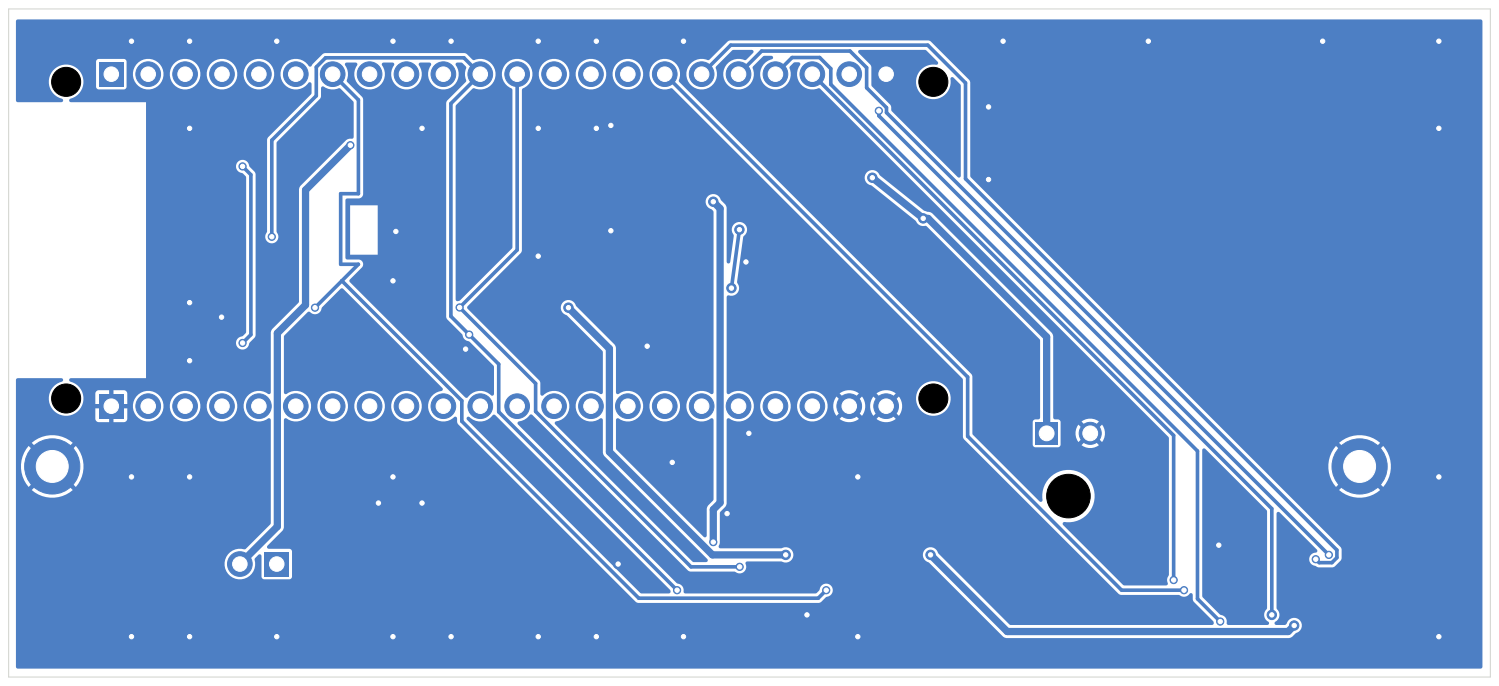
[picture p75: page 1]
