neo12242/RykerConnect/Hardware/REV05C-12V/validation/board-F.pdf

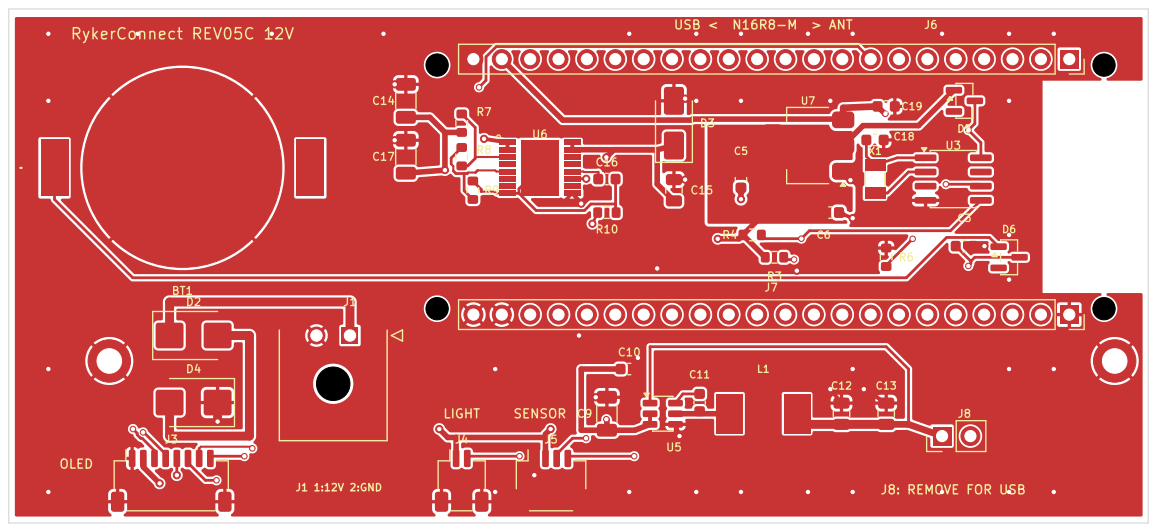
[picture p76: page 1]
