neo12242/RykerConnect/(list of files, drawings)

Other design files:
Hardware/REV03-Protected/validation/protection.dsn
Hardware/REV04-Carrier/validation/carrier.dsn
Hardware/REV04-Carrier/validation/reset.dsn
Hardware/REV05-12V/validation/carrier.dsn
Hardware/REV05-USB/validation/carrier.dsn
Hardware/REV05C-12V/validation/carrier.dsn
