neo12242/RykerConnect/Hardware/REV03-Protected/RykerConnect.kicad_pcb

## KiCad design Hardware/REV03-Protected/RykerConnect.kicad_pcb (2026-09-16)

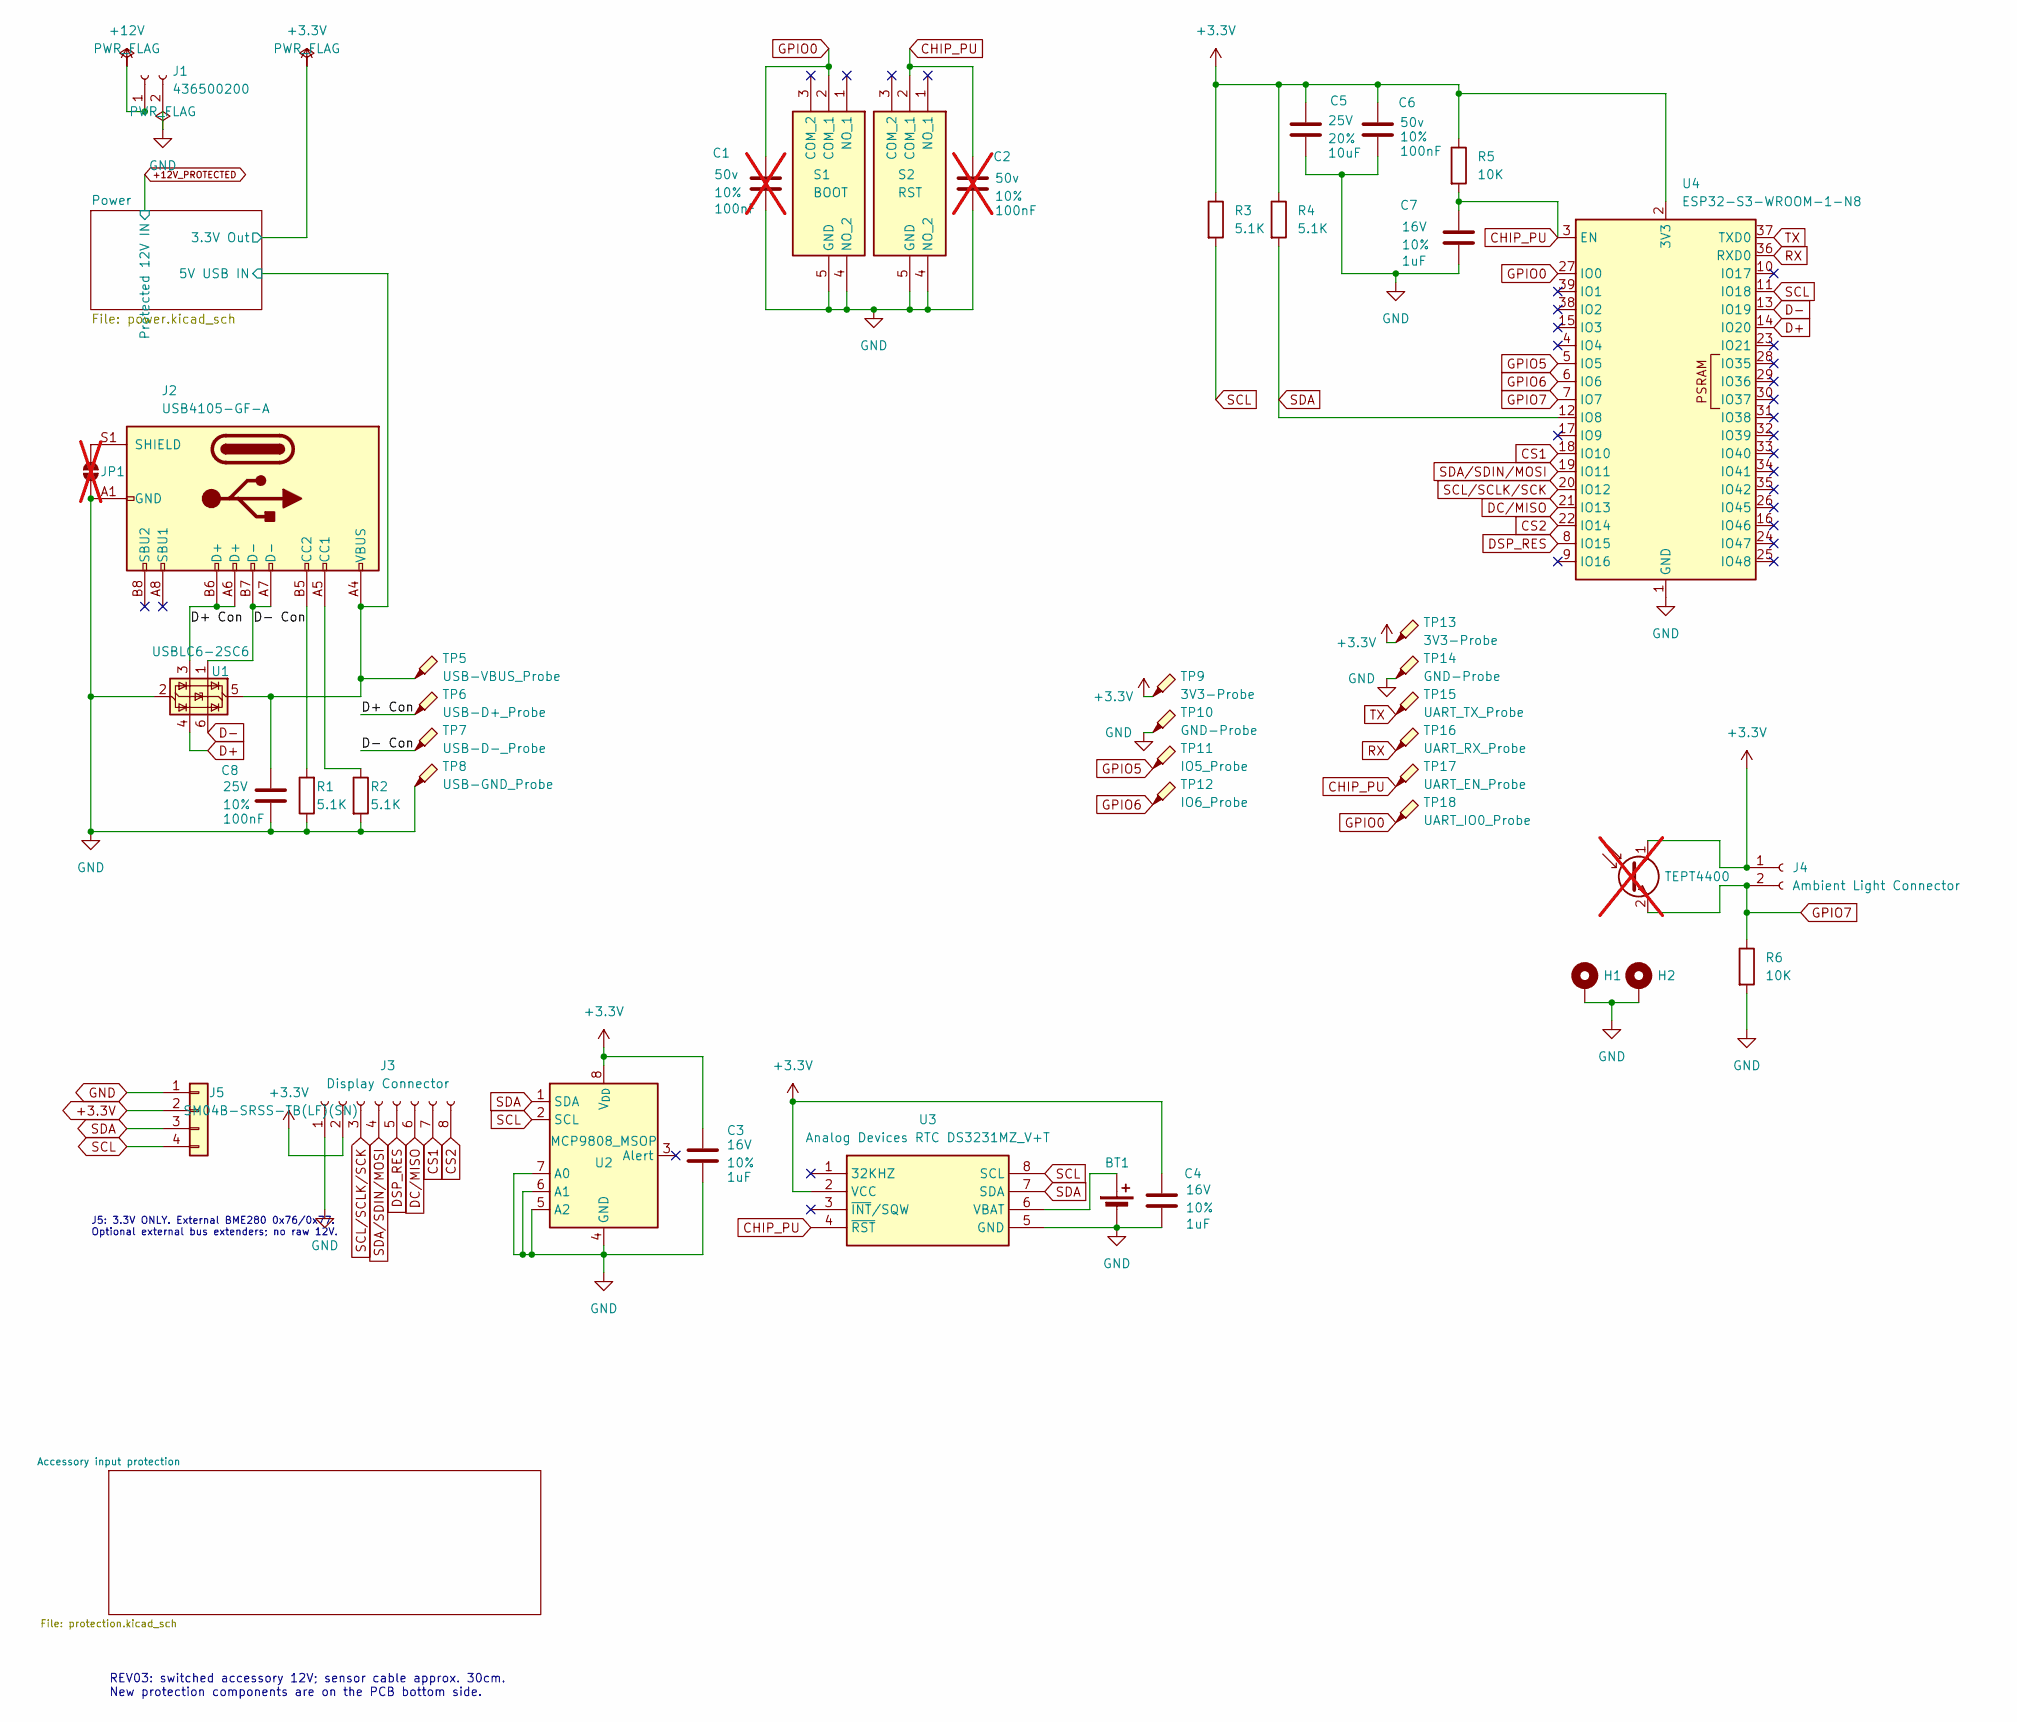
[picture p77: schematic RykerConnect.kicad_sch, RykerConnect - protected accessory input]

Parts:
BT1: Holders Linx CR2032; BT1_BATHLD001; MPN BAT-HLD-001; LCSC C7501066
C1: 100nF; C1_C_0603_1608Metric_Pad1.08x0.95mm_HandSolder; Voltage 50v; Tolerance 10%; not fitted
C2: 100nF; C2_C_0603_1608Metric_Pad1.08x0.95mm_HandSolder; Voltage 50v; Tolerance 10%; not fitted
C3: 1uF; C3_C_0603_1608Metric_Pad1.08x0.95mm_HandSolder; Voltage 16V; Tolerance 10%; MPN CL10B105KO8NNNC; LCSC C59782
C4: 1uF; C4_C_0603_1608Metric_Pad1.08x0.95mm_HandSolder; Voltage 16V; Tolerance 10%; MPN CL10B105KO8NNNC; LCSC C59782
C5: 10uF; C5_C_0603_1608Metric_Pad1.08x0.95mm_HandSolder; Voltage 25V; Tolerance 20%; MPN C1608X5R1E106M080AC; LCSC C2168289
C6: 100nF; C6_C_0603_1608Metric_Pad1.08x0.95mm_HandSolder; Voltage 50v; Tolerance 10%; MPN C0603C104K5RAC7082; LCSC C1882722
C7: 1uF; C7_C_0603_1608Metric_Pad1.08x0.95mm_HandSolder; Voltage 16V; Tolerance 10%; MPN CL10B105KO8NNNC; LCSC C59782
C8: 100nF; C8_C_0603_1608Metric_Pad1.08x0.95mm_HandSolder; Voltage 25V; Tolerance 10%; MPN C0603C104K3RACTU; LCSC C2167527
H1: MountingHole_Pad; H1_MountingHole_2.2mm_M2_ISO14580_Pad_TopBottom
H2: MountingHole_Pad; H2_MountingHole_2.2mm_M2_ISO14580_Pad_TopBottom
J1: 436500200; J1_43650-02_00,01,02_; MPN 436500200; LCSC C192562
J2: USB4105-GF-A; J2_USB_C_Receptacle_GCT_USB4105-xx-A_16P_TopMnt_Horizontal; MPN USB4105-GF-A; LCSC C3020560
J3: Display Connector; J3_JST_SH_SM08B-SRSS-TB_1x08-1MP_P1.00mm_Horizontal; MPN SM08B-SRSS-TB(LF)(SN); LCSC C160407
J4: Ambient Light Connector; J4_JST_SH_SM02B-SRSS-TB_1x02-1MP_P1.00mm_Horizontal; MPN SM02B-SRSS-TB(LF)(SN); LCSC C160402
J5: SM04B-SRSS-TB(LF)(SN); J5_JST_SH_SM04B-SRSS-TB_1x04-1MP_P1.00mm_Horizontal; MPN SM04B-SRSS-TB(LF)(SN); LCSC C160404
JP1: SolderJumper_2_Open; JP1_R_0603_1608Metric_Pad0.98x0.95mm_HandSolder; not fitted
Q1: TEPT4400; LED_D3.0mm_Clear; not fitted
R1: 5.1K; R1_R_0805_2012Metric_Pad1.20x1.40mm_HandSolder; MPN RS73F2ARTTD5101D; LCSC C5890991
R2: 5.1K; R2_R_0805_2012Metric_Pad1.20x1.40mm_HandSolder; MPN RS73F2ARTTD5101D; LCSC C5890991
R3: 5.1K; R3_R_0805_2012Metric_Pad1.20x1.40mm_HandSolder; MPN RS73F2ARTTD5101D; LCSC C5890991
R4: 5.1K; R4_R_0805_2012Metric_Pad1.20x1.40mm_HandSolder; MPN RS73F2ARTTD5101D; LCSC C5890991
R5: 10K; R5_R_0805_2012Metric_Pad1.20x1.40mm_HandSolder; Tolerance 1%; MPN CRGP0805F10K; LCSC C2074940
R6: 10K; R6_R_0805_2012Metric_Pad1.20x1.40mm_HandSolder; MPN CRGP0805F10K; LCSC C2074940
S1: BOOT; S1_435451019820; Mouser Part Number 710-435451019820
S2: RST; S2_435451019820; Mouser Part Number 710-435451019820
TP5: USB-VBUS_Probe; TP5_TestPoint_Pad_D1.0mm
TP6: USB-D+_Probe; TP6_TestPoint_Pad_D1.0mm
TP7: USB-D-_Probe; TP7_TestPoint_Pad_D1.0mm
TP8: USB-GND_Probe; TP8_TestPoint_Pad_D1.0mm
TP9: 3V3-Probe; TP9_TestPoint_Pad_D2.0mm
TP10: GND-Probe; TP10_TestPoint_Pad_D2.0mm
TP11: IO5_Probe; TP11_TestPoint_Pad_D2.0mm
TP12: IO6_Probe; TP12_TestPoint_Pad_D2.0mm
TP13: 3V3-Probe; TP13_TestPoint_Pad_D1.5mm
TP14: GND-Probe; TP14_TestPoint_Pad_D1.5mm
TP15: UART_TX_Probe; TP15_TestPoint_Pad_D1.5mm
TP16: UART_RX_Probe; TP16_TestPoint_Pad_D1.5mm
TP17: UART_EN_Probe; TP17_TestPoint_Pad_D1.5mm
TP18: UART_IO0_Probe; TP18_TestPoint_Pad_D1.5mm
U1: USBLC6-2SC6; U1_SOT-23-6; MPN USBLC6-2SC6; LCSC C7519
U2: MCP9808_MSOP; U2_MSOP-8_3x3mm_P0.65mm; MPN MCP9808T-E/MS; LCSC C129490
U3: Analog Devices RTC DS3231MZ_V+T; U3_SOIC127P600X175-8N; Mouser Part Number 700-DS3231MZ/V+T
U4: ESP32-S3-WROOM-1-N8; U4_ESP32-S3-WROOM-1; MPN ESP32-S3-WROOM-1-N8; LCSC C2913198

Connections:
+3.3V: C3.1, C4.1, C5.1, C6.1, J3.2, J4.1, J5.2, Q1.1 (C), R3.1, R4.1, R5.1, TP9.1 (1_1), TP13.1 (1_1), U2.8 (V_{DD}), U3.2 (VCC), U4.2 (3V3); also elsewhere on the board
+12V: J1.1; also elsewhere on the board
/D+ Con: J2.A6 (D+), J2.B6 (D+), TP6.1 (1_1), U1.3 (I/O2)
/D- Con: J2.A7 (D-), J2.B7 (D-), TP7.1 (1_1), U1.1 (I/O1)
/Power/5V USB IN: C8.1, J2.A4 (VBUS), J2.A9 (VBUS), J2.B4 (VBUS), J2.B9 (VBUS), TP5.1 (1_1), U1.5 (VBUS); also elsewhere on the board
CHIP_PU: C2.1, C7.1, R5.2, S2.2 (COM_1), TP17.1 (1_1), U3.4 (~RST), U4.3 (EN)
CS1: J3.7, U4.18 (IO10)
CS2: J3.8, U4.22 (IO14)
D+: U1.4 (I/O2), U4.14 (IO20)
D-: U1.6 (I/O1), U4.13 (IO19)
DC/MISO: J3.6, U4.21 (IO13)
DSP_RES: J3.5, U4.8 (IO15)
GND: BT1.2 (-), C1.2, C2.2, C3.2, C4.2, C5.2, C6.2, C7.2, C8.2, H1.1 (1_1), H2.1 (1_1), J1.2, J2.A1 (GND), J2.A12 (GND), J2.B1 (GND), J2.B12 (GND), J3.1, J5.1, J5.MP (Mounting anchors), JP1.1 (A), R1.1, R2.2, R6.2, S1.4 (NO_2), S1.5 (GND), S2.4 (NO_2), S2.5 (GND), TP8.1 (1_1), TP10.1 (1_1), TP14.1 (1_1), U1.2 (GND), U2.4 (GND), U2.5 (A2), U2.6 (A1), U2.7 (A0), U3.5 (GND), U4.1 (GND), U4.40 (GND); also elsewhere on the board
GPIO0: C1.1, S1.2 (COM_1), TP18.1 (1_1), U4.27 (IO0)
GPIO5: TP11.1 (1_1), U4.5 (IO5)
GPIO6: TP12.1 (1_1), U4.6 (IO6)
GPIO7: J4.2, Q1.2 (E), R6.1, U4.7 (IO7)
unnamed: BT1.1 (+), U3.6 (VBAT)
unnamed: J2.A5 (CC1), R2.1
unnamed: J2.B5 (CC2), R1.2
unnamed: J2.S1 (SHIELD), JP1.2 (B)
RX: TP16.1 (1_1), U4.36 (RXD0)
SCL: J5.4, R3.2, U2.2 (SCL), U3.8 (SCL), U4.11 (IO18)
SCL/SCLK/SCK: J3.3, U4.20 (IO12)
SDA: J5.3, R4.2, U2.1 (SDA), U3.7 (SDA), U4.12 (IO8)
SDA/SDIN/MOSI: J3.4, U4.19 (IO11)
TX: TP15.1 (1_1), U4.37 (TXD0)

Notes on the sheet:
J5: 3.3V ONLY. External BME280 0x76/0x77. Optional external bus extenders; no raw 12V.
REV03: switched accessory 12V; sensor cable approx. 30cm. New protection components are on the PCB bottom side.

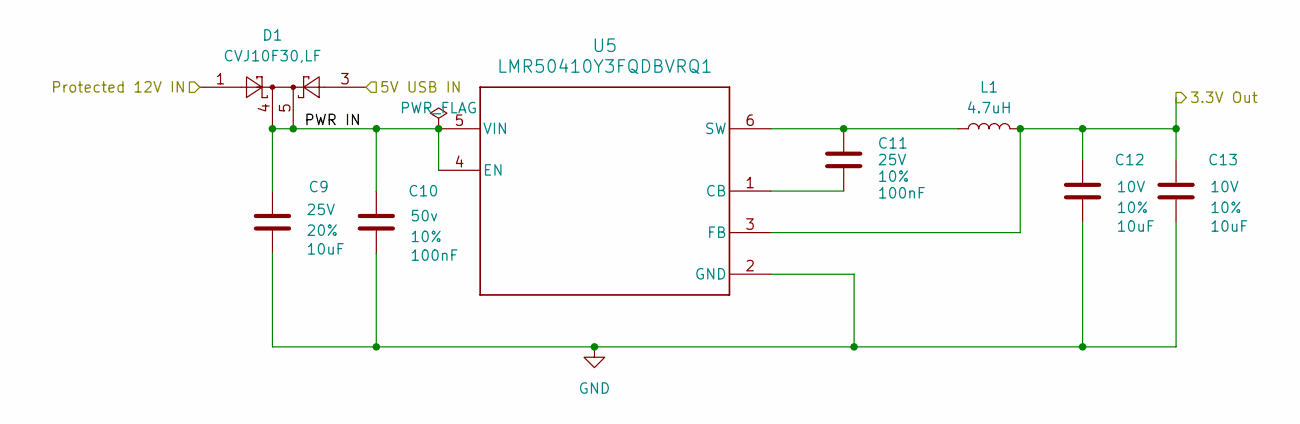
[picture p78: schematic power.kicad_sch, RykerConnect - protected accessory input]

Parts:
C9: 10uF; C9_C_0603_1608Metric_Pad1.08x0.95mm_HandSolder; Voltage 25V; Tolerance 20%; MPN C1608X5R1E106M080AC; LCSC C2168289
C10: 100nF; C10_C_0603_1608Metric_Pad1.08x0.95mm_HandSolder; Voltage 50v; Tolerance 10%; MPN C0603C104K5RAC7082; LCSC C1882722
C11: 100nF; C11_C_0603_1608Metric_Pad1.08x0.95mm_HandSolder; Voltage 25V; Tolerance 10%; MPN C0603C104K3RACTU; LCSC C2167527
C12: 10uF; C12_C_0805_2012Metric_Pad1.18x1.45mm_HandSolder; Voltage 10V; Tolerance 10%; MPN C0805C106K8PACTU; LCSC C2167673
C13: 10uF; C13_C_0805_2012Metric_Pad1.18x1.45mm_HandSolder; Voltage 10V; Tolerance 10%; MPN C0805C106K8PACTU; LCSC C2167673
D1: CVJ10F30,LF; D1_SOTFL65P210X75-5N; MPN CVJ10F30,LF; LCSC C5609371
L1: 4.7uH; L1_INDPM5653X430N; MPN 744316470; LCSC C2651181
U5: LMR50410Y3FQDBVRQ1; U5_DBV0006A-IPC_A; MPN LMR50410Y3FQDBVRQ1; LCSC C5219374

Connections:
+3.3V: C12.1, C13.1, L1.2, U5.3 (FB); also elsewhere on the board
+12V_PROTECTED: D1.1; also elsewhere on the board
/Power/5V USB IN: D1.3; also elsewhere on the board
/Power/PWR IN: C9.1, C10.1, D1.4, D1.5, U5.4 (EN), U5.5 (VIN)
GND: C9.2, C10.2, C12.2, C13.2, U5.2 (GND); also elsewhere on the board
unnamed: C11.2, U5.1 (CB)
unnamed: C11.1, L1.1, U5.6 (SW)

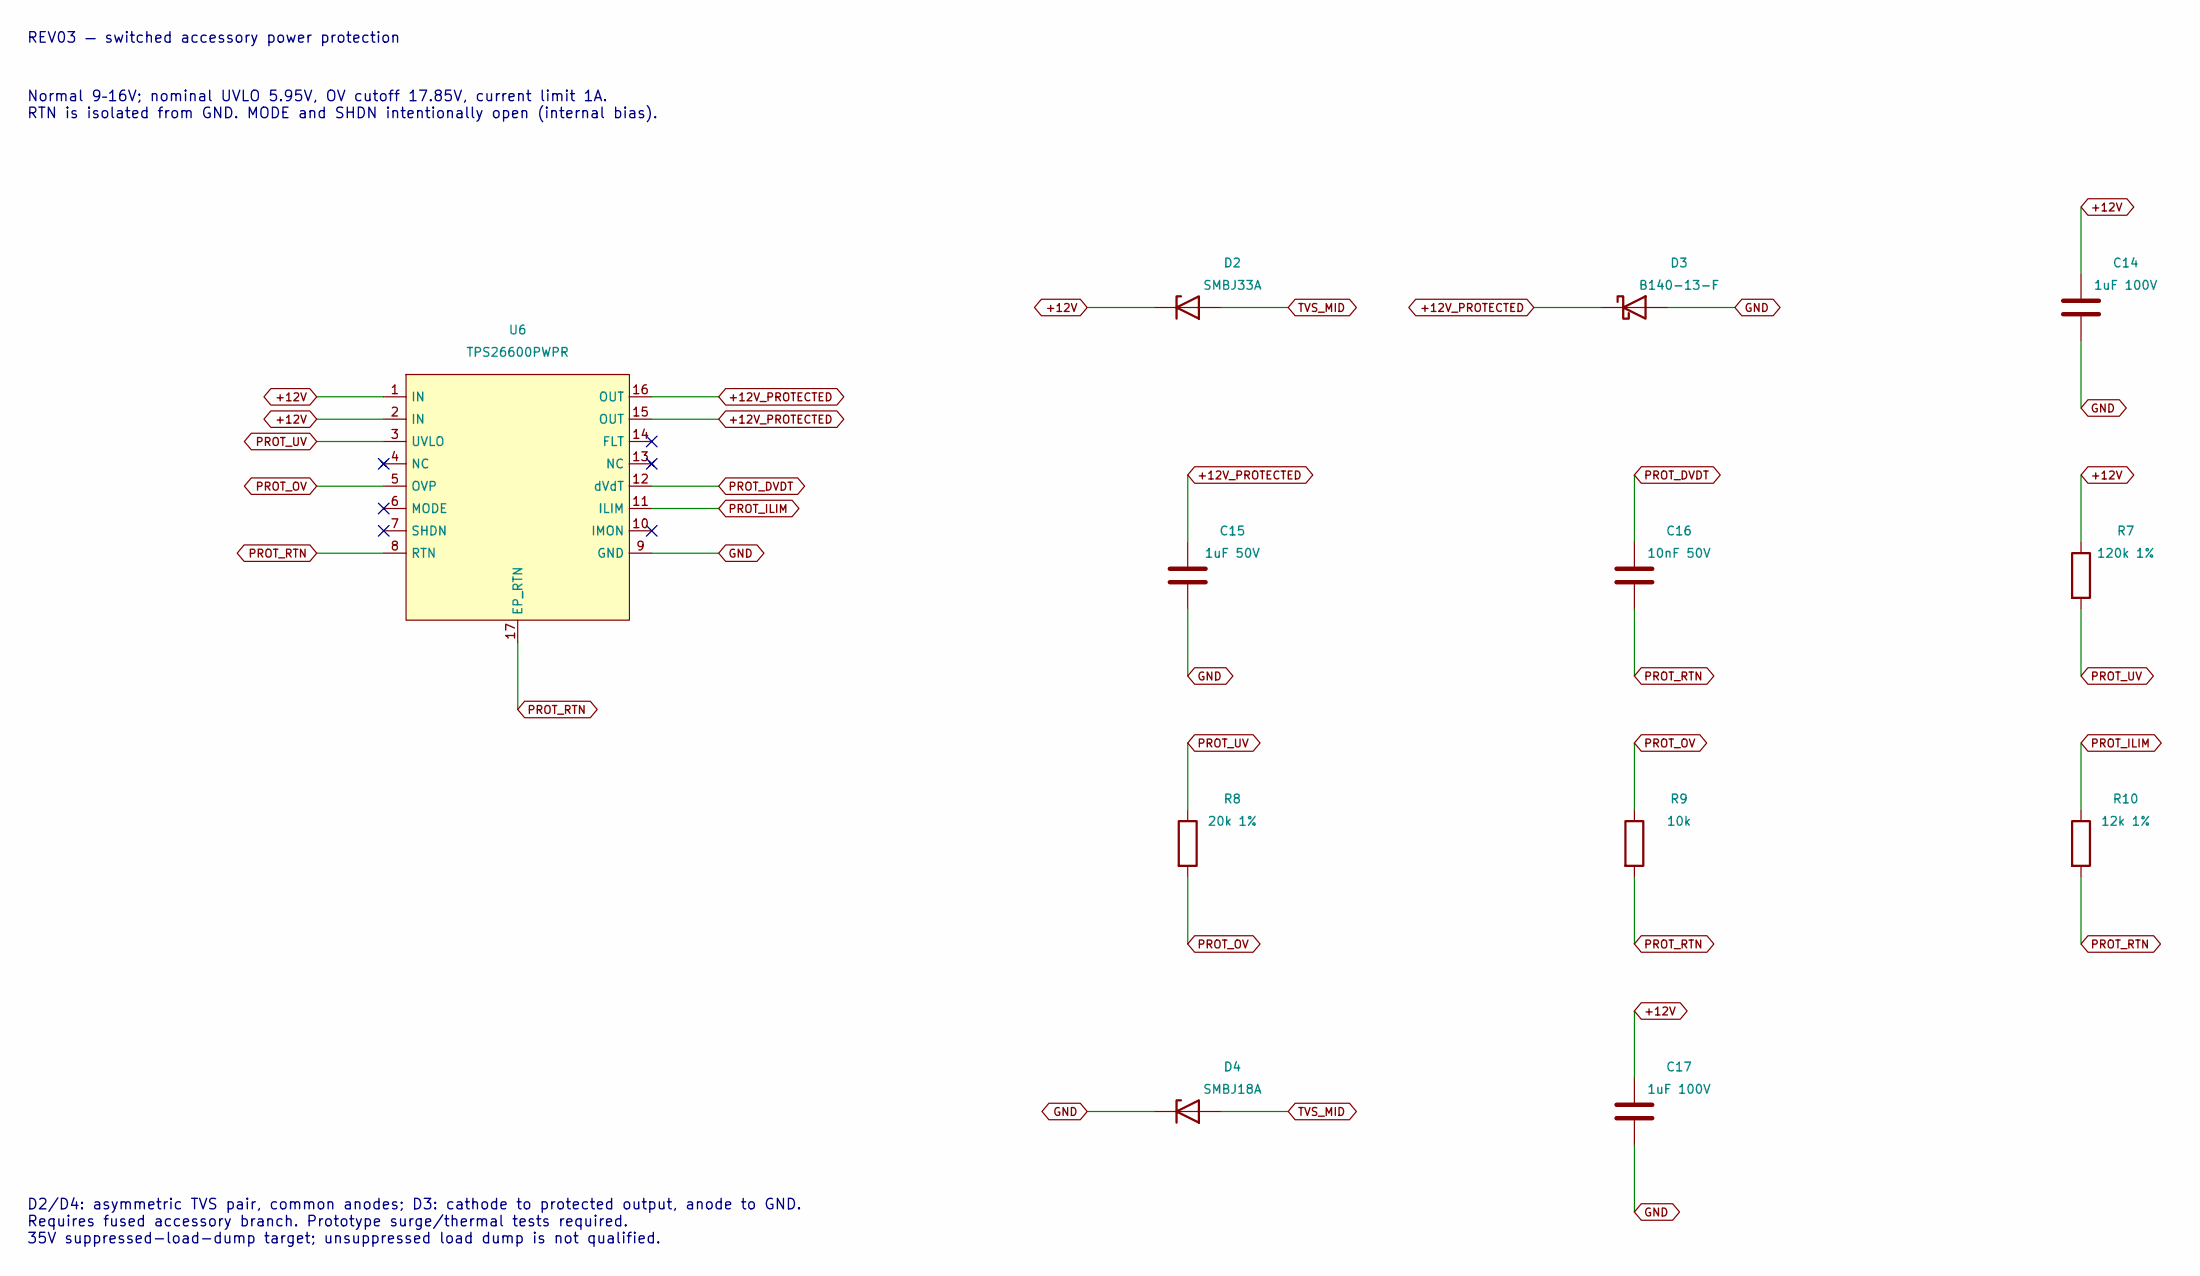
[picture p79: schematic protection.kicad_sch, RykerConnect - protected accessory input]

Parts:
C14: 1uF 100V; C14_C_1206_3216Metric; MPN CL31B105KCHNNNE; LCSC C13832
C15: 1uF 50V; C15_C_0805_2012Metric; MPN CL21B105KBFNNNE; LCSC C28323
C16: 10nF 50V; C16_C_0603_1608Metric; MPN CL10B103KB8NNNC; LCSC C1589
C17: 1uF 100V; C17_C_1206_3216Metric; MPN CL31B105KCHNNNE; LCSC C13832
D2: SMBJ33A; D2_D_SMB; MPN SMBJ33A; LCSC C224019
D3: B140-13-F; D3_D_SMA; MPN B140-13-F; LCSC C15759
D4: SMBJ18A; D4_D_SMB; MPN SMBJ18A; LCSC C151256
R7: 120k 1%; R7_R_0603_1608Metric; MPN RC0603FR-07120KL; LCSC C114607
R8: 20k 1%; R8_R_0603_1608Metric; MPN RC0603FR-0720KL; LCSC C105575
R9: 10k; R9_R_0805_2012Metric; MPN CRGP0805F10K; LCSC C2074940
R10: 12k 1%; R10_R_0603_1608Metric; MPN RC0603FR-0712KL; LCSC C114659
U6: TPS26600PWPR; U6_Protection_HTSSOP16_PWP0016A; MPN TPS26600PWPR; LCSC C544399

Connections:
+12V: C14.1, C17.1, D2.1 (K), R7.1, U6.1 (IN), U6.2 (IN); also elsewhere on the board
+12V_PROTECTED: C15.1, D3.1 (K), U6.15 (OUT), U6.16 (OUT); also elsewhere on the board
GND: C14.2, C15.2, C17.2, D3.2 (A), D4.1 (K), U6.9 (GND); also elsewhere on the board
PROT_DVDT: C16.1, U6.12 (dVdT)
PROT_ILIM: R10.1, U6.11 (ILIM)
PROT_OV: R8.2, R9.1, U6.5 (OVP)
PROT_RTN: C16.2, R9.2, R10.2, U6.8 (RTN), U6.17 (EP_RTN)
PROT_UV: R7.2, R8.1, U6.3 (UVLO)
TVS_MID: D2.2 (A), D4.2 (A)

Notes on the sheet:
REV03 — switched accessory power protection
Normal 9–16V; nominal UVLO 5.95V, OV cutoff 17.85V, current limit 1A. RTN is isolated from GND. MODE and SHDN intentionally open (internal bias).
D2/D4: asymmetric TVS pair, common anodes; D3: cathode to protected output, anode to GND. Requires fused accessory branch. Prototype surge/thermal tests required. 35V suppressed-load-dump target; unsuppressed load dump is not qualified.

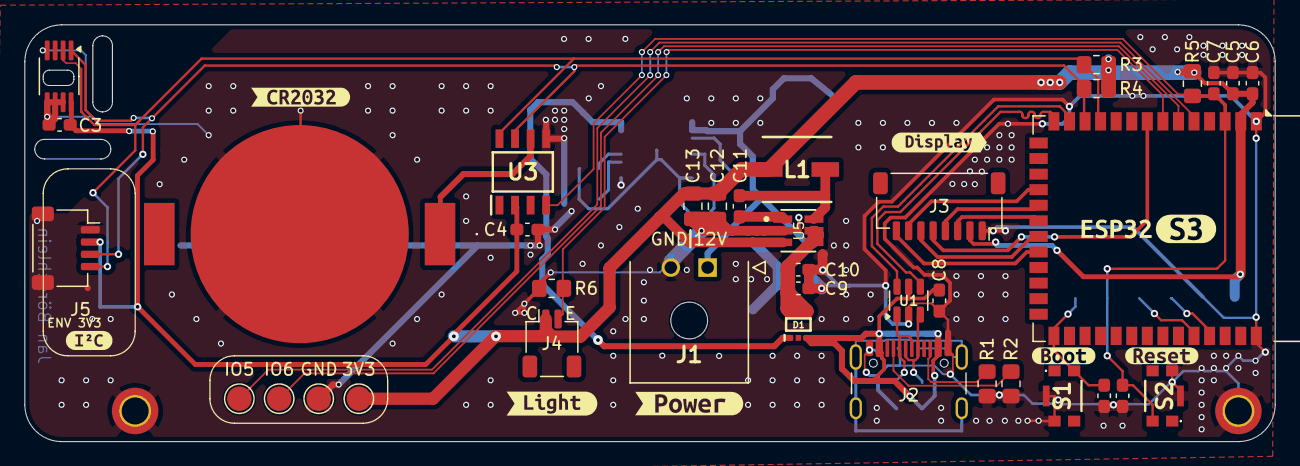
[picture p80: board Hardware/REV03-Protected/RykerConnect.kicad_pcb from above]

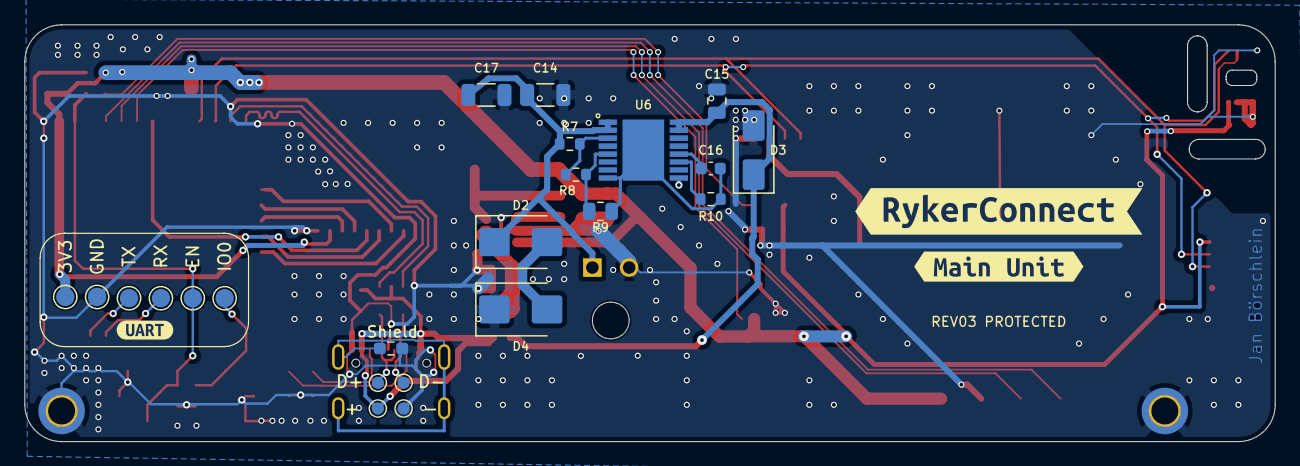
[picture p81: board Hardware/REV03-Protected/RykerConnect.kicad_pcb from below]

Board: 2 copper layers, 102.0 x 34.0 mm, 75 parts (27 on the bottom side), 37 nets.

Other parts of the board:
kibuzzard-66281C1F: G***; kibuzzard-66281C1F
kibuzzard-66281DA5: G***; kibuzzard-66281DA5
kibuzzard-66281FA1: G***; kibuzzard-66281FA1
kibuzzard-66282B71: G***; kibuzzard-66282B71
kibuzzard-66296C5A: G***; kibuzzard-66296C5A
kibuzzard-662805BB: G***; kibuzzard-662805BB
kibuzzard-662805C3: G***; kibuzzard-662805C3
kibuzzard-6628061E: G***; kibuzzard-6628061E
kibuzzard-6628064B: G***; kibuzzard-6628064B
kibuzzard-6628065E: G***; kibuzzard-6628065E
kibuzzard-66280634: G***; kibuzzard-66280634
kibuzzard-66281340: G***; kibuzzard-66281340
