neo12242/RykerConnect/Hardware/REV04-Carrier/RykerConnect.kicad_pcb

## KiCad design Hardware/REV04-Carrier/RykerConnect.kicad_pcb (2026-09-16)

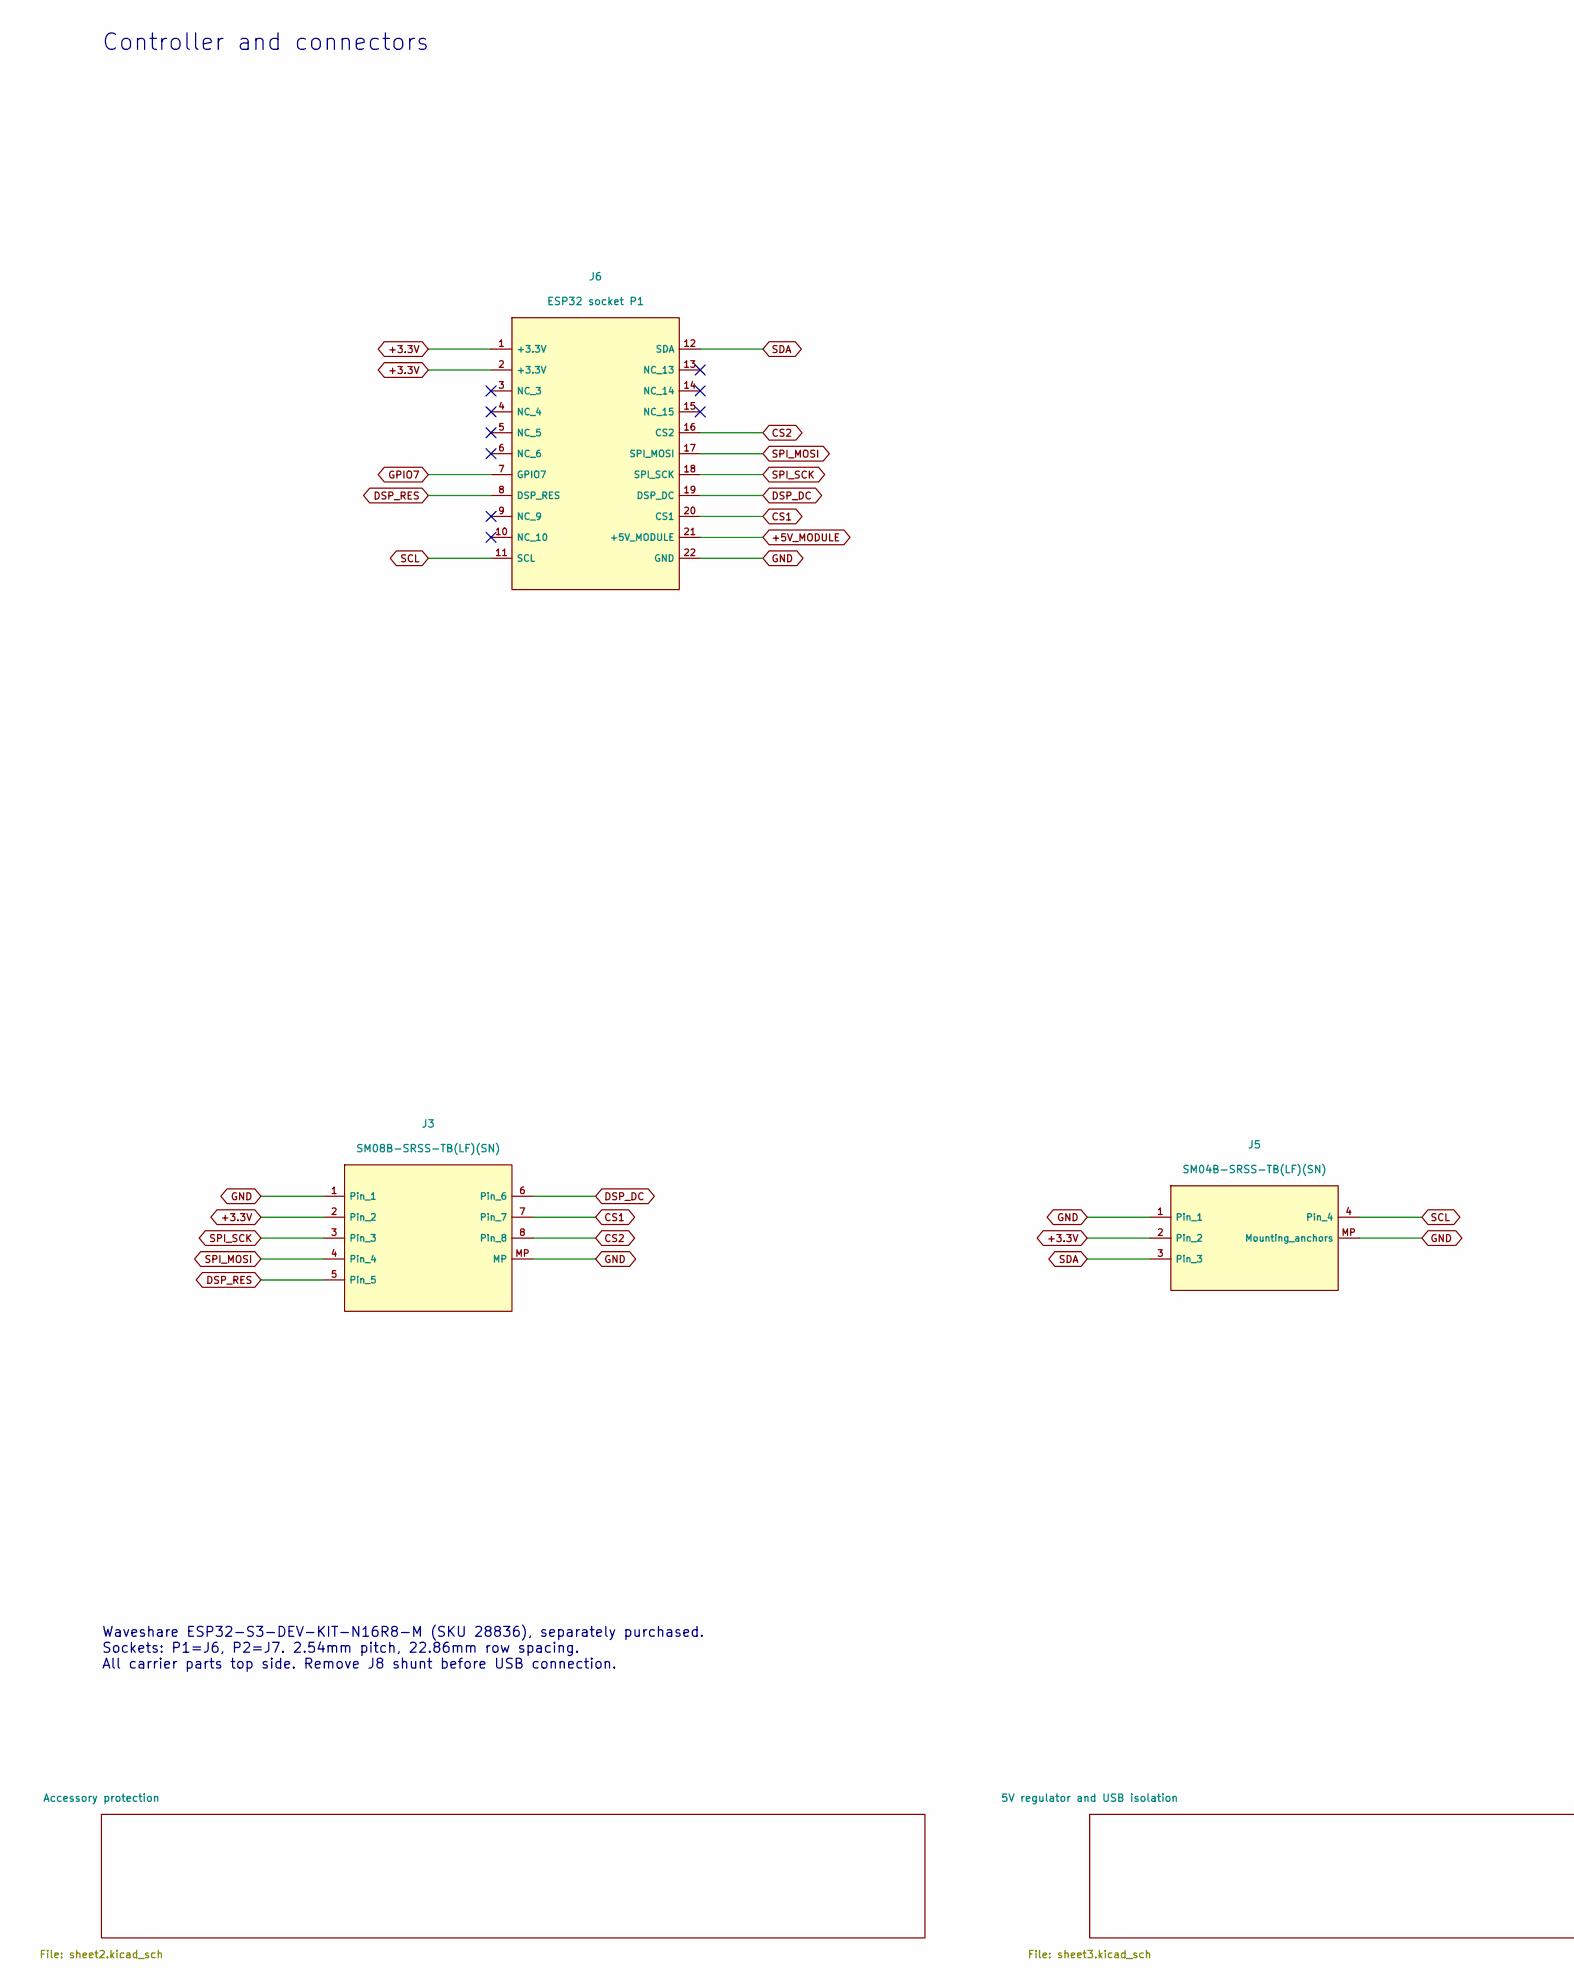
[picture p82: schematic RykerConnect.kicad_sch, RykerConnect - Controller and connectors, part in row 1, column 1]

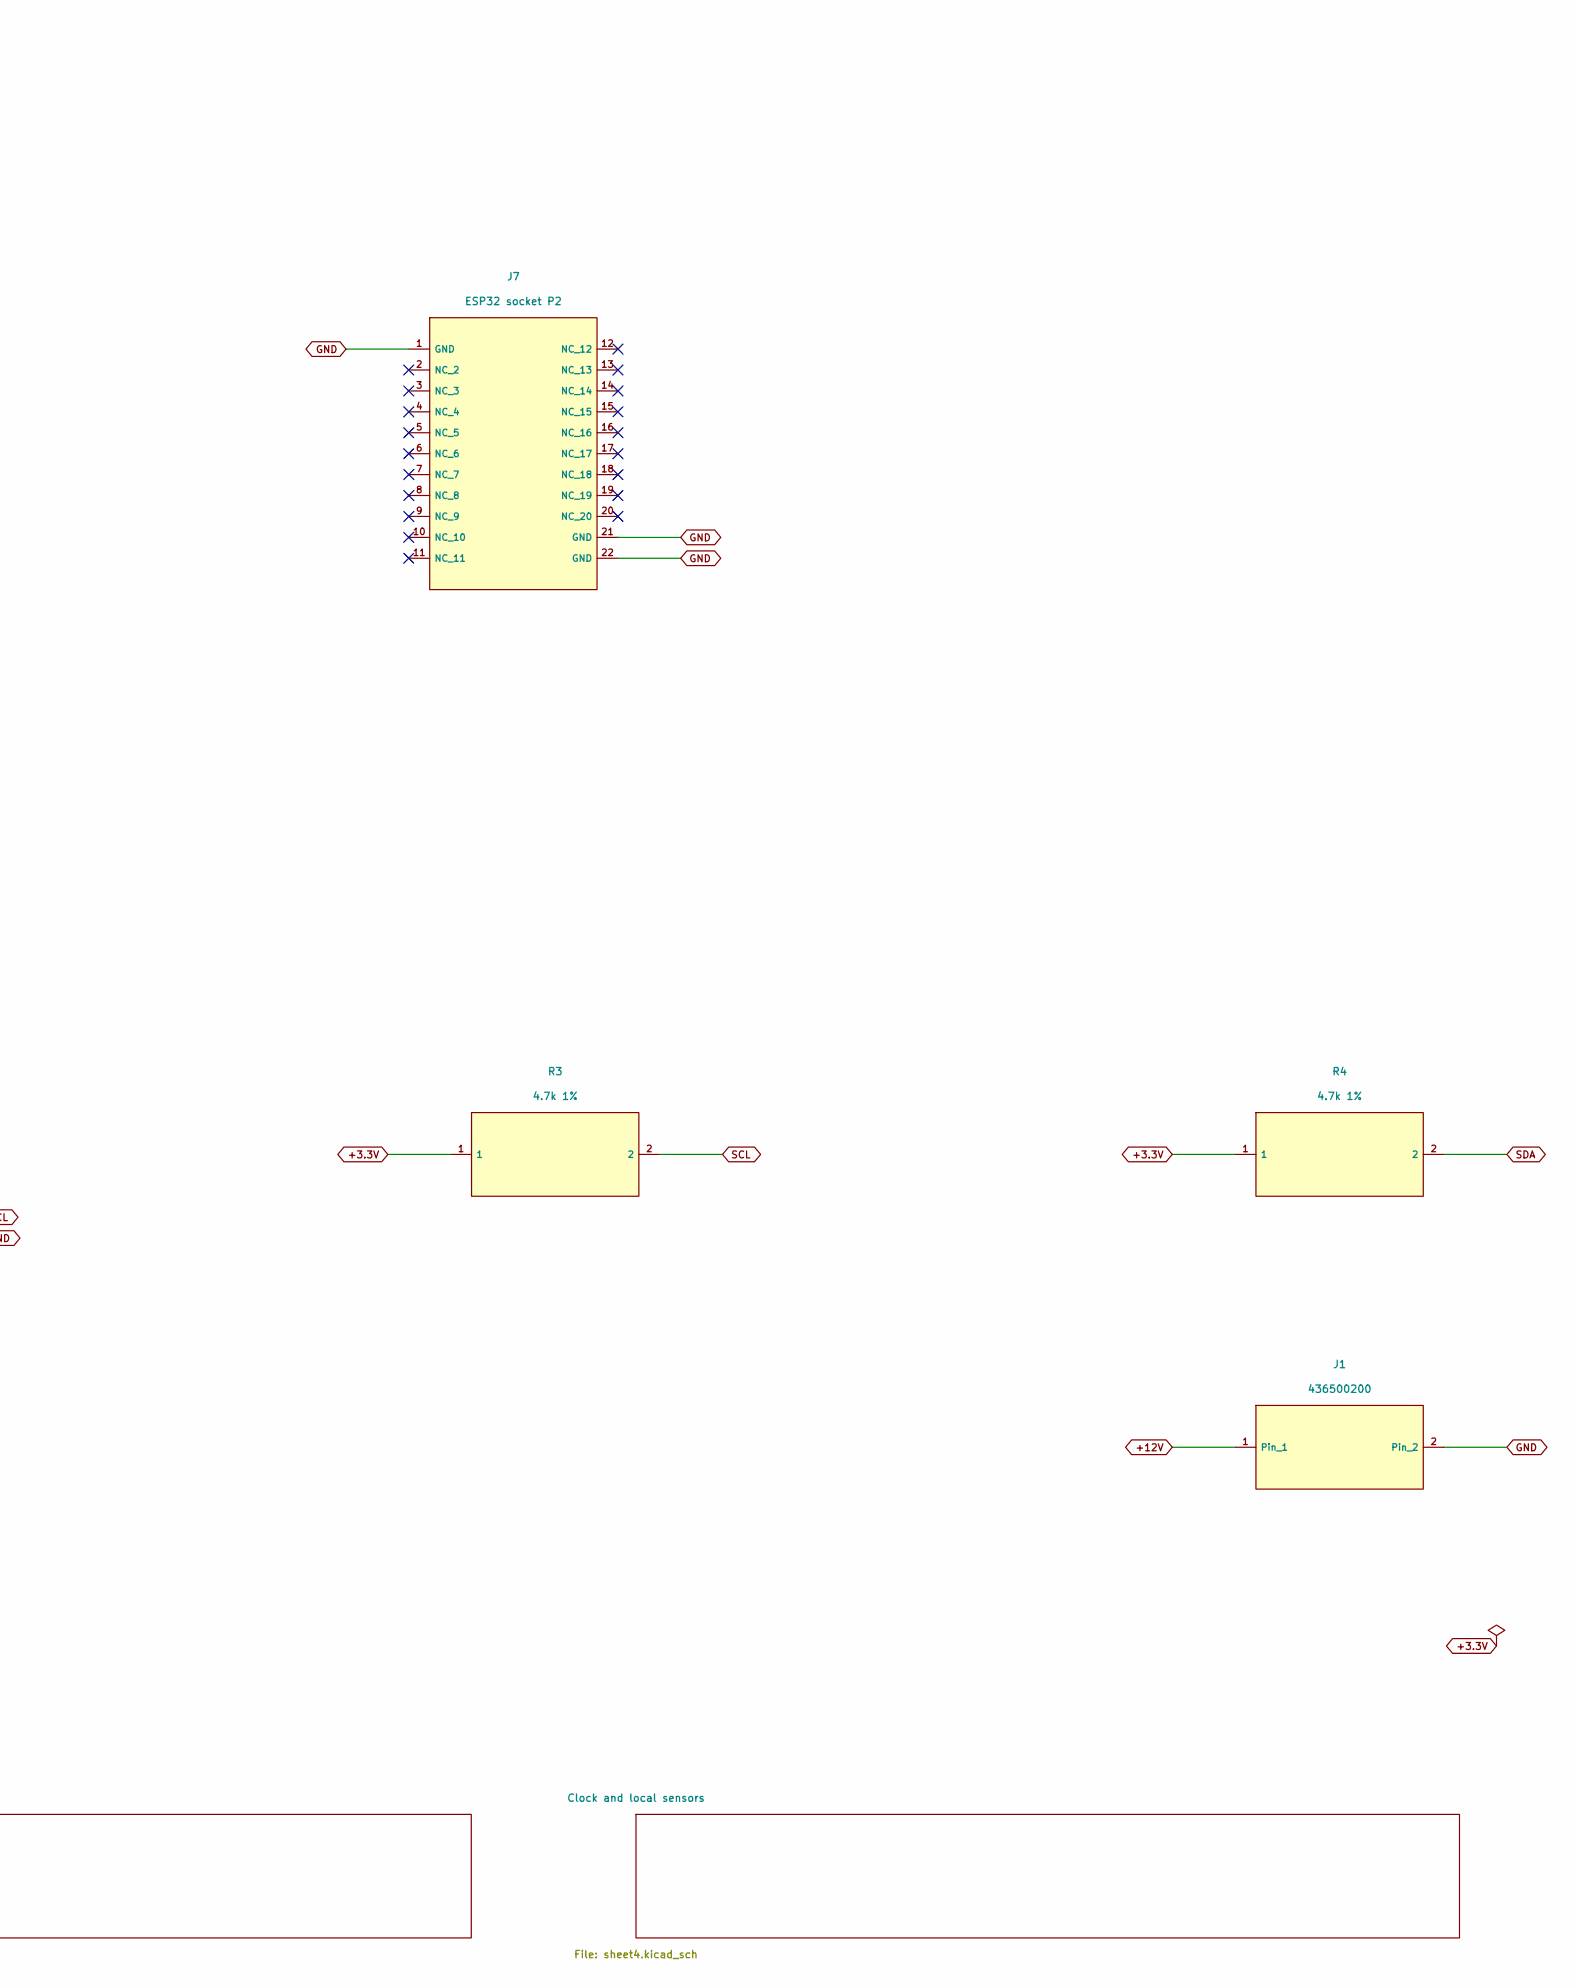
[picture p83: schematic RykerConnect.kicad_sch, RykerConnect - Controller and connectors, part in row 1, column 2]

Parts:
J1: 436500200; J1_J1_43650-02_00,01,02_; MPN 436500200; LCSC C192562
J3: SM08B-SRSS-TB(LF)(SN); J3_J3_JST_SH_SM08B-SRSS-TB_1x08-1MP_P1.00mm_Horizontal; MPN SM08B-SRSS-TB(LF)(SN); LCSC C160407
J5: SM04B-SRSS-TB(LF)(SN); J5_J5_JST_SH_SM04B-SRSS-TB_1x04-1MP_P1.00mm_Horizontal; MPN SM04B-SRSS-TB(LF)(SN); LCSC C160404
J6: ESP32 socket P1; J6_PinSocket_1x22_P2.54mm_Vertical; MPN FH2.54-09-22PZD; LCSC C7500786
J7: ESP32 socket P2; J7_PinSocket_1x22_P2.54mm_Vertical; MPN FH2.54-09-22PZD; LCSC C7500786
R3: 4.7k 1%; R3_R_0603_1608Metric; MPN 0603WAF4701T5E; LCSC C23162
R4: 4.7k 1%; R4_R_0603_1608Metric; MPN 0603WAF4701T5E; LCSC C23162

Connections:
+3.3V: J3.2, J5.2, J6.1 (+3.3V), J6.2 (+3.3V), R3.1, R4.1; also elsewhere on the board
+5V_MODULE: J6.21 (+5V_MODULE); also elsewhere on the board
+12V: J1.1; also elsewhere on the board
CS1: J3.7, J6.20 (CS1)
CS2: J3.8, J6.16 (CS2)
DSP_DC: J3.6, J6.19 (DSP_DC)
DSP_RES: J3.5, J6.8 (DSP_RES)
GND: J1.2, J3.1, J3.MP, J5.1, J5.MP (Mounting_anchors), J6.22 (GND), J7.1 (GND), J7.21 (GND), J7.22 (GND); also elsewhere on the board
GPIO7: J6.7 (GPIO7); also elsewhere on the board
SCL: J5.4, J6.11 (SCL), R3.2; also elsewhere on the board
SDA: J5.3, J6.12 (SDA), R4.2; also elsewhere on the board
SPI_MOSI: J3.4, J6.17 (SPI_MOSI)
SPI_SCK: J3.3, J6.18 (SPI_SCK)

Notes on the sheet:
Controller and connectors
Waveshare ESP32-S3-DEV-KIT-N16R8-M (SKU 28836), separately purchased. Sockets: P1=J6, P2=J7. 2.54mm pitch, 22.86mm row spacing. All carrier parts top side. Remove J8 shunt before USB connection.
