neo12242/RykerConnect/Hardware/REV04-Carrier/RykerConnect.kicad_pcb

## KiCad design Hardware/REV04-Carrier/RykerConnect.kicad_pcb (continued)

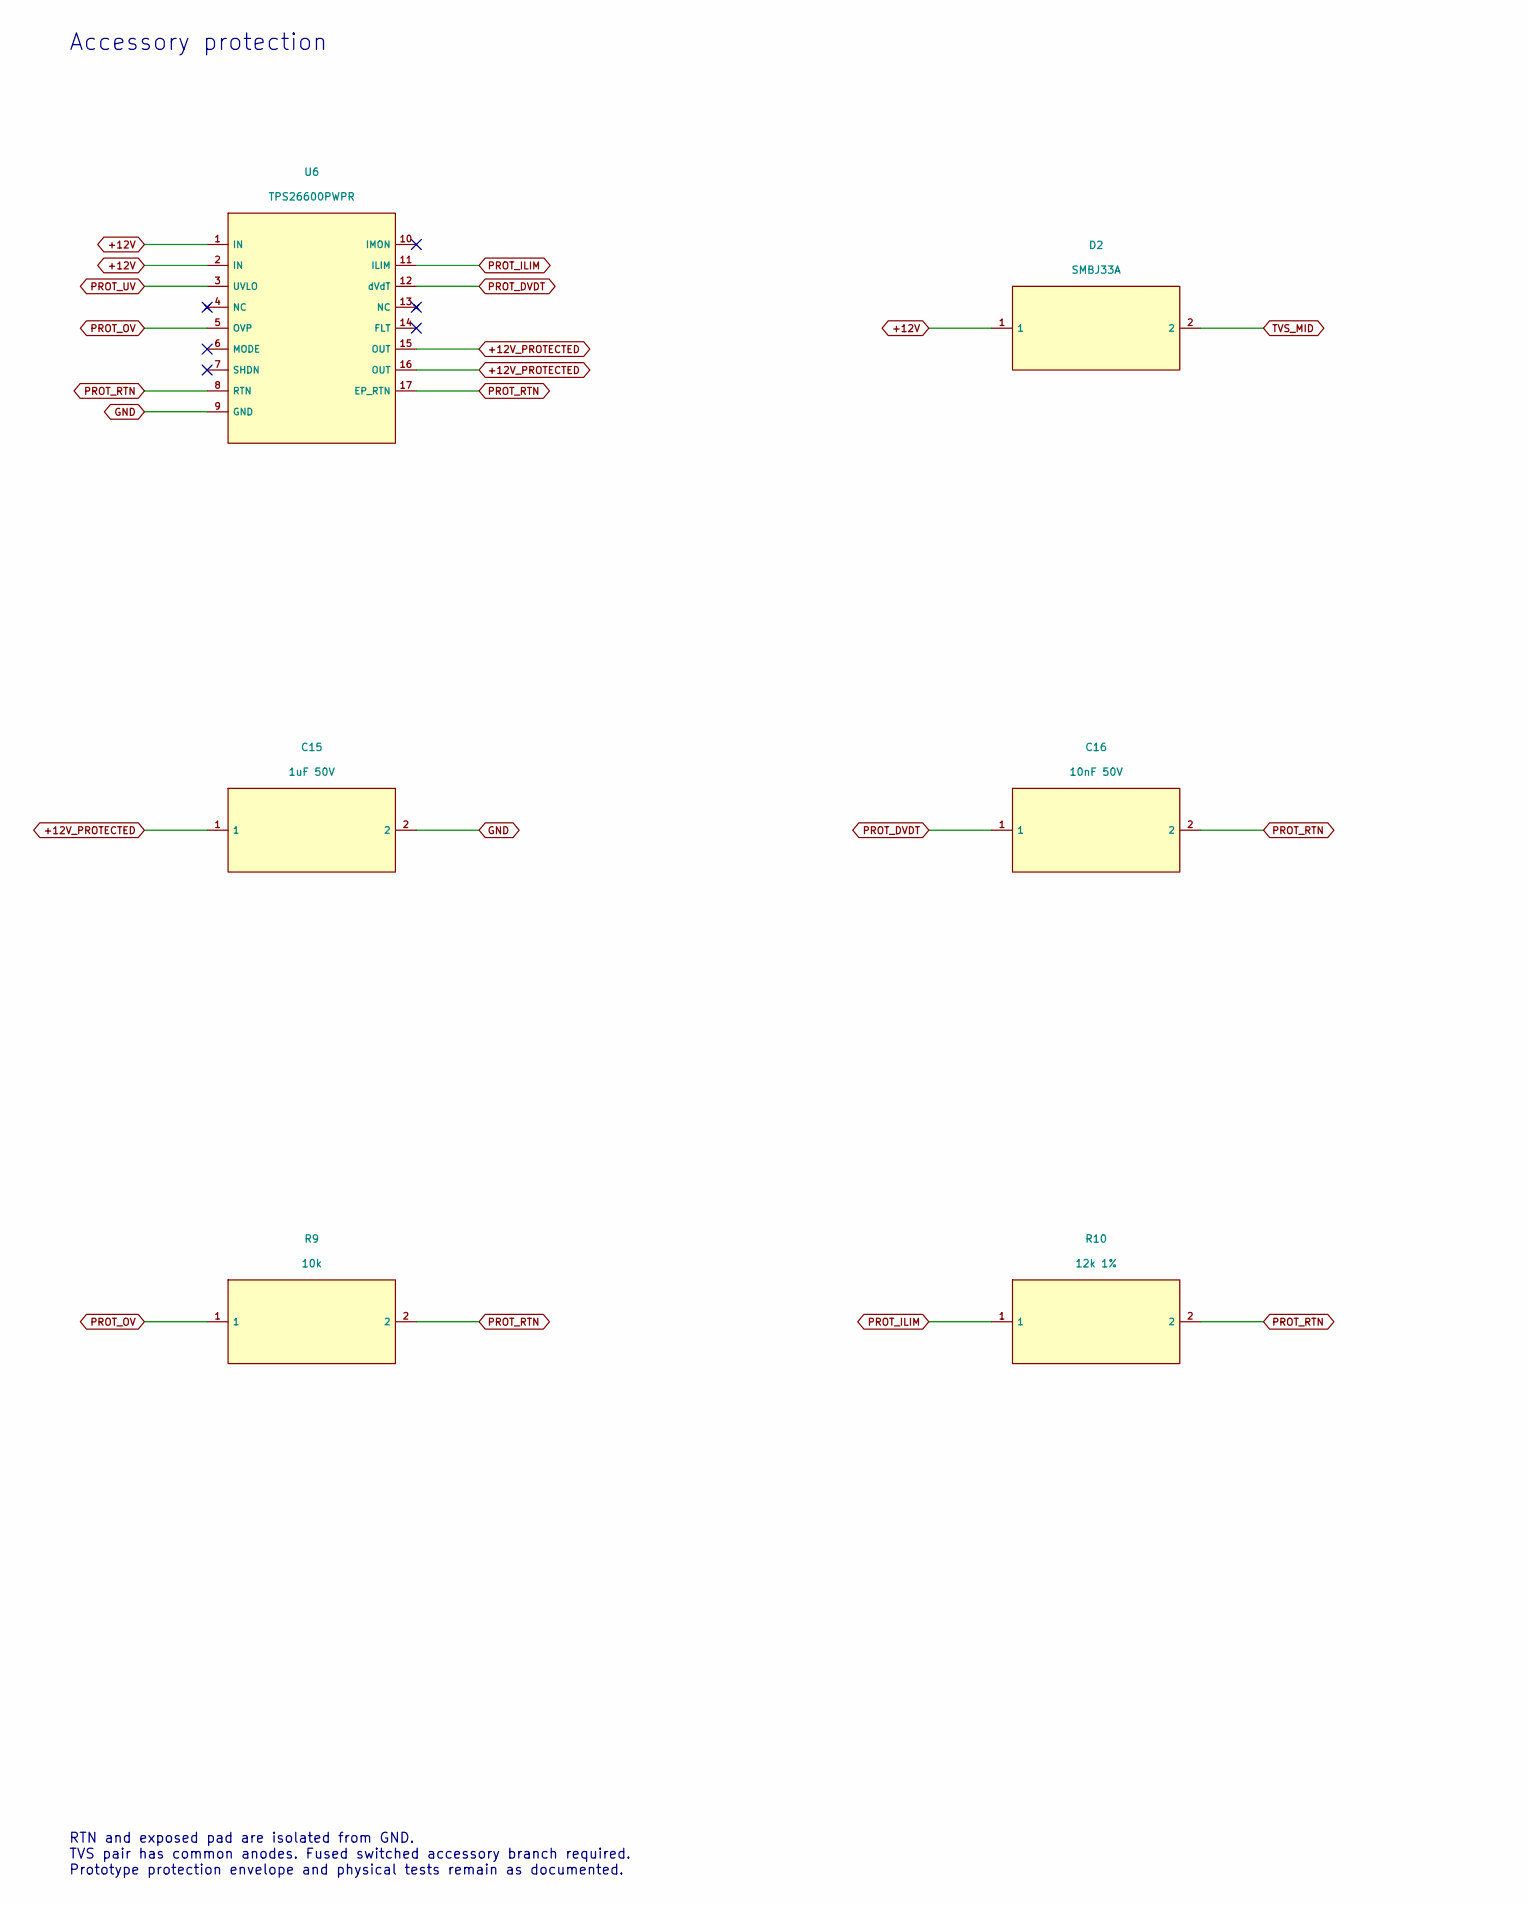
[picture p84: schematic sheet2.kicad_sch, RykerConnect - Accessory protection, part in row 1, column 1]

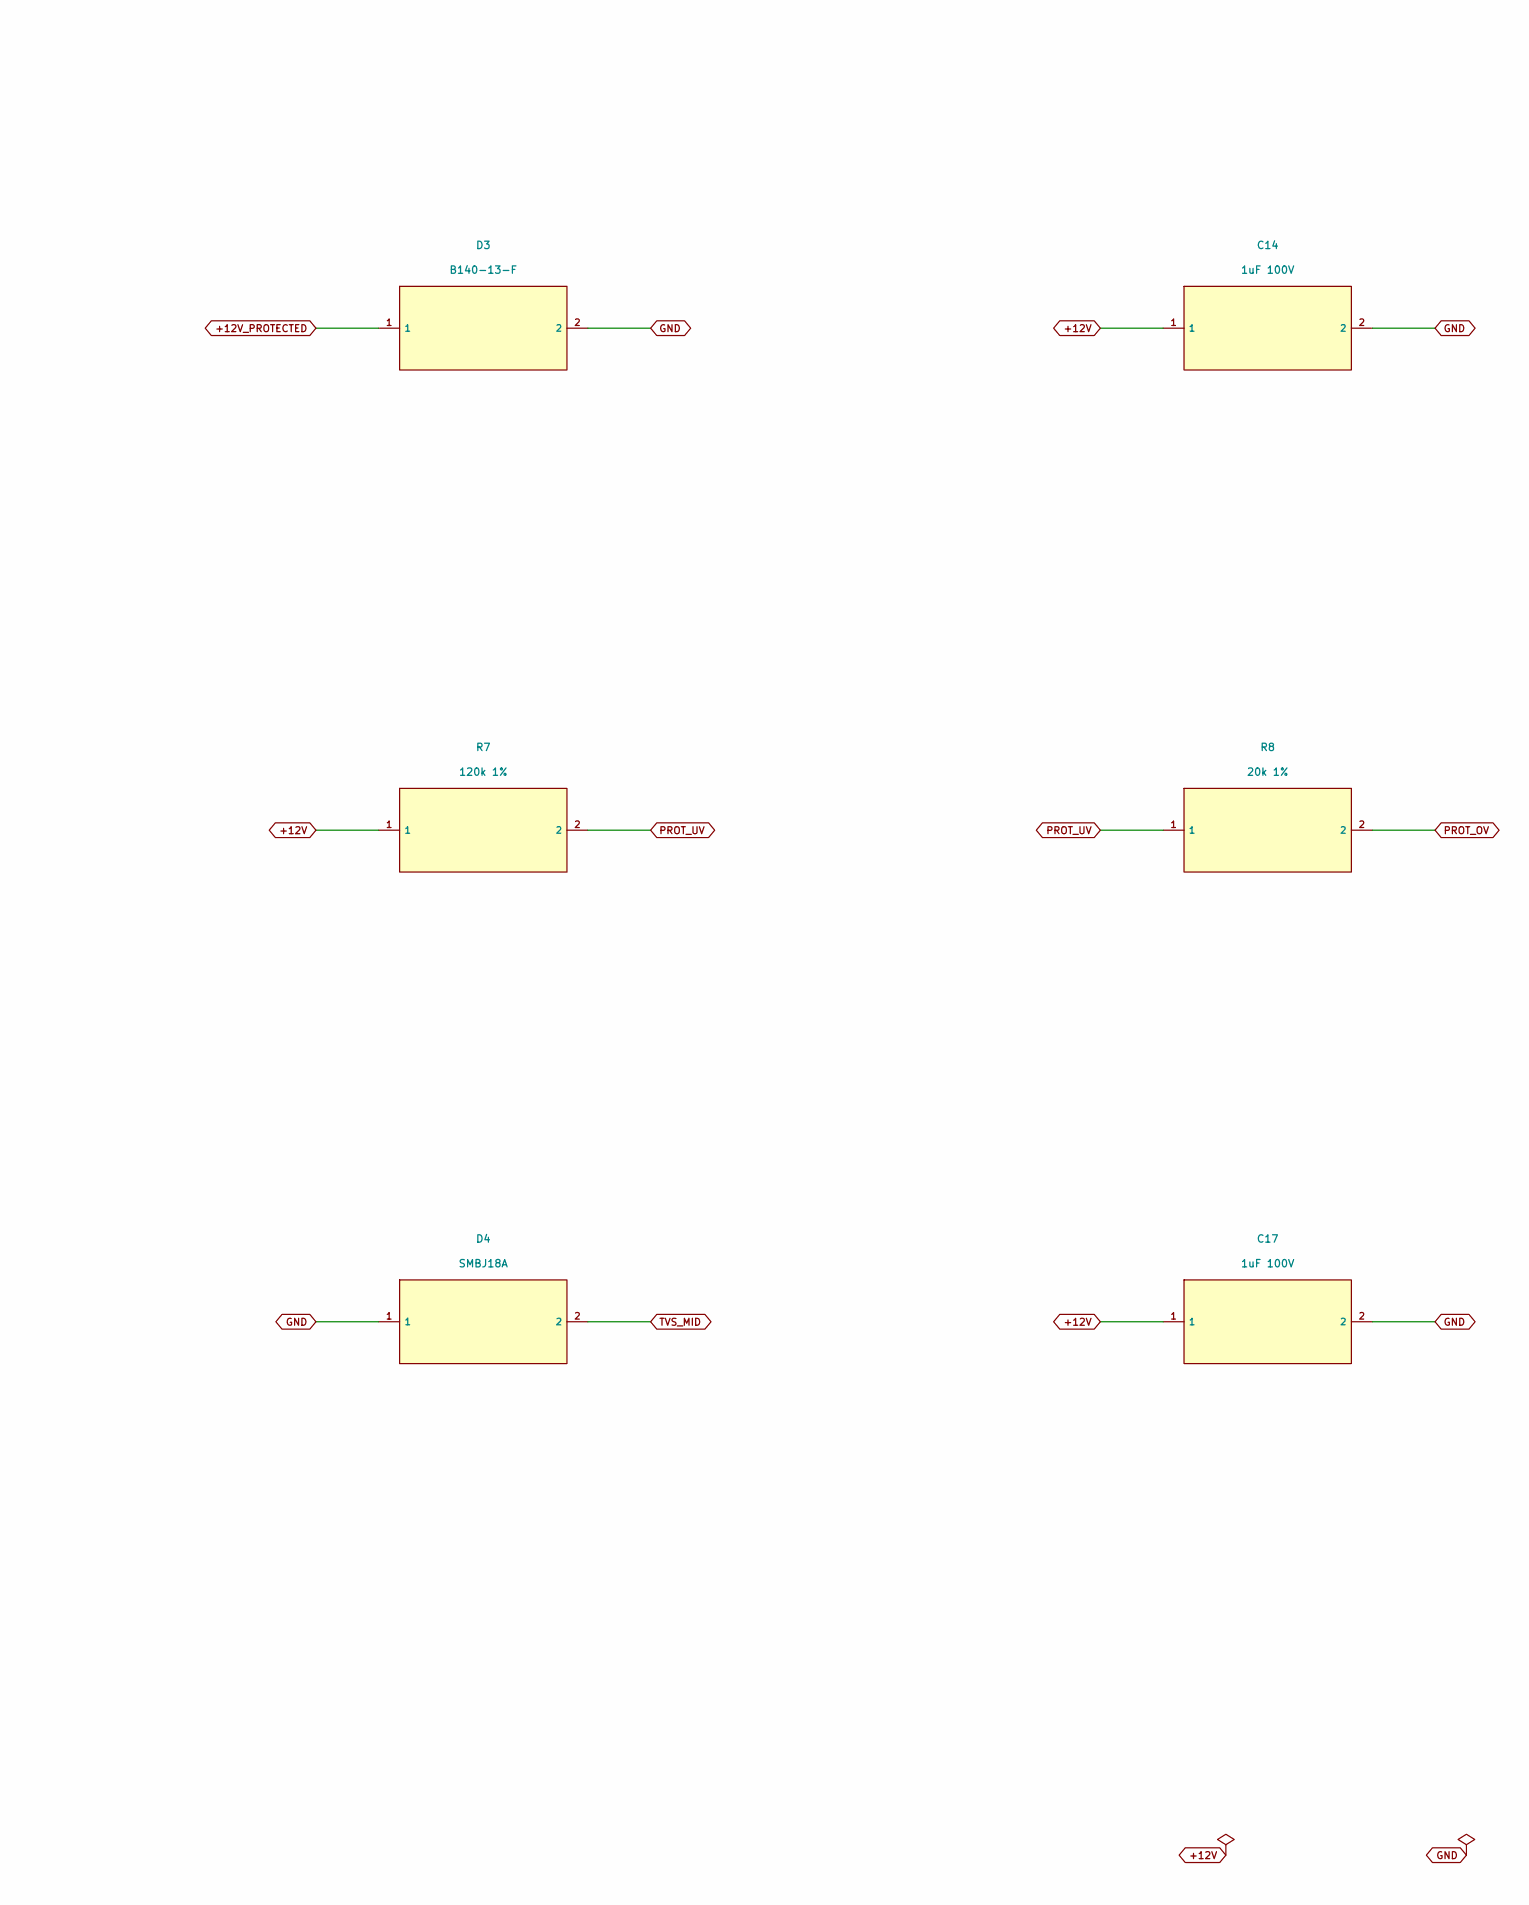
[picture p85: schematic sheet2.kicad_sch, RykerConnect - Accessory protection, part in row 1, column 2]

Parts:
C14: 1uF 100V; C14_C_1206_3216Metric; MPN CL31B105KCHNNNE; LCSC C13832
C15: 1uF 50V; C15_C_0805_2012Metric; MPN CL21B105KBFNNNE; LCSC C28323
C16: 10nF 50V; C16_C_0603_1608Metric; MPN CL10B103KB8NNNC; LCSC C1589
C17: 1uF 100V; C17_C_1206_3216Metric; MPN CL31B105KCHNNNE; LCSC C13832
D2: SMBJ33A; D2_D_SMB; MPN SMBJ33A; LCSC C224019
D3: B140-13-F; D3_D_SMA; MPN B140-13-F; LCSC C15759
D4: SMBJ18A; D4_D_SMB; MPN SMBJ18A; LCSC C151256
R7: 120k 1%; R7_R_0603_1608Metric; MPN RC0603FR-07120KL; LCSC C114607
R8: 20k 1%; R8_R_0603_1608Metric; MPN RC0603FR-0720KL; LCSC C105575
R9: 10k; R9_R_0603_1608Metric; MPN 0603WAF1002T5E; LCSC C25804
R10: 12k 1%; R10_R_0603_1608Metric; MPN RC0603FR-0712KL; LCSC C114659
U6: TPS26600PWPR; U6_U6_Protection_HTSSOP16_PWP0016A; MPN TPS26600PWPR; LCSC C544399

Connections:
+12V: C14.1, C17.1, D2.1, R7.1, U6.1 (IN), U6.2 (IN); also elsewhere on the board
+12V_PROTECTED: C15.1, D3.1, U6.15 (OUT), U6.16 (OUT); also elsewhere on the board
GND: C14.2, C15.2, C17.2, D3.2, D4.1, U6.9 (GND); also elsewhere on the board
PROT_DVDT: C16.1, U6.12 (dVdT)
PROT_ILIM: R10.1, U6.11 (ILIM)
PROT_OV: R8.2, R9.1, U6.5 (OVP)
PROT_RTN: C16.2, R9.2, R10.2, U6.8 (RTN), U6.17 (EP_RTN)
PROT_UV: R7.2, R8.1, U6.3 (UVLO)
TVS_MID: D2.2, D4.2

Notes on the sheet:
Accessory protection
RTN and exposed pad are isolated from GND. TVS pair has common anodes. Fused switched accessory branch required. Prototype protection envelope and physical tests remain as documented.

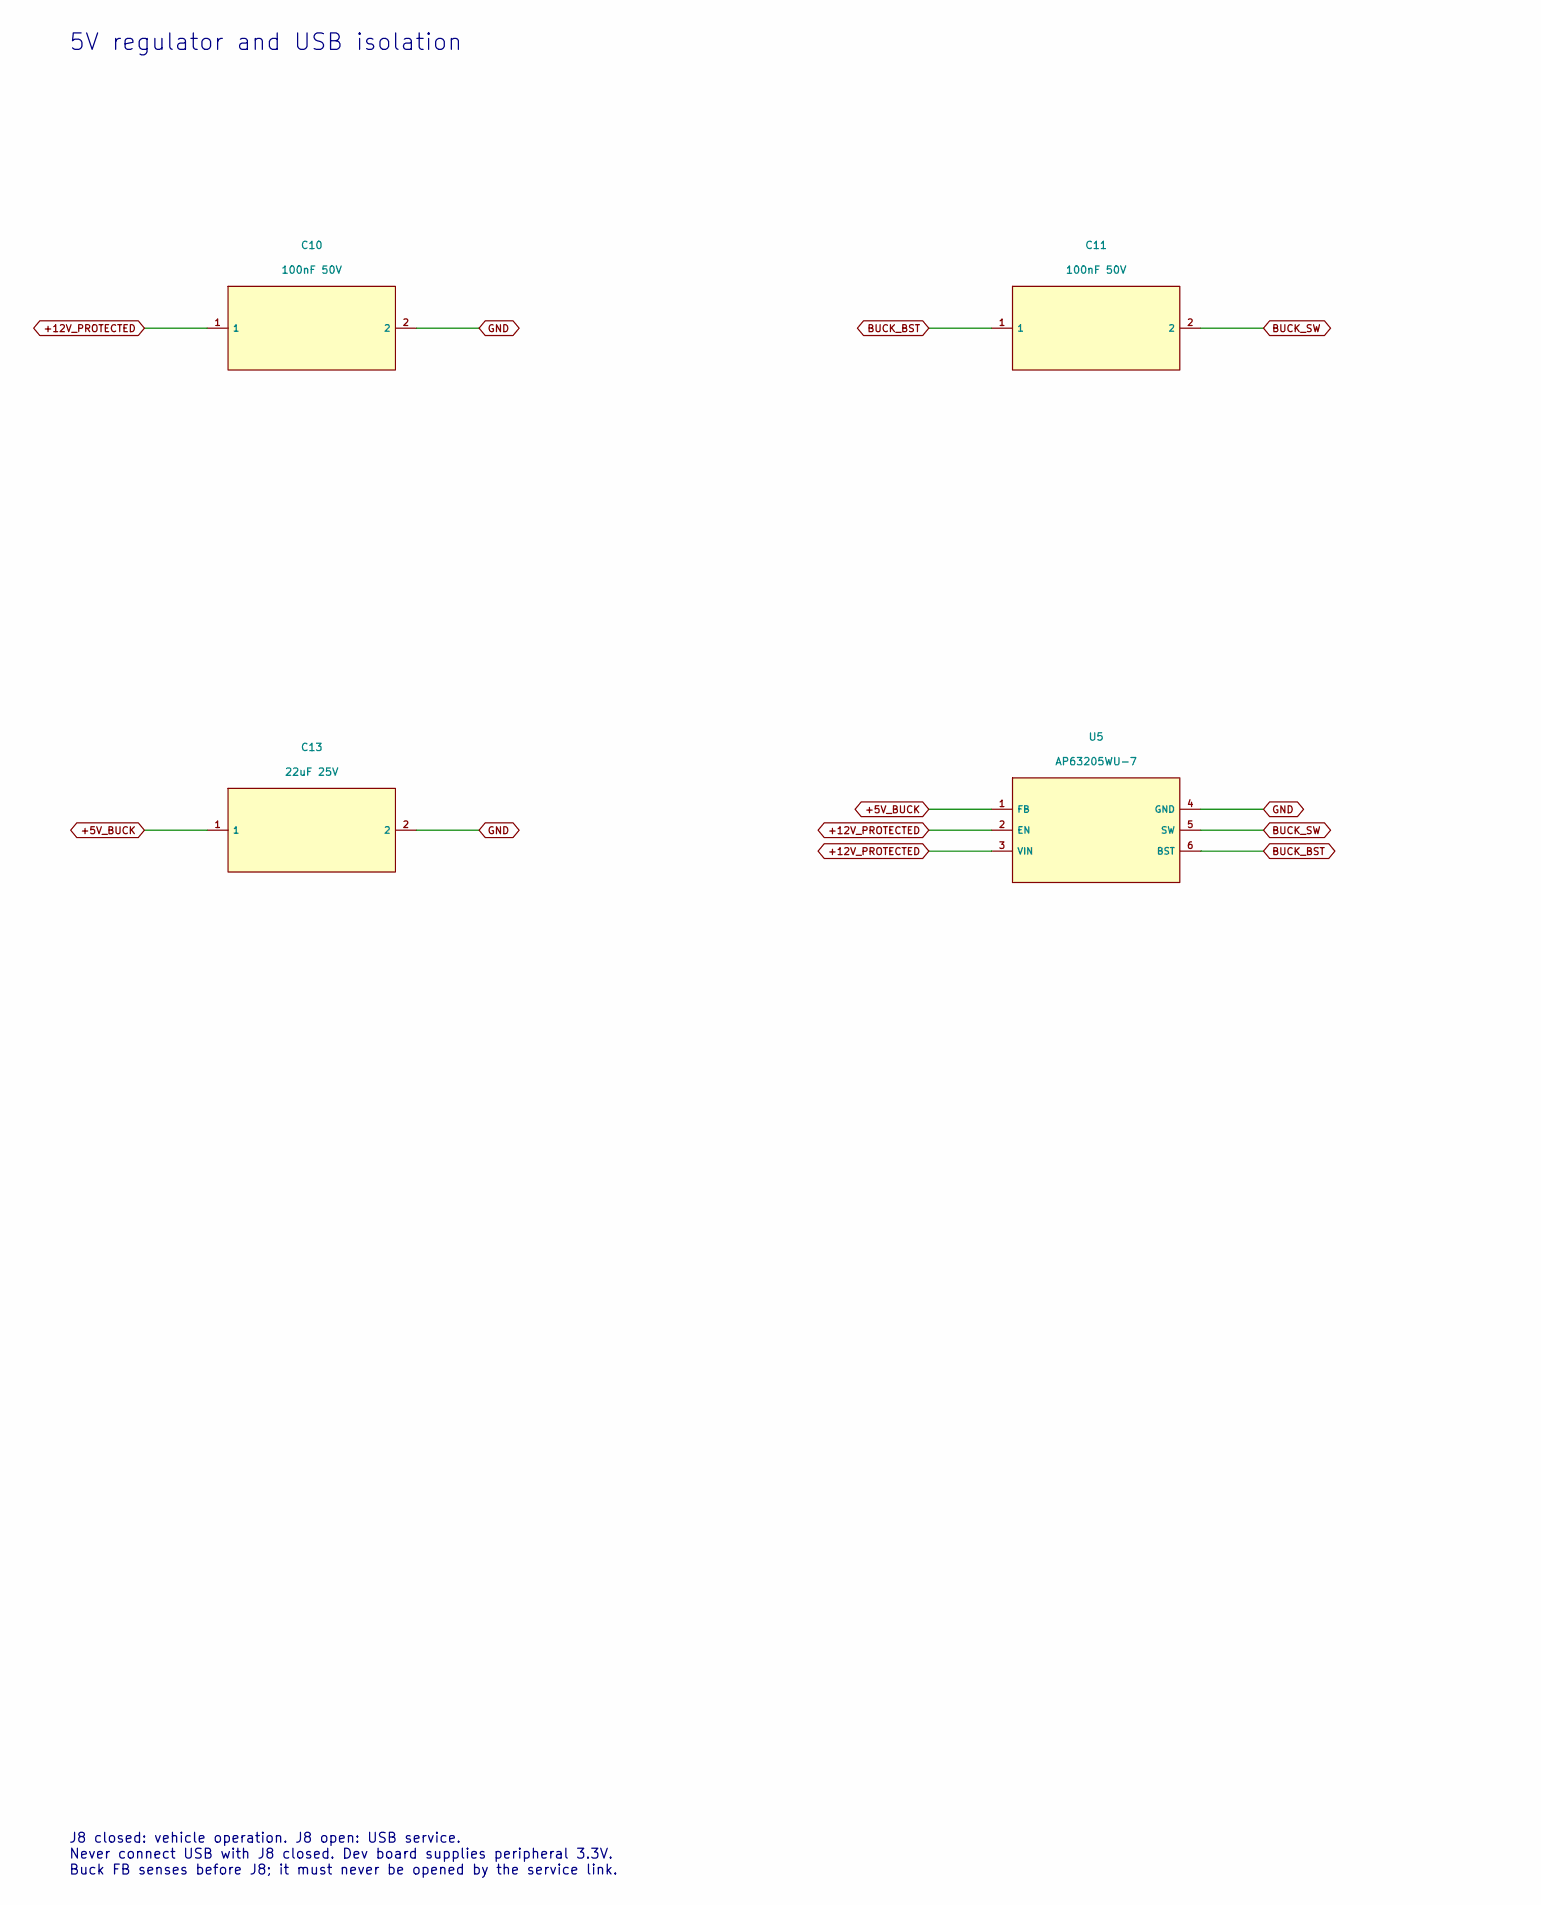
[picture p86: schematic sheet3.kicad_sch, RykerConnect - 5V regulator and USB isolation, part in row 1, column 1]

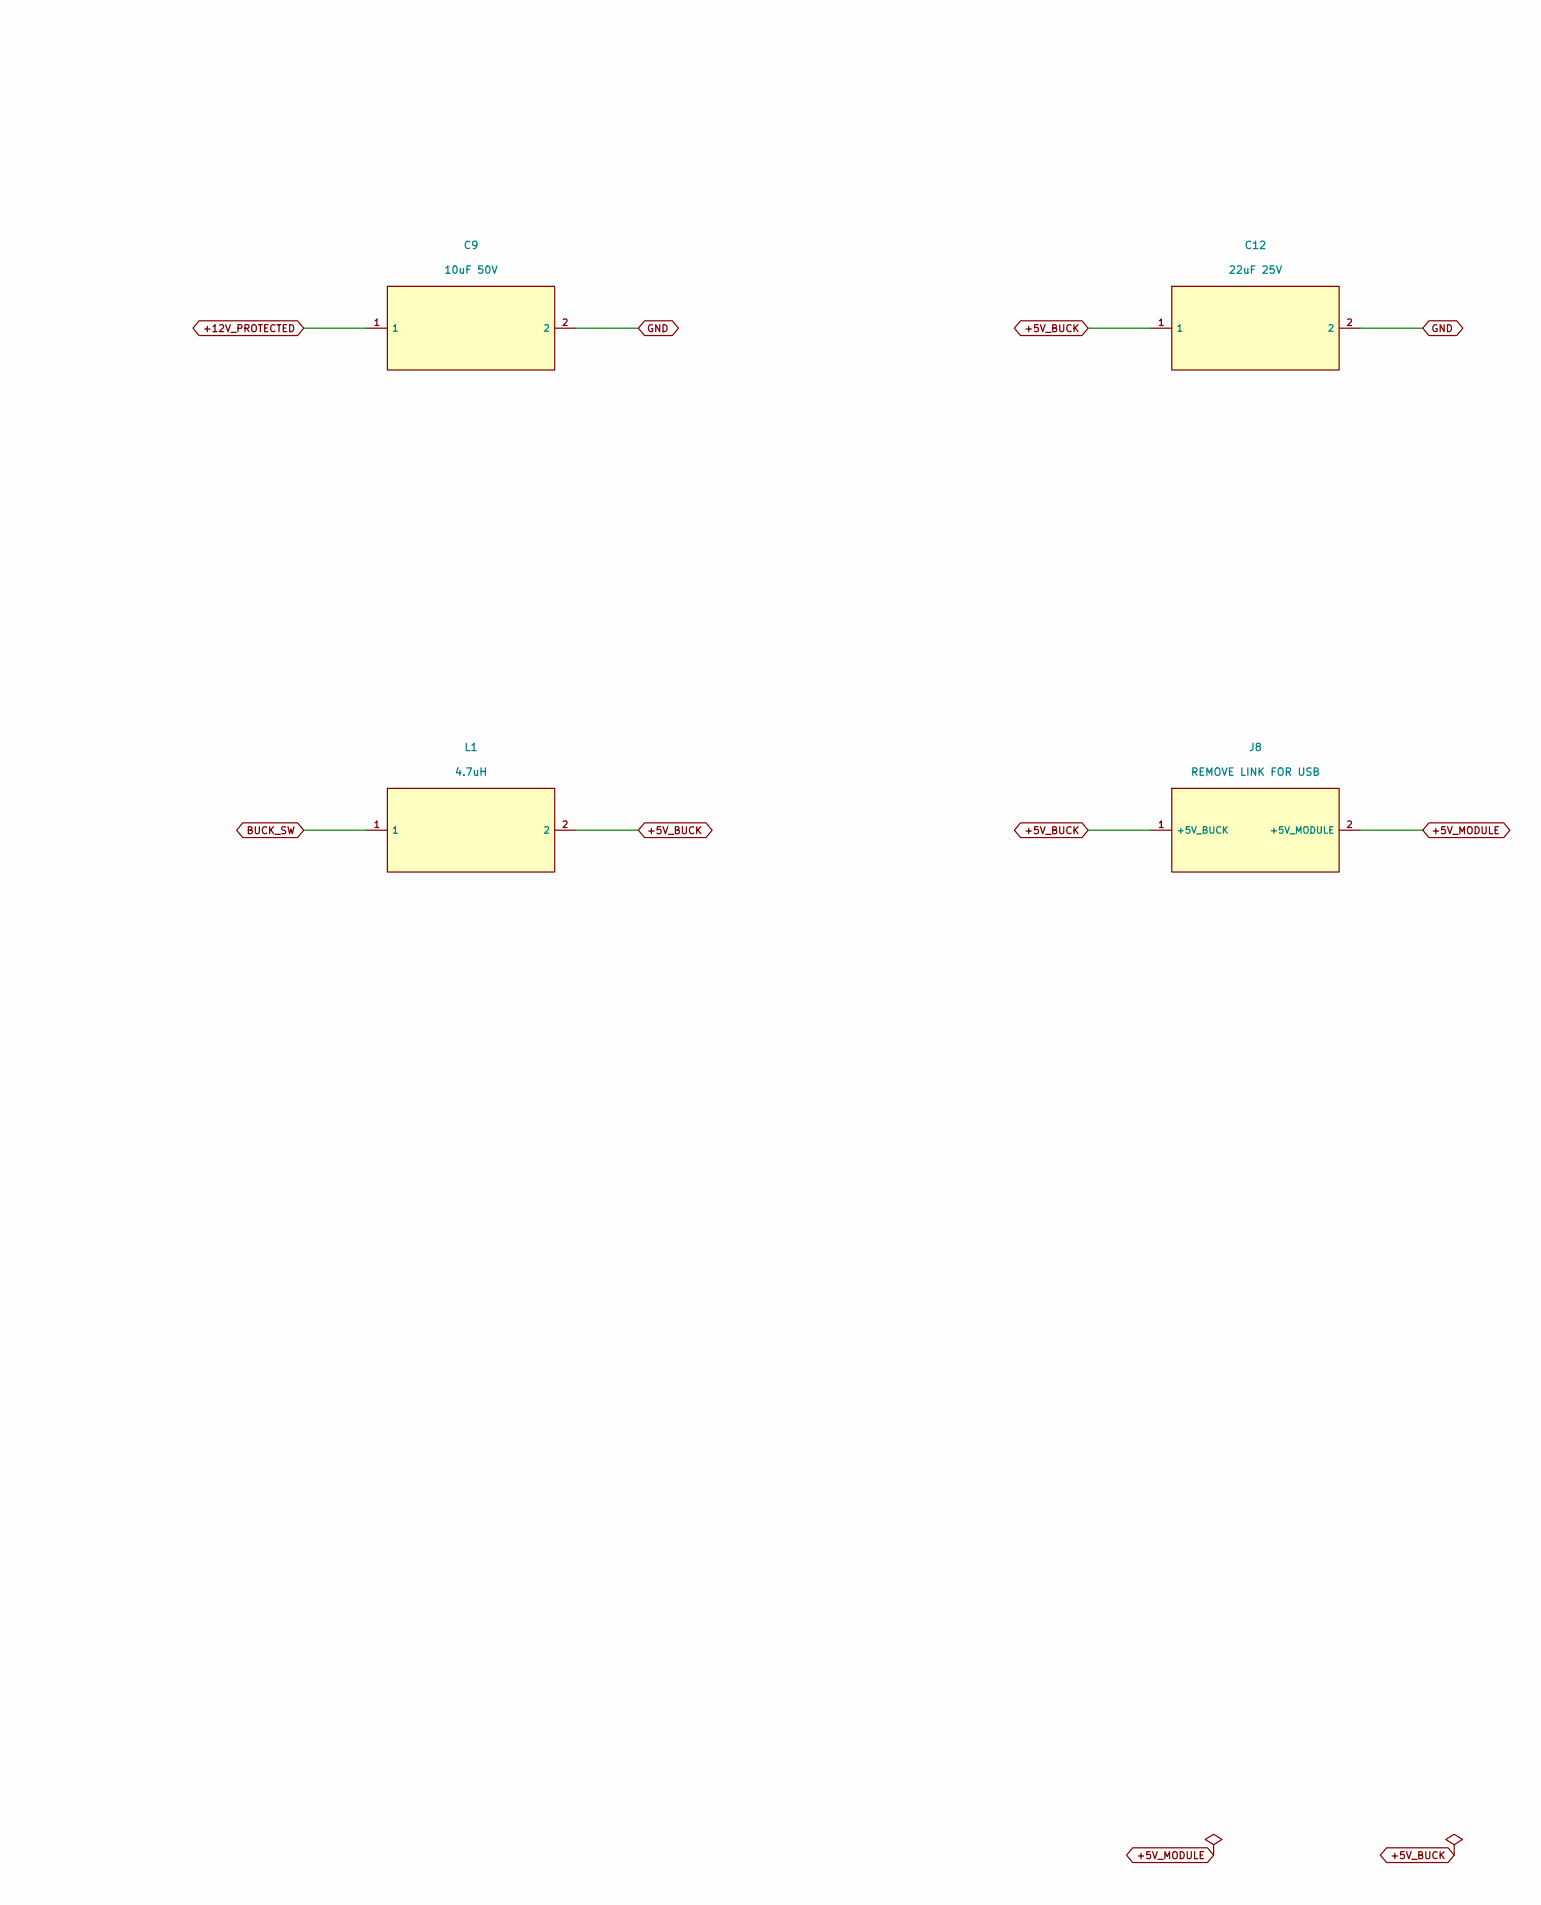
[picture p87: schematic sheet3.kicad_sch, RykerConnect - 5V regulator and USB isolation, part in row 1, column 2]

Parts:
C9: 10uF 50V; C9_C_1206_3216Metric; MPN CL31A106KBHNNNE; LCSC C13585
C10: 100nF 50V; C10_C_0603_1608Metric; MPN CL10B104KB8NNNC; LCSC C1591
C11: 100nF 50V; C11_C_0603_1608Metric; MPN CL10B104KB8NNNC; LCSC C1591
C12: 22uF 25V; C12_C_0805_2012Metric; MPN CL21A226MAQNNNE; LCSC C45783
C13: 22uF 25V; C13_C_0805_2012Metric; MPN CL21A226MAQNNNE; LCSC C45783
J8: REMOVE LINK FOR USB; J8_PinHeader_1x02_P2.54mm_Vertical; MPN 5AML4-11560-102-W0; LCSC C29780898
L1: 4.7uH; L1_L1_INDPM5653X430N; MPN 744316470; LCSC C2651181
U5: AP63205WU-7; U5_TSOT-23-6; MPN AP63205WU-7; LCSC C2071056

Connections:
+5V_BUCK: C12.1, C13.1, J8.1 (+5V_BUCK), L1.2, U5.1 (FB)
+5V_MODULE: J8.2 (+5V_MODULE); also elsewhere on the board
+12V_PROTECTED: C9.1, C10.1, U5.2 (EN), U5.3 (VIN); also elsewhere on the board
BUCK_BST: C11.1, U5.6 (BST)
BUCK_SW: C11.2, L1.1, U5.5 (SW)
GND: C9.2, C10.2, C12.2, C13.2, U5.4 (GND); also elsewhere on the board

Notes on the sheet:
5V regulator and USB isolation
J8 closed: vehicle operation. J8 open: USB service. Never connect USB with J8 closed. Dev board supplies peripheral 3.3V. Buck FB senses before J8; it must never be opened by the service link.

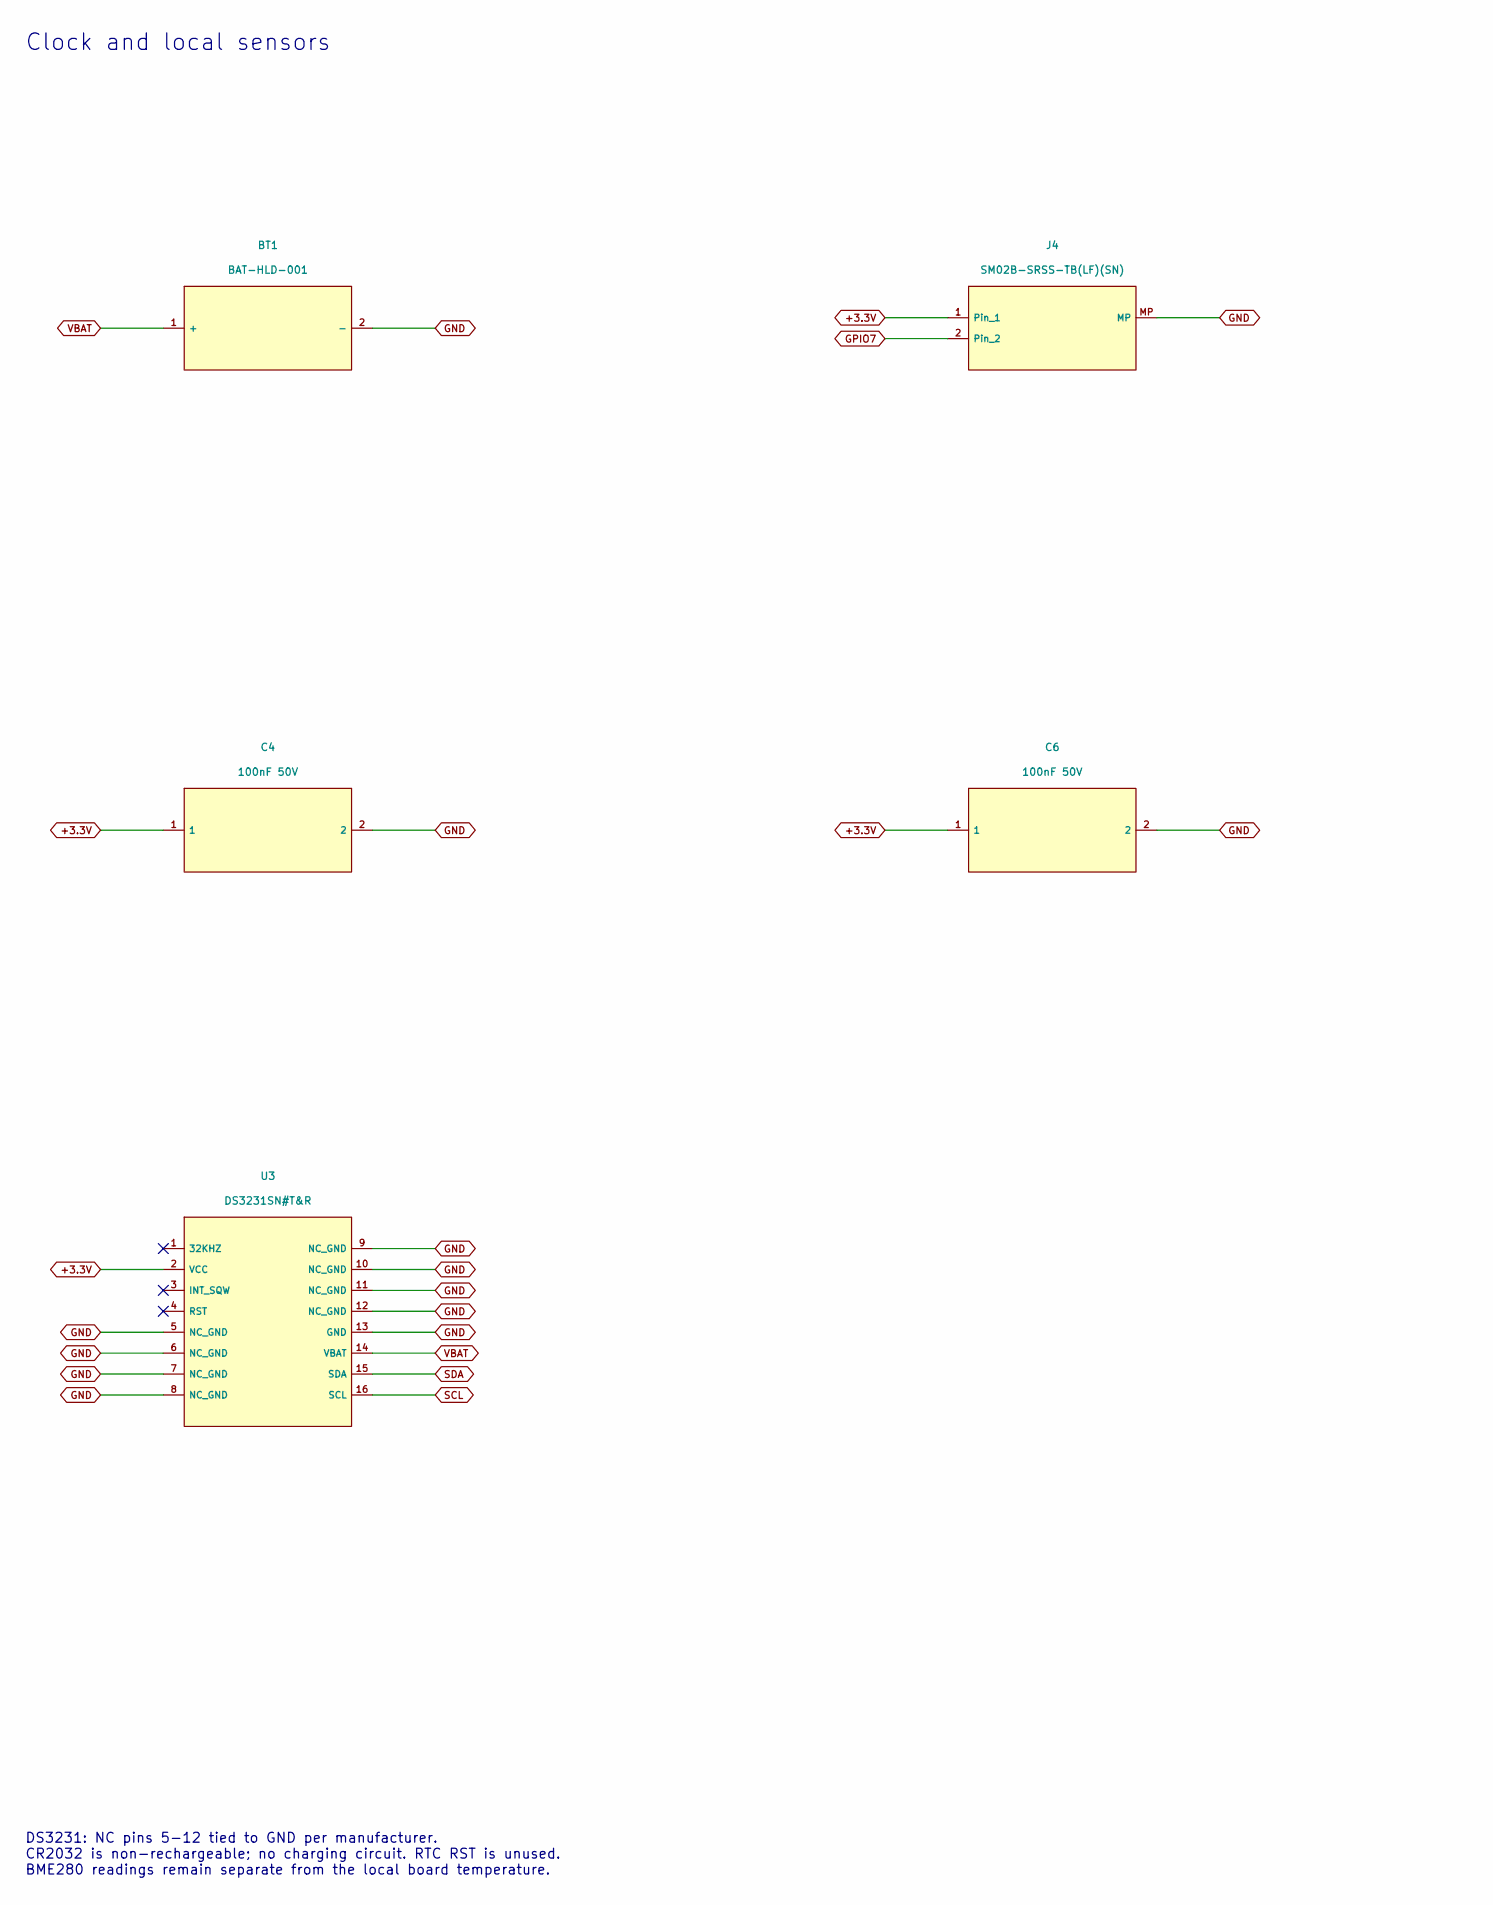
[picture p88: schematic sheet4.kicad_sch, RykerConnect - Clock and local sensors, part in row 1, column 1]

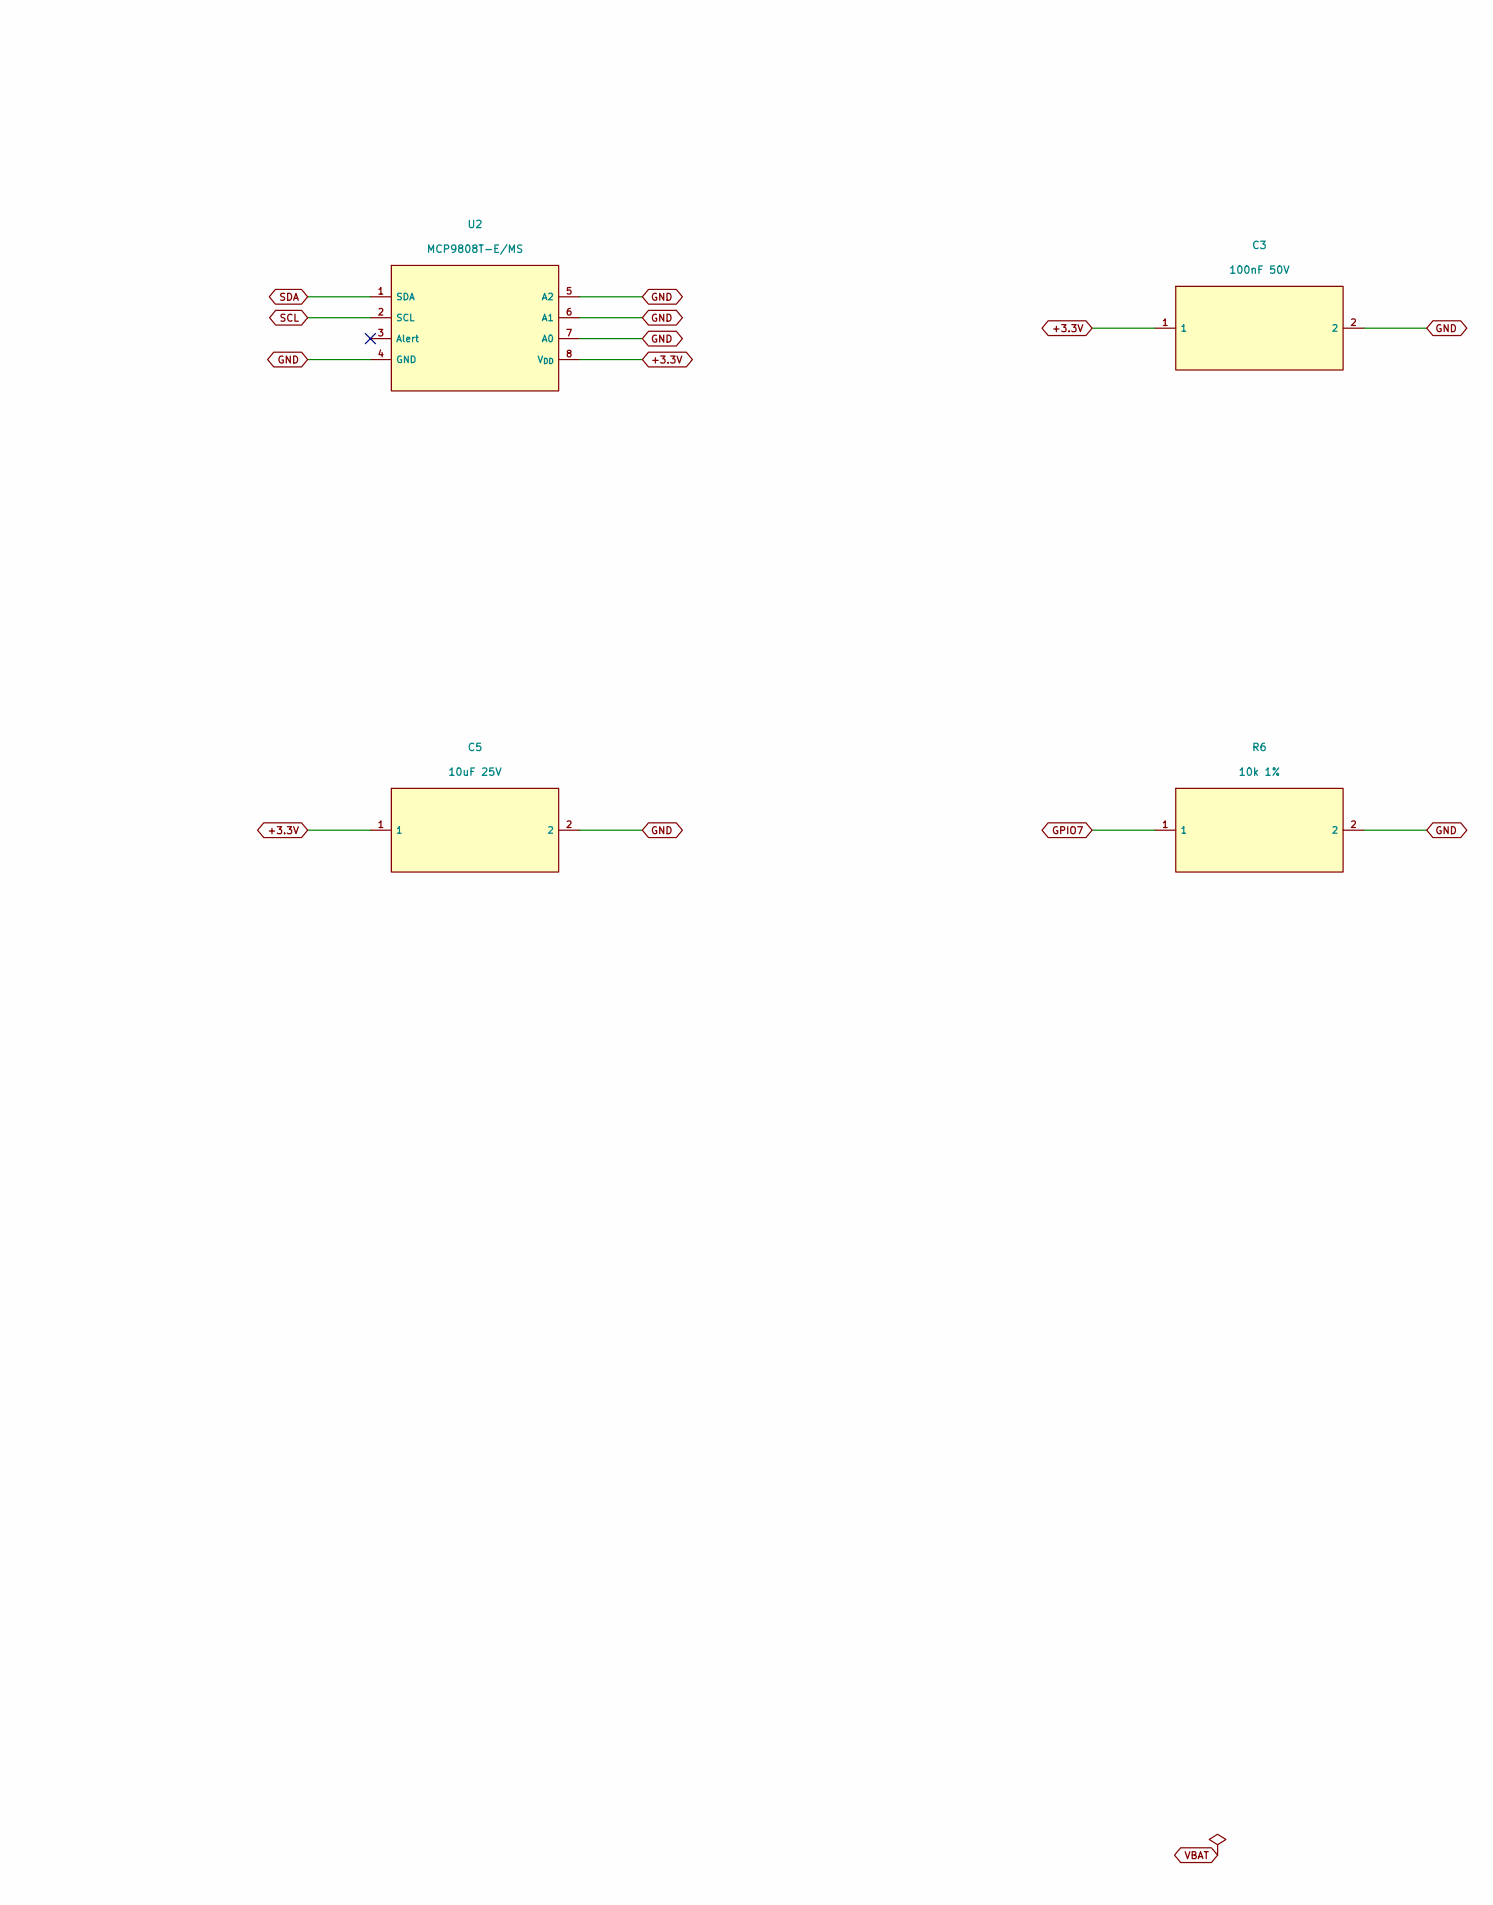
[picture p89: schematic sheet4.kicad_sch, RykerConnect - Clock and local sensors, part in row 1, column 2]

Parts:
BT1: BAT-HLD-001; BT1_BT1_BATHLD001; MPN BAT-HLD-001; LCSC C7501066
C3: 100nF 50V; C3_C_0603_1608Metric; MPN CL10B104KB8NNNC; LCSC C1591
C4: 100nF 50V; C4_C_0603_1608Metric; MPN CL10B104KB8NNNC; LCSC C1591
C5: 10uF 25V; C5_C_0603_1608Metric; MPN CL10A106MA8NRNC; LCSC C96446
C6: 100nF 50V; C6_C_0603_1608Metric; MPN CL10B104KB8NNNC; LCSC C1591
J4: SM02B-SRSS-TB(LF)(SN); J4_J4_JST_SH_SM02B-SRSS-TB_1x02-1MP_P1.00mm_Horizontal; MPN SM02B-SRSS-TB(LF)(SN); LCSC C160402
R6: 10k 1%; R6_R_0603_1608Metric; MPN 0603WAF1002T5E; LCSC C25804
U2: MCP9808T-E/MS; U2_U2_MSOP-8_3x3mm_P0.65mm; MPN MCP9808T-E/MS; LCSC C129490
U3: DS3231SN#T&R; U3_SOIC-16W_7.5x10.3mm_P1.27mm; MPN DS3231SN#T&R; LCSC C9866

Connections:
+3.3V: C3.1, C4.1, C5.1, C6.1, J4.1, U2.8 (V_{DD}), U3.2 (VCC); also elsewhere on the board
GND: BT1.2 (-), C3.2, C4.2, C5.2, C6.2, J4.MP, R6.2, U2.4 (GND), U2.5 (A2), U2.6 (A1), U2.7 (A0), U3.5 (NC_GND), U3.6 (NC_GND), U3.7 (NC_GND), U3.8 (NC_GND), U3.9 (NC_GND), U3.10 (NC_GND), U3.11 (NC_GND), U3.12 (NC_GND), U3.13 (GND); also elsewhere on the board
GPIO7: J4.2, R6.1; also elsewhere on the board
SCL: U2.2 (SCL), U3.16 (SCL); also elsewhere on the board
SDA: U2.1 (SDA), U3.15 (SDA); also elsewhere on the board
VBAT: BT1.1 (+), U3.14 (VBAT)

Notes on the sheet:
Clock and local sensors
DS3231: NC pins 5-12 tied to GND per manufacturer. CR2032 is non-rechargeable; no charging circuit. RTC RST is unused. BME280 readings remain separate from the local board temperature.

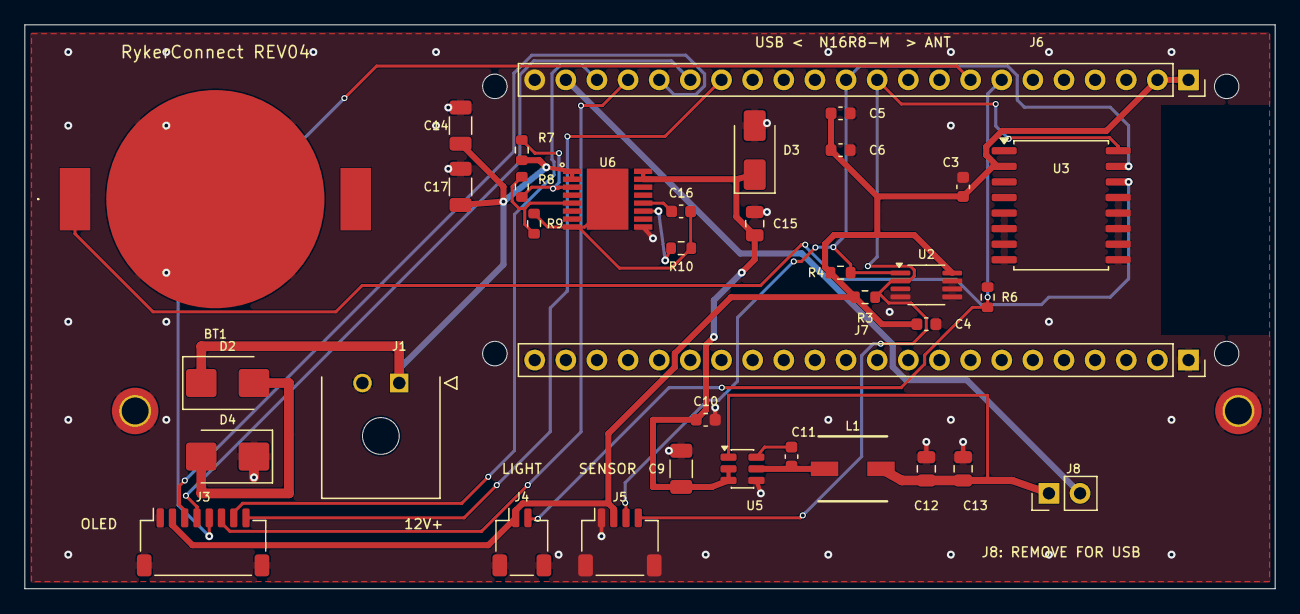
[picture p90: board Hardware/REV04-Carrier/RykerConnect.kicad_pcb from above]

Board: 2 copper layers, 102.0 x 46.0 mm, 42 parts (1 on the bottom side), 24 nets.

Other parts of the board:
H1: MountingHole_Pad; H1_MountingHole_2.2mm_M2_ISO14580_Pad_TopBottom
H2: MountingHole_Pad; H2_MountingHole_2.2mm_M2_ISO14580_Pad_TopBottom
H3: Module retention - 2mm NPTH; H3_ModuleRetention
H4: Module retention - 2mm NPTH; H4_ModuleRetention
H5: Module retention - 2mm NPTH; H5_ModuleRetention
H6: Module retention - 2mm NPTH; H6_ModuleRetention

Their connections:
GND: H1.1 (1_1), H2.1 (1_1); also elsewhere on the board
