neo12242/RykerConnect/Hardware/REV03-Protected/render_previews.py

from pathlib import Path
import pypdfium2 as pdf
from PIL import Image,ImageChops
R=Path(__file__).resolve().parent/'validation'
for name in ['board-F','board-B','assembly-B']:
 im=pdf.PdfDocument(str(R/f'{name}.pdf'))[0].render(scale=5).to_pil().convert('RGB')
 box=ImageChops.difference(im,Image.new('RGB',im.size,'white')).getbbox();im.crop(box).save(R/f'{name}.png')
d=pdf.PdfDocument(str(R/'schematics.pdf'));d[2].render(scale=1.5).to_pil().save(R/'protection-schematic.png')
print('Rendered current board and schematic previews.')
