neo12242/RykerConnect/(commit log)

2026-09-16 Consolidate Android, simulator, firmware and JLCPCB prototypes with setup guides
    [BOM.csv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]
2026-09-16 Add illustrated README tour with reviewed demo screenshots and PCB artwork
